Esmartdriver/esmart-hw-lib-pub/3dmodel/bga/BGA6N50P2X3_144X94X50.step

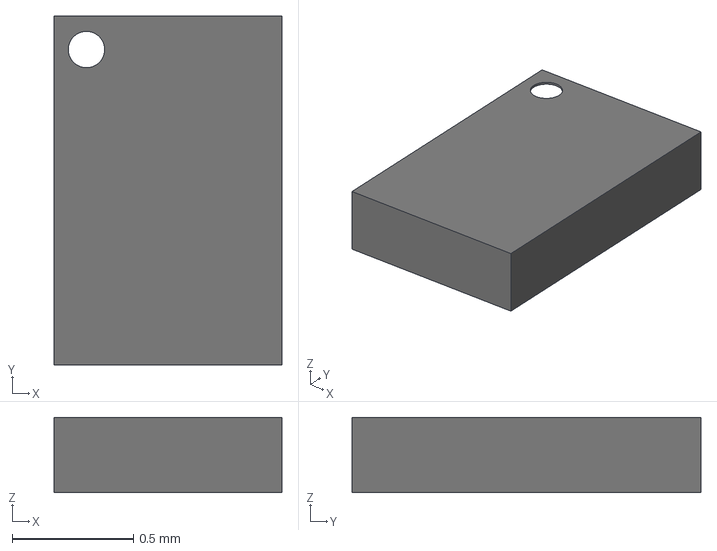
[picture p1: CAD file, 2025-03-11]
3dmodel/bga/BGA6N50P2X3_144X94X50.step
0.94 x 1.44 x 0.31 mm
