Esmartdriver/esmart-hw-lib-pub/3dmodel/clock/OSC3225-4.STEP

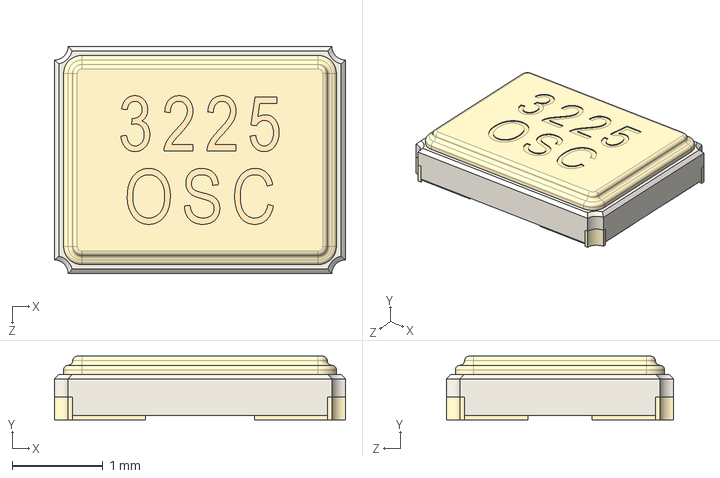
[picture p2: CAD file, 2025-03-11]
3dmodel/clock/OSC3225-4.STEP
3.20 x 0.7 x 2.50 mm
