Esmartdriver/esmart-hw-lib-pub/3dmodel/connector/PinHeader_2x07_P1.27mm_Vertical.step

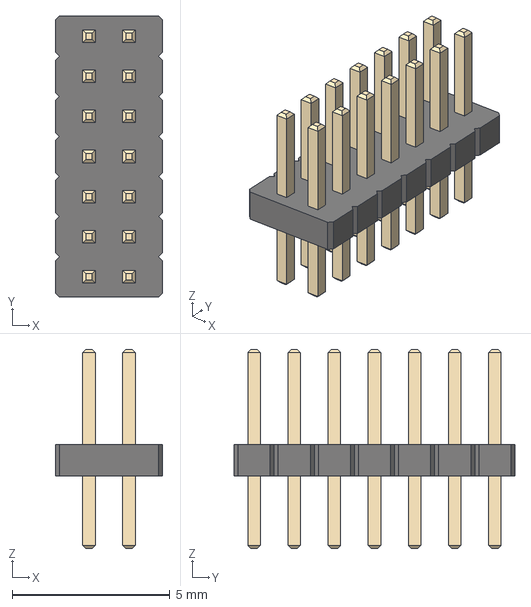
[picture p3: CAD file, 2025-03-11]
3dmodel/connector/PinHeader_2x07_P1.27mm_Vertical.step
3.40 x 8.89 x 6.30 mm
