Esmartdriver/esmart-hw-lib-pub/3dmodel/dfn/DFN100X100X55-5.step

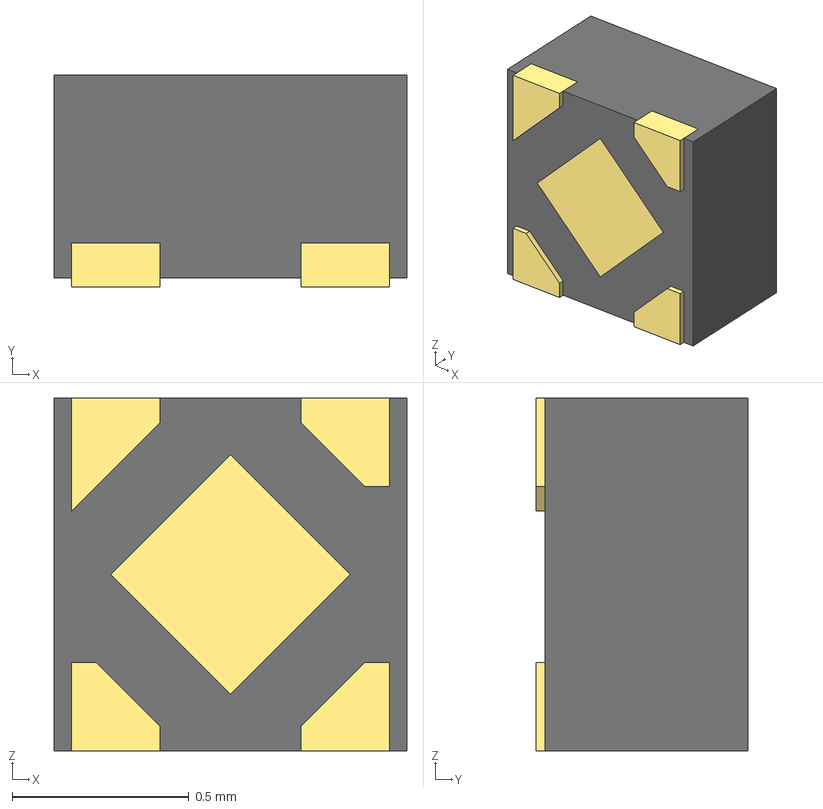
[picture p4: CAD file, 2025-03-11]
3dmodel/dfn/DFN100X100X55-5.step
1.00 x 0.6 x 1.00 mm
