Esmartdriver/esmart-hw-lib-pub/3dmodel/diode/Diode_SMC.step

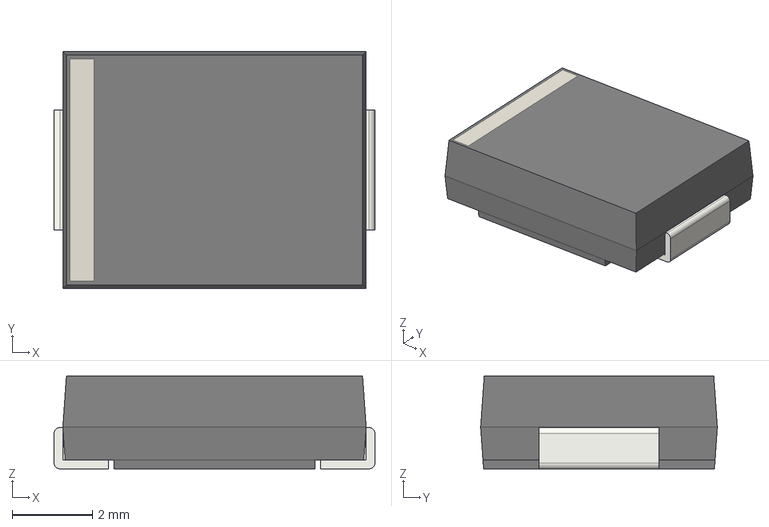
[picture p5: CAD file, 2025-03-11]
3dmodel/diode/Diode_SMC.step
8.00 x 5.90 x 2.31 mm
