Esmartdriver/esmart-hw-lib-pub/3dmodel/dip/DIP127P762X508-14.step

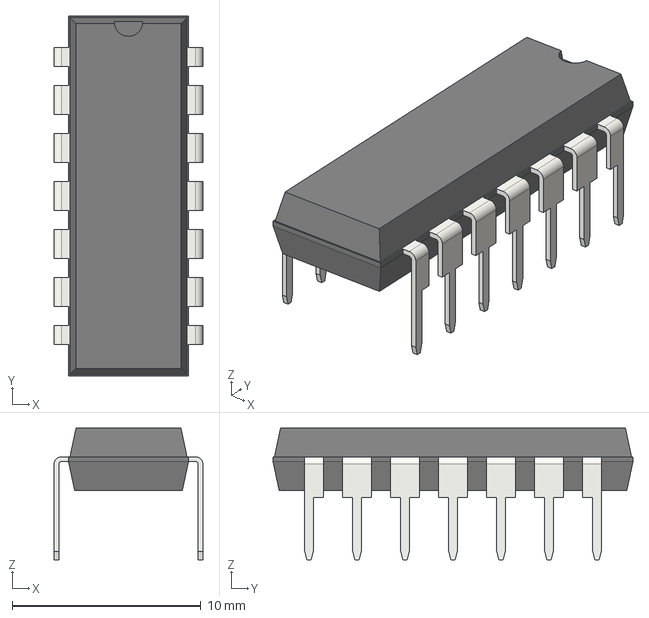
[picture p6: CAD file, 2025-03-11]
3dmodel/dip/DIP127P762X508-14.step
7.87 x 19.1 x 6.98 mm
