Esmartdriver/esmart-hw-lib-pub/3dmodel/led/LED_1608m_White.step

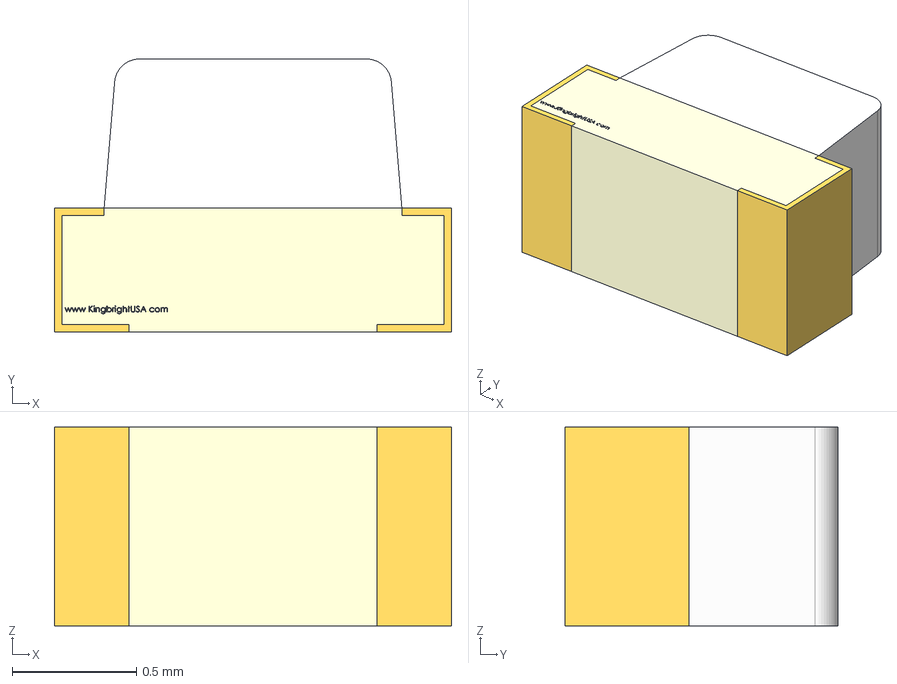
[picture p7: CAD file, 2025-03-11]
3dmodel/led/LED_1608m_White.step
1.60 x 1.10 x 0.8 mm
AP1608
AP1611
AP1610
AP1612
AP1609
