Esmartdriver/esmart-hw-lib-pub/3dmodel/lga/LGA50P300X250-14.step

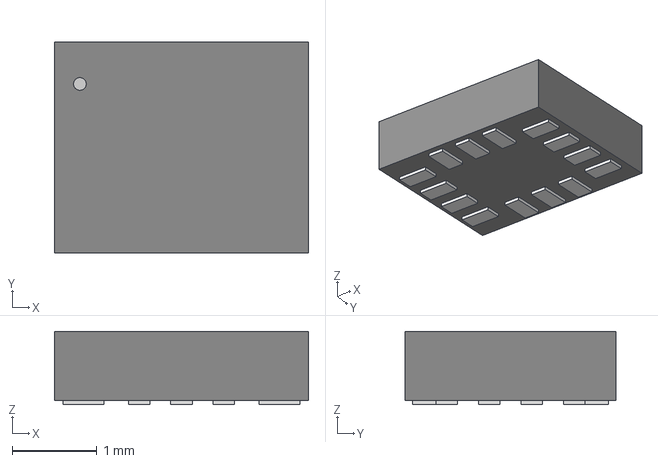
[picture p8: CAD file, 2025-03-11]
3dmodel/lga/LGA50P300X250-14.step
3.00 x 2.49 x 0.866 mm
