Esmartdriver/esmart-hw-lib-pub/3dmodel/mechanical/C&K_PN12SJNA03QE.stp

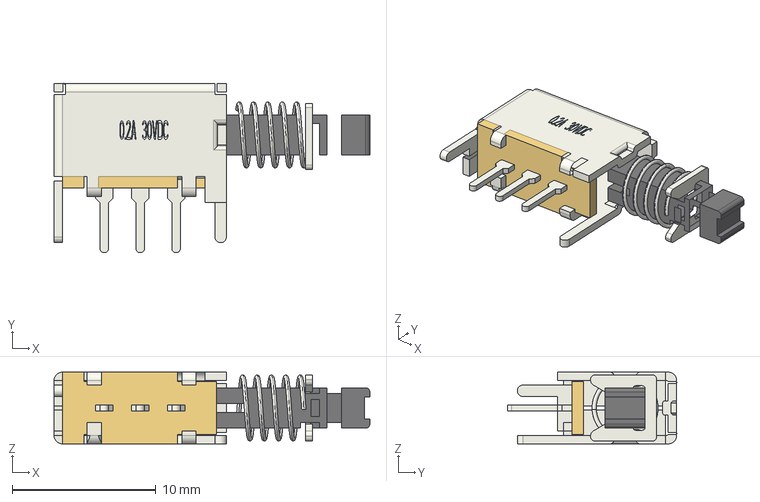
[picture p9: CAD file, 2025-03-11]
3dmodel/mechanical/C&K_PN12SJNA03QE.stp
22.0 x 11.8 x 5.00 mm
