Esmartdriver/esmart-hw-lib-pub/3dmodel/other/Knowles_SPU0410HR5H-PB.step

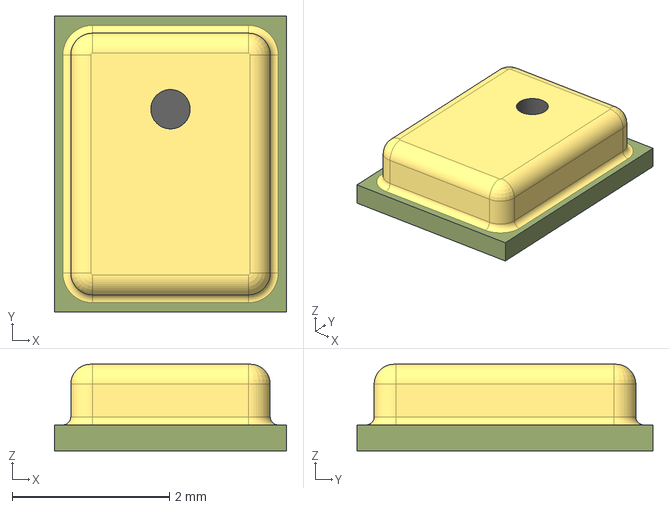
[picture p10: CAD file, 2025-03-11]
3dmodel/other/Knowles_SPU0410HR5H-PB.step
2.95 x 3.76 x 1.10 mm
