Esmartdriver/esmart-hw-lib-pub/3dmodel/passive/RESC1608.step

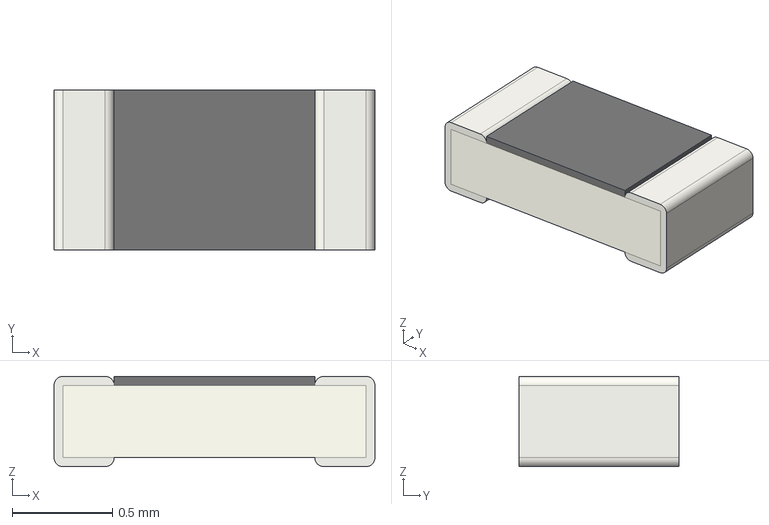
[picture p11: CAD file, 2025-03-11]
3dmodel/passive/RESC1608.step
1.60 x 0.8 x 0.45 mm
