Esmartdriver/esmart-hw-lib-pub/3dmodel/qfn/QFN50P160X160-8.step

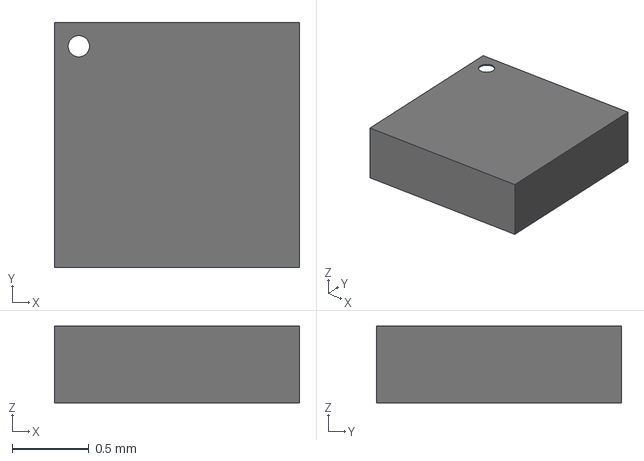
[picture p12: CAD file, 2025-03-11]
3dmodel/qfn/QFN50P160X160-8.step
1.60 x 1.60 x 0.5 mm
