Esmartdriver/esmart-hw-lib-pub/3dmodel/qfp/QFP50P700X700X120-48.step

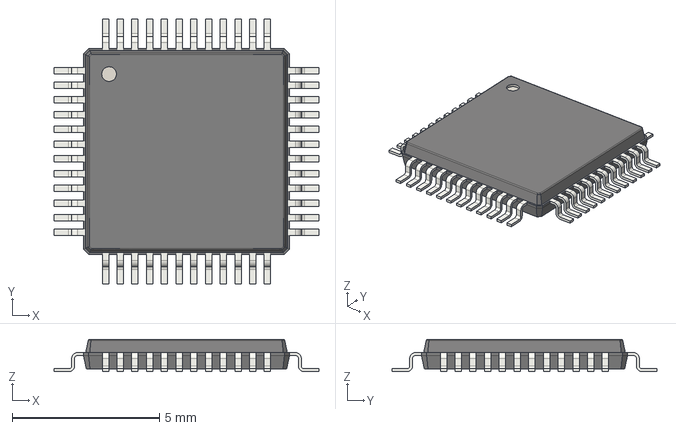
[picture p13: CAD file, 2025-03-11]
3dmodel/qfp/QFP50P700X700X120-48.step
9.00 x 9.00 x 1.10 mm
