Esmartdriver/esmart-hw-lib-pub/3dmodel/rf/johanson_0896BM15A0032.step

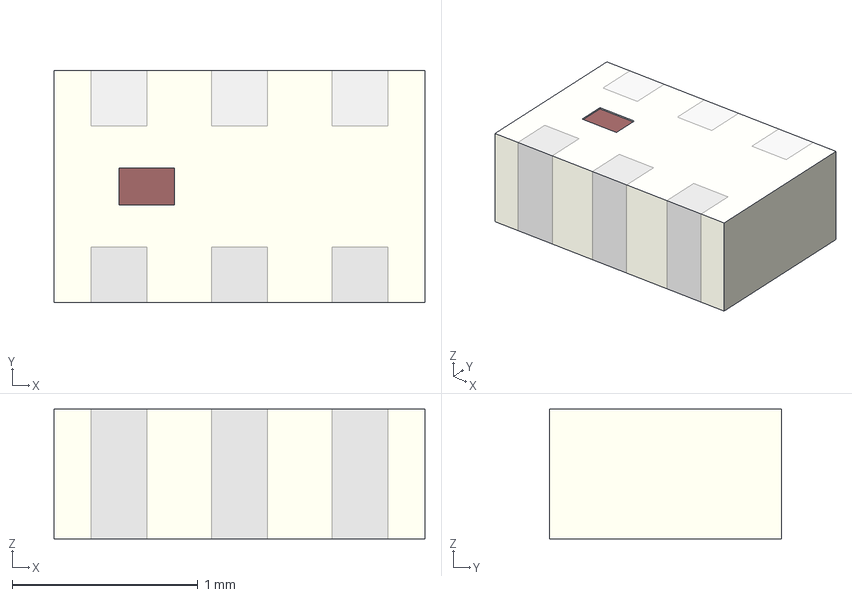
[picture p14: CAD file, 2025-03-11]
3dmodel/rf/johanson_0896BM15A0032.step
2.00 x 1.25 x 0.7 mm
