Esmartdriver/esmart-hw-lib-pub/3dmodel/so/PG-HSOF-8-1.step

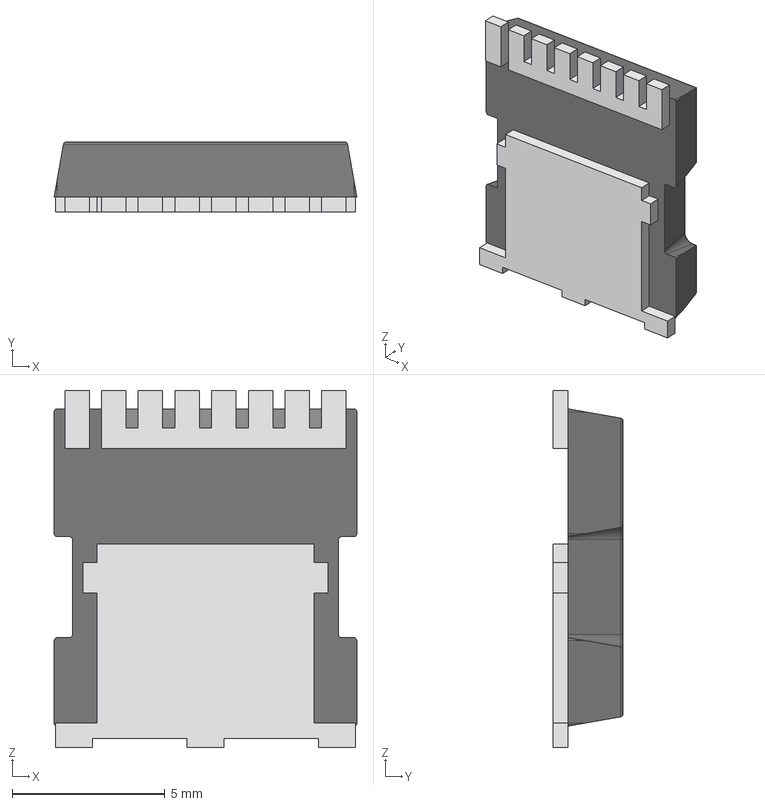
[picture p15: CAD file, 2025-03-11]
3dmodel/so/PG-HSOF-8-1.step
9.90 x 2.30 x 11.7 mm
