Esmartdriver/esmart-hw-lib-pub/3dmodel/sod/SOD-123F.step

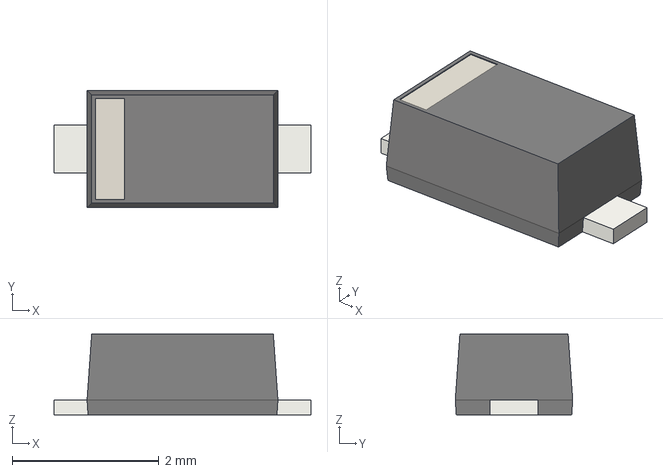
[picture p16: CAD file, 2025-03-11]
3dmodel/sod/SOD-123F.step
3.50 x 1.60 x 1.10 mm
