Esmartdriver/esmart-hw-lib-pub/3dmodel/soic/SOIC127P1790X750-28.step

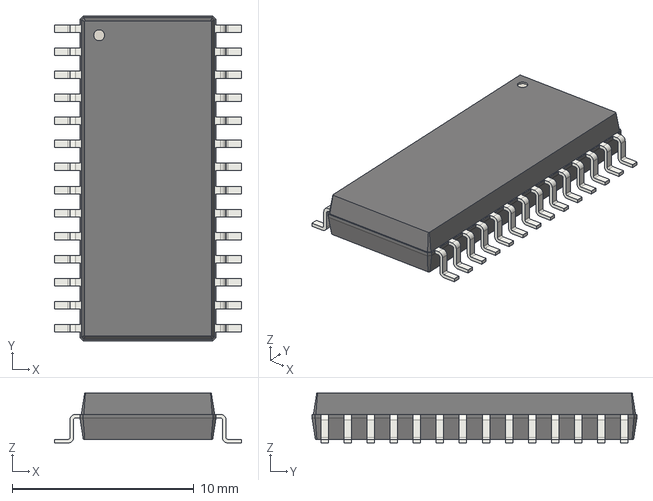
[picture p17: CAD file, 2025-03-11]
3dmodel/soic/SOIC127P1790X750-28.step
10.3 x 17.9 x 2.75 mm
