Esmartdriver/esmart-hw-lib-pub/3dmodel/som/silabs_MGM111.step

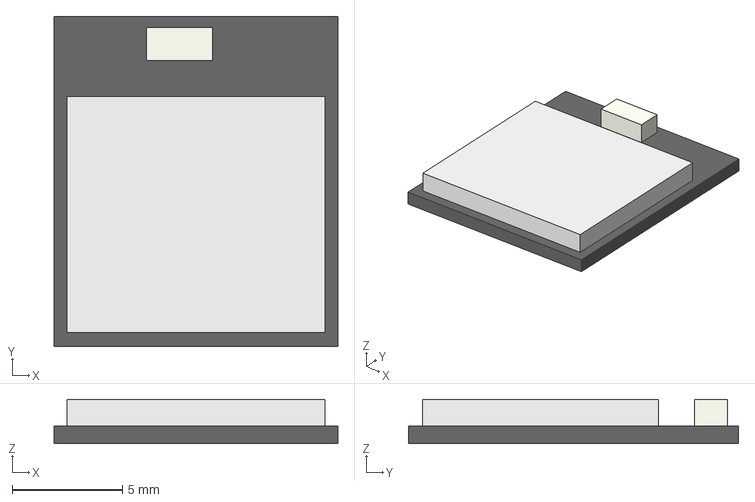
[picture p18: CAD file, 2025-03-11]
3dmodel/som/silabs_MGM111.step
12.9 x 15.0 x 2.00 mm
