Esmartdriver/esmart-hw-lib-pub/3dmodel/son/SON50P200X200X60-7.step

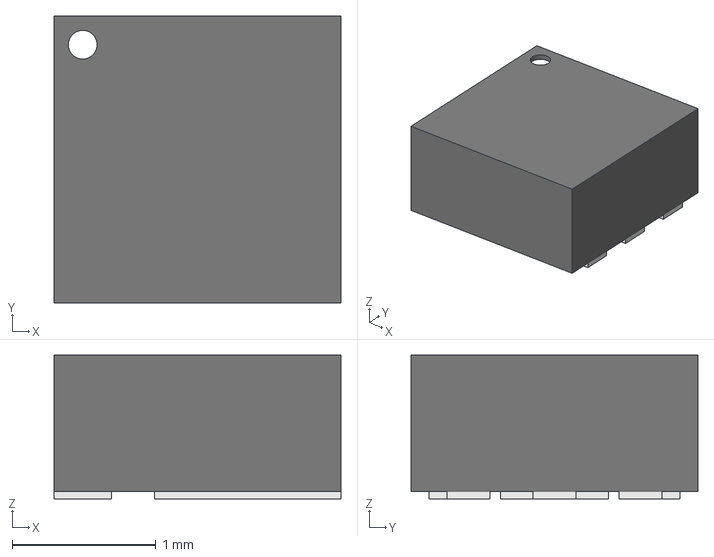
[picture p19: CAD file, 2025-03-11]
3dmodel/son/SON50P200X200X60-7.step
2.00 x 2.00 x 1.00 mm
