Esmartdriver/esmart-hw-lib-pub/3dmodel/sop/MSOP50P400X300-16.step

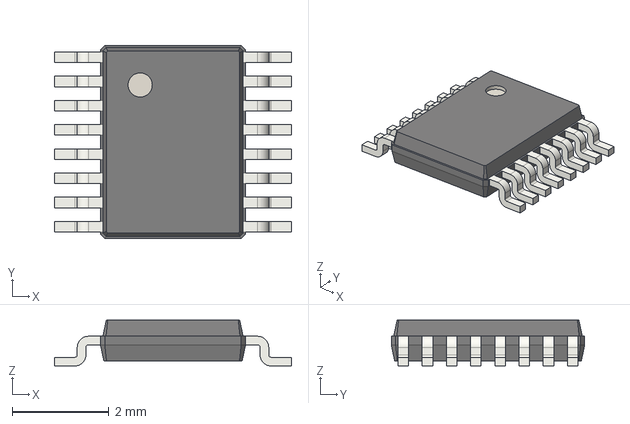
[picture p20: CAD file, 2025-03-11]
3dmodel/sop/MSOP50P400X300-16.step
4.90 x 4.00 x 0.95 mm
