Esmartdriver/esmart-hw-lib-pub/3dmodel/sot/SOT-665.step

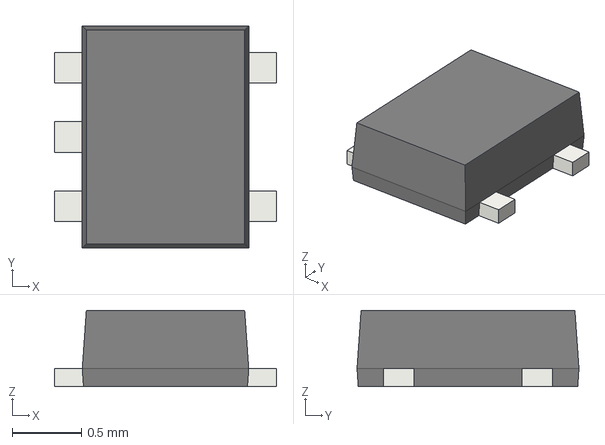
[picture p21: CAD file, 2025-03-11]
3dmodel/sot/SOT-665.step
1.60 x 1.60 x 0.55 mm
