Esmartdriver/esmart-hw-lib-pub/3dmodel/to/TO-220-3.step

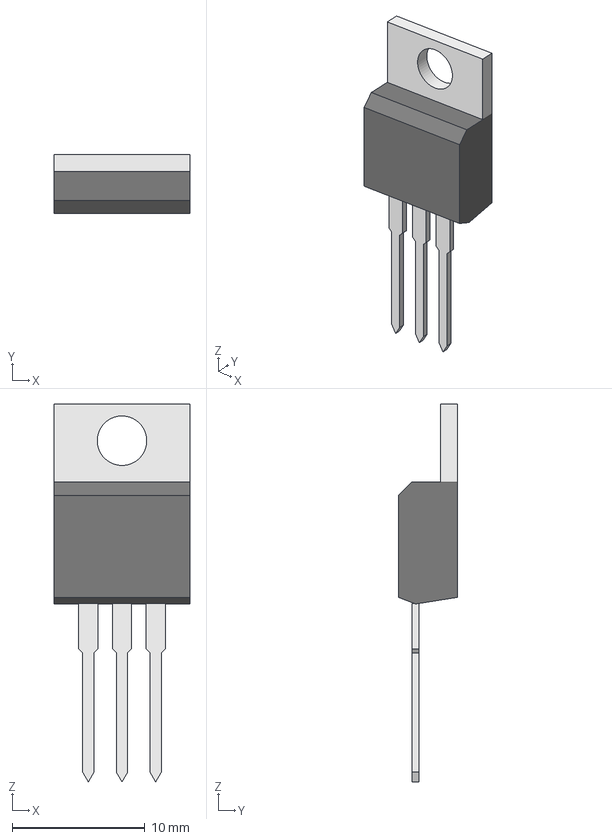
[picture p22: CAD file, 2025-03-11]
3dmodel/to/TO-220-3.step
10.2 x 4.46 x 28.5 mm
