Esmartdriver/esmart-hw-lib-pub/3dmodel/bga/BGA159N80P14X14_1200X1200X135.step

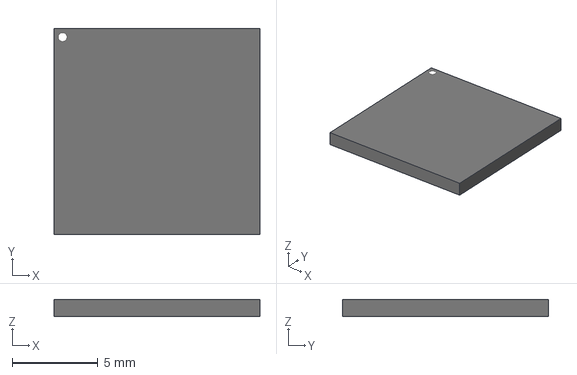
[picture p23: CAD file, 2025-03-11]
3dmodel/bga/BGA159N80P14X14_1200X1200X135.step
12.0 x 12.0 x 1.00 mm
