Esmartdriver/esmart-hw-lib-pub/3dmodel/clock/OSC2520-4.STEP

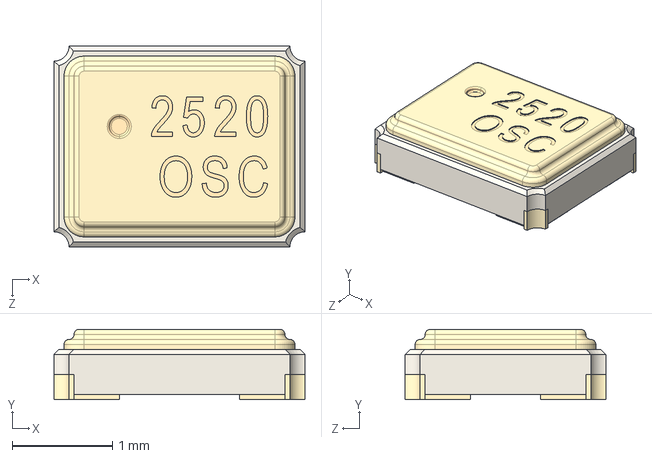
[picture p24: CAD file, 2025-03-11]
3dmodel/clock/OSC2520-4.STEP
2.50 x 0.7 x 2.00 mm
