Esmartdriver/esmart-hw-lib-pub/3dmodel/connector/pxc_1808832.stp

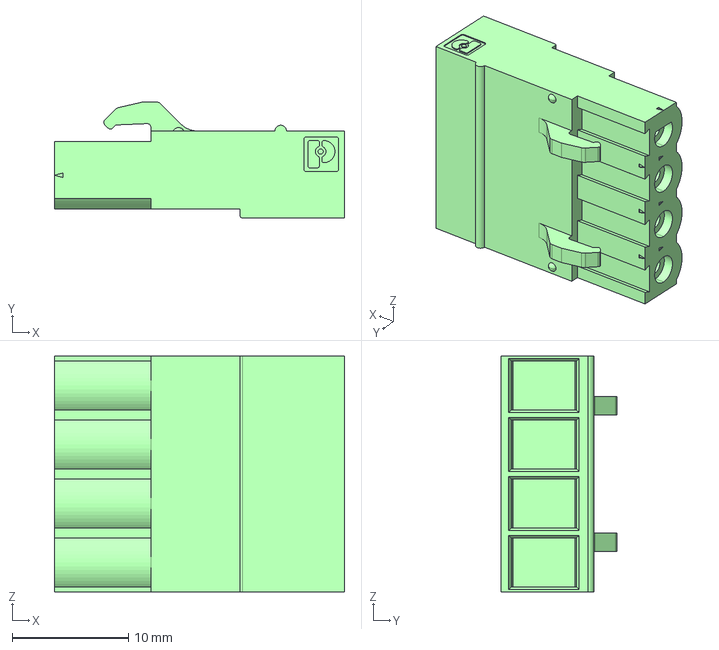
[picture p25: CAD file, 2025-03-11]
3dmodel/connector/pxc_1808832.stp
25.0 x 10.0 x 20.3 mm
