Esmartdriver/esmart-hw-lib-pub/3dmodel/dfn/DFN300X300X75-10.step

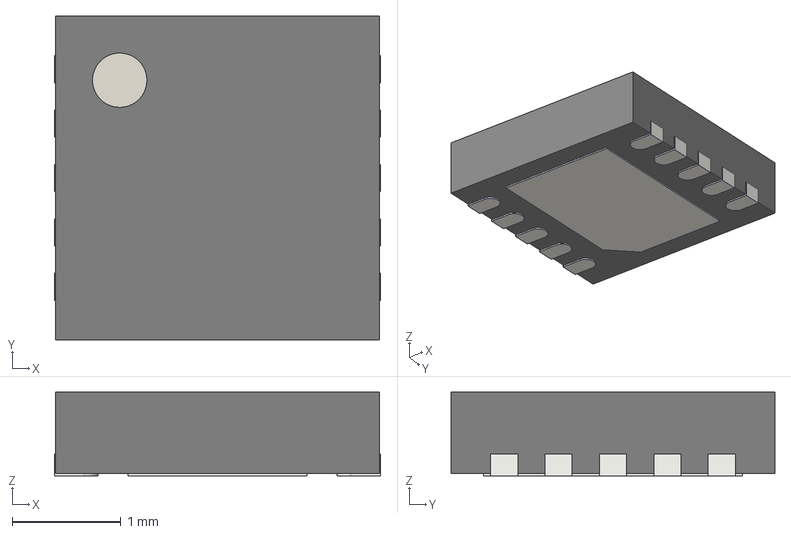
[picture p26: CAD file, 2025-03-11]
3dmodel/dfn/DFN300X300X75-10.step
3.00 x 2.98 x 0.77 mm
