Esmartdriver/esmart-hw-lib-pub/3dmodel/diode/TO-277A.step

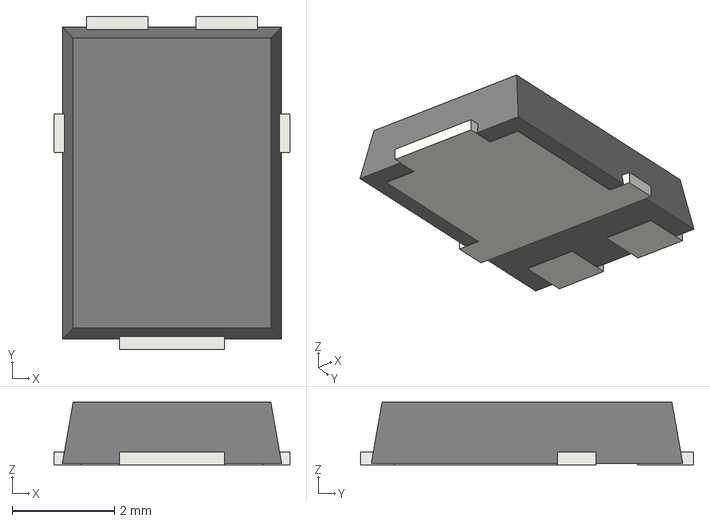
[picture p27: CAD file, 2025-03-11]
3dmodel/diode/TO-277A.step
4.60 x 6.50 x 1.22 mm
