Esmartdriver/esmart-hw-lib-pub/3dmodel/dip/DIP127P762X508-8.step

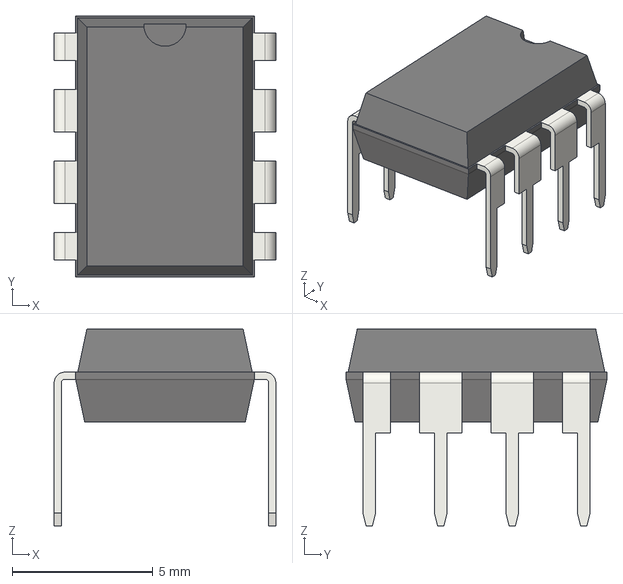
[picture p28: CAD file, 2025-03-11]
3dmodel/dip/DIP127P762X508-8.step
7.87 x 9.27 x 6.98 mm
