Esmartdriver/esmart-hw-lib-pub/3dmodel/lga/LGA50P300X300-16.step

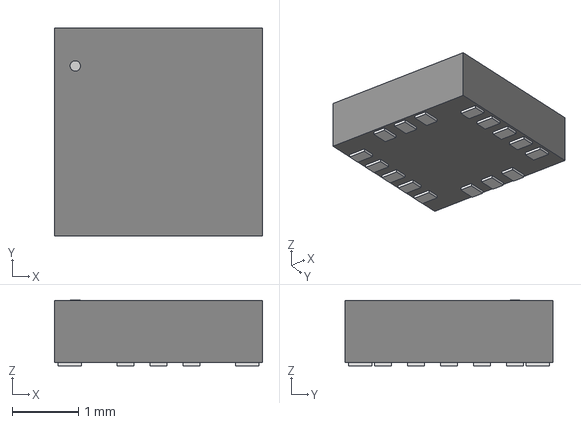
[picture p29: CAD file, 2025-03-11]
3dmodel/lga/LGA50P300X300-16.step
3.15 x 3.15 x 0.993 mm
