Esmartdriver/esmart-hw-lib-pub/3dmodel/mechanical/Wurth_9774015151.stp

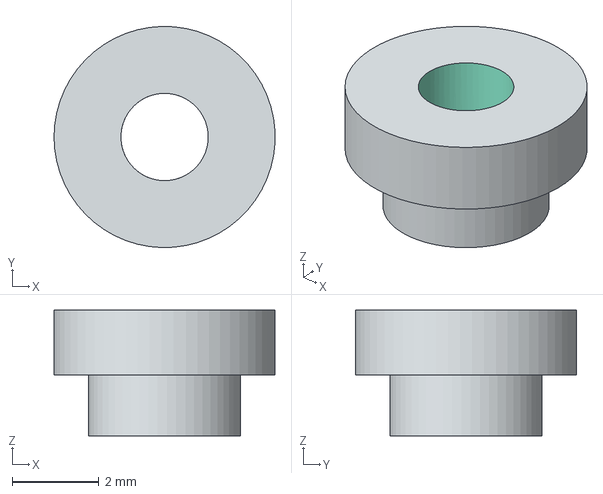
[picture p30: CAD file, 2025-03-11]
3dmodel/mechanical/Wurth_9774015151.stp
5.10 x 5.10 x 2.90 mm
