Esmartdriver/esmart-hw-lib-pub/3dmodel/other/Keystone_3557-2.STEP

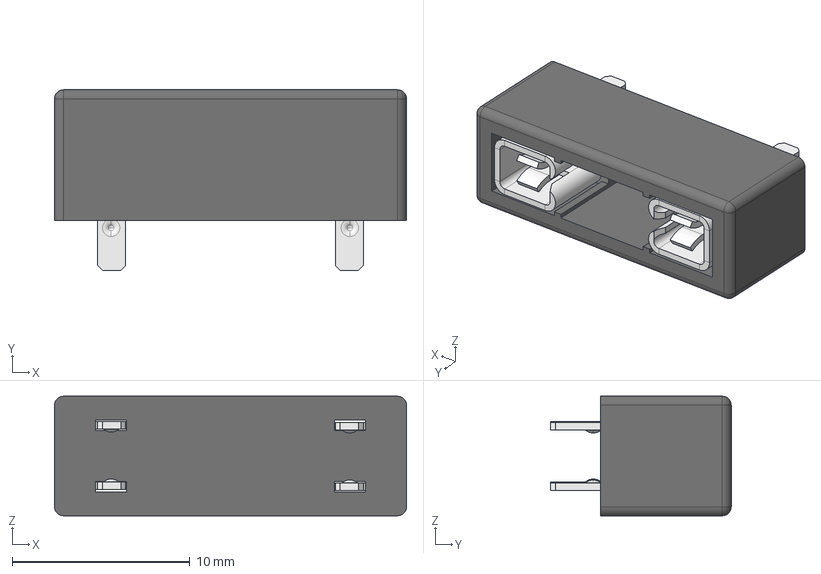
[picture p31: CAD file, 2025-03-11]
3dmodel/other/Keystone_3557-2.STEP
19.8 x 10.2 x 6.73 mm
