Esmartdriver/esmart-hw-lib-pub/3dmodel/passive/CAPAE630X990.step

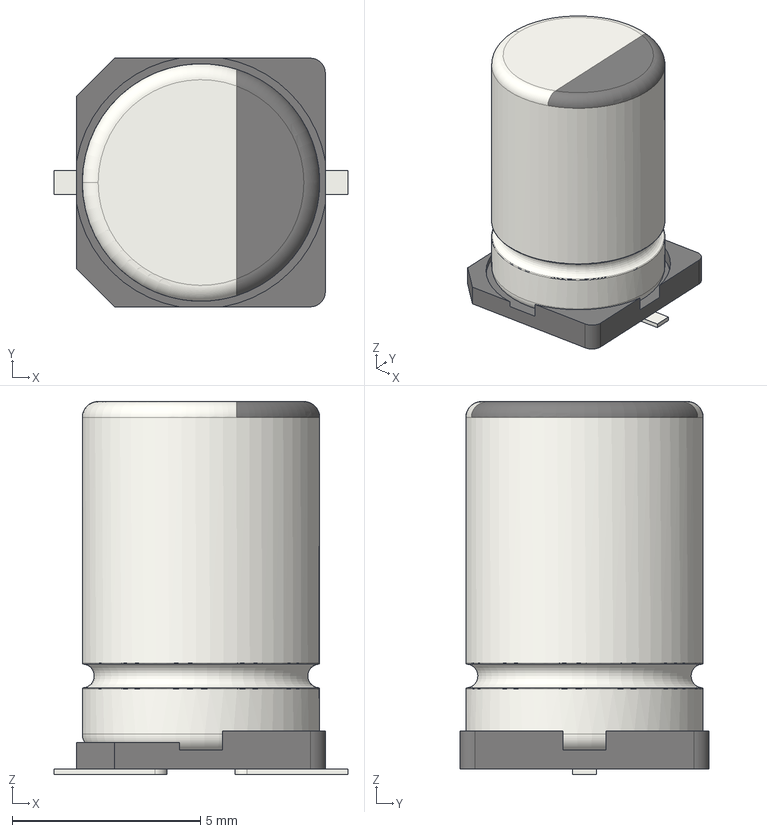
[picture p32: CAD file, 2025-03-11]
3dmodel/passive/CAPAE630X990.step
7.80 x 6.60 x 9.90 mm
