Esmartdriver/esmart-hw-lib-pub/3dmodel/qfn/QFN50P400X350-17.step

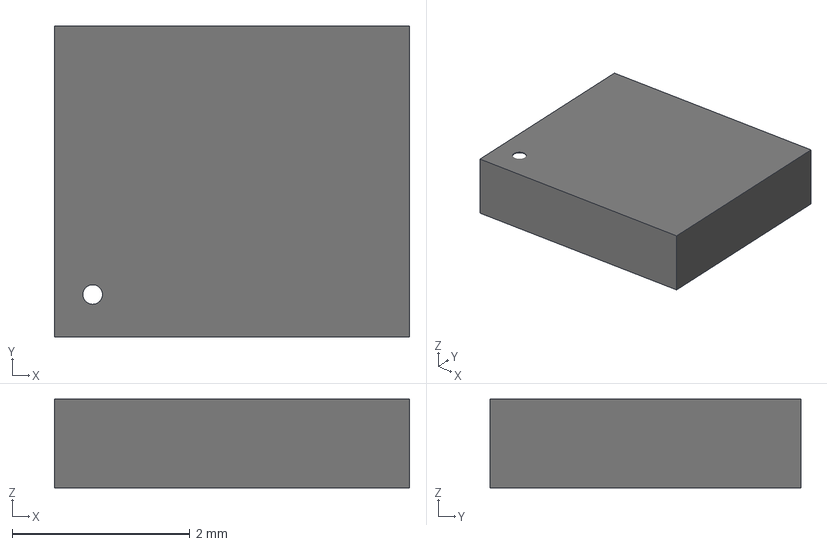
[picture p33: CAD file, 2025-03-11]
3dmodel/qfn/QFN50P400X350-17.step
4.00 x 3.50 x 1.00 mm
