Esmartdriver/esmart-hw-lib-pub/3dmodel/qfp/QFP40P1600X1600X120-128.step

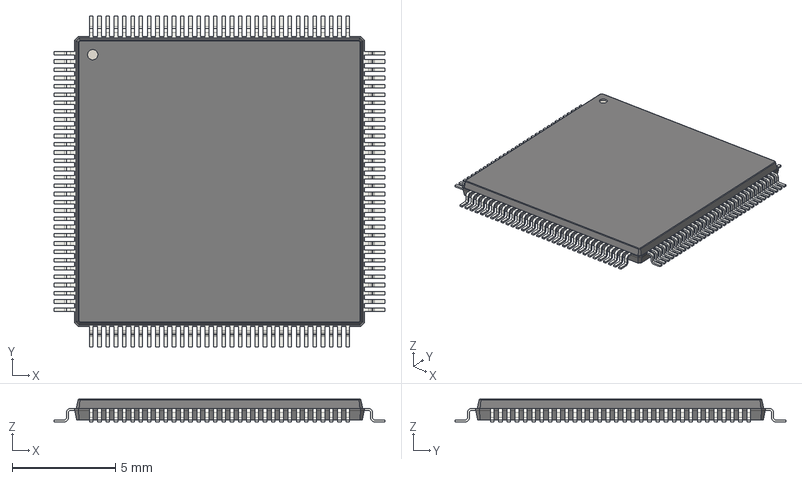
[picture p34: CAD file, 2025-03-11]
3dmodel/qfp/QFP40P1600X1600X120-128.step
16.0 x 16.0 x 1.10 mm
