Esmartdriver/esmart-hw-lib-pub/3dmodel/rf/qualcomm_saw_140X110-5.step

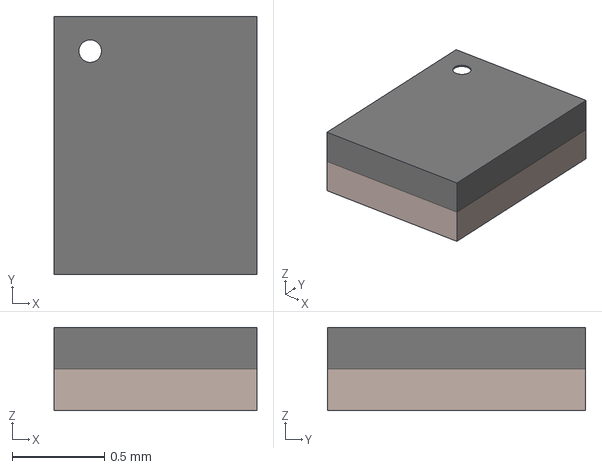
[picture p35: CAD file, 2025-03-11]
3dmodel/rf/qualcomm_saw_140X110-5.step
1.10 x 1.40 x 0.45 mm
