Esmartdriver/esmart-hw-lib-pub/3dmodel/so/PowerSSO-16.step

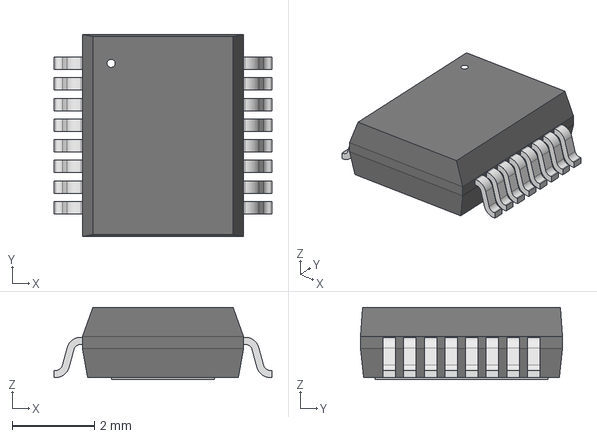
[picture p36: CAD file, 2025-03-11]
3dmodel/so/PowerSSO-16.step
5.29 x 4.90 x 1.75 mm
