Esmartdriver/esmart-hw-lib-pub/3dmodel/sod/SOD-110.step

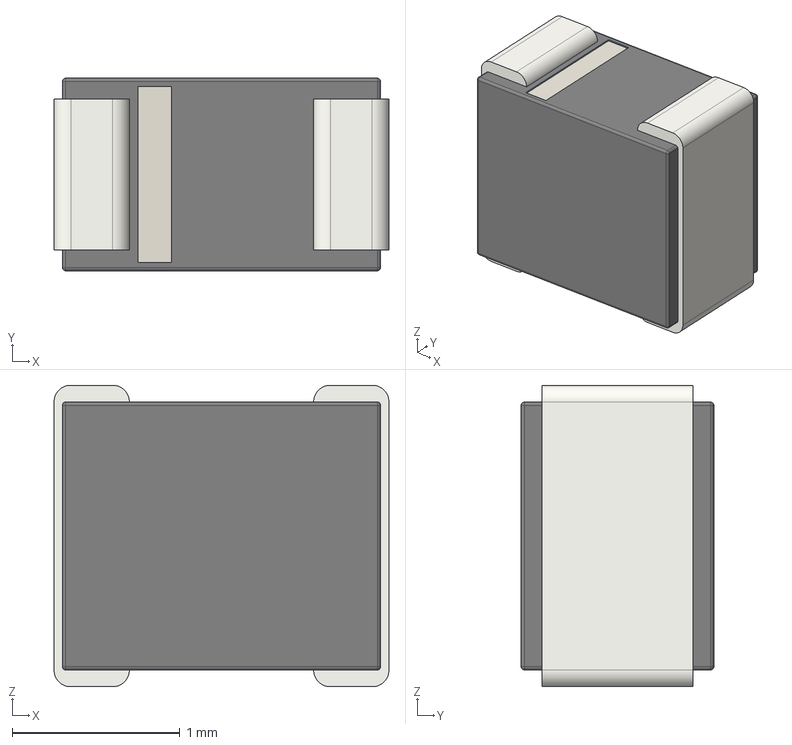
[picture p37: CAD file, 2025-03-11]
3dmodel/sod/SOD-110.step
2.00 x 1.15 x 1.80 mm
