Esmartdriver/esmart-hw-lib-pub/3dmodel/soic/SOIC127P788X200-8.step

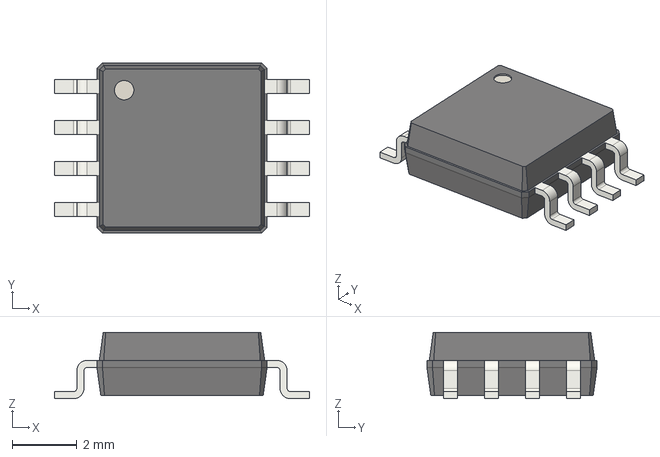
[picture p38: CAD file, 2025-03-11]
3dmodel/soic/SOIC127P788X200-8.step
7.90 x 5.28 x 2.06 mm
