Esmartdriver/esmart-hw-lib-pub/3dmodel/som/telit_SE868.step

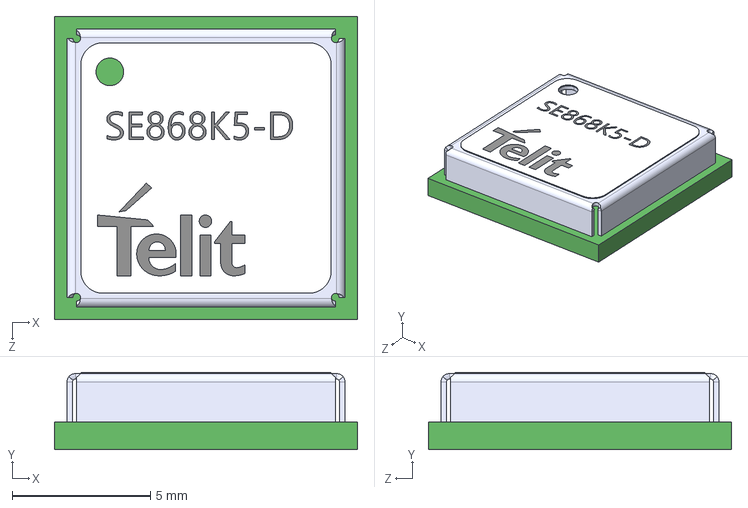
[picture p39: CAD file, 2025-03-11]
3dmodel/som/telit_SE868.step
10.9 x 2.80 x 10.9 mm
