Esmartdriver/esmart-hw-lib-pub/3dmodel/son/SON80P400X400X60-9.step

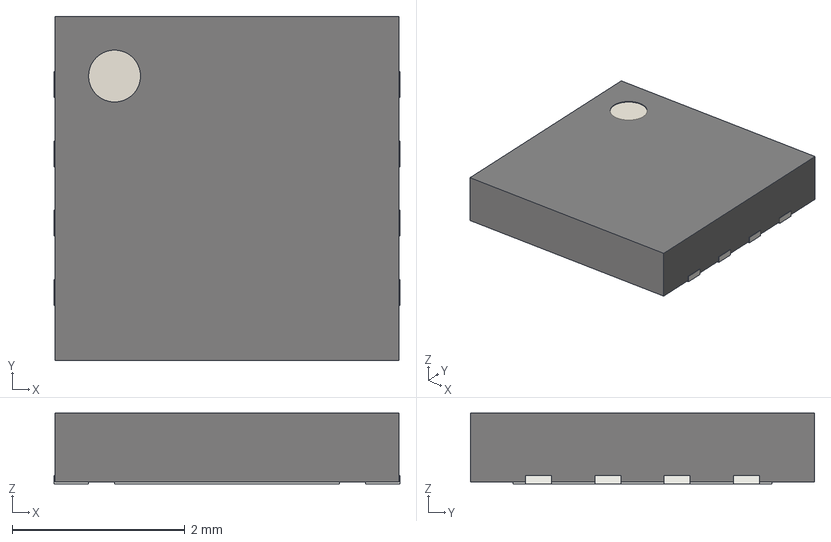
[picture p40: CAD file, 2025-03-11]
3dmodel/son/SON80P400X400X60-9.step
4.00 x 3.98 x 0.82 mm
