Esmartdriver/esmart-hw-lib-pub/3dmodel/sop/SOP254P410X380-4.step

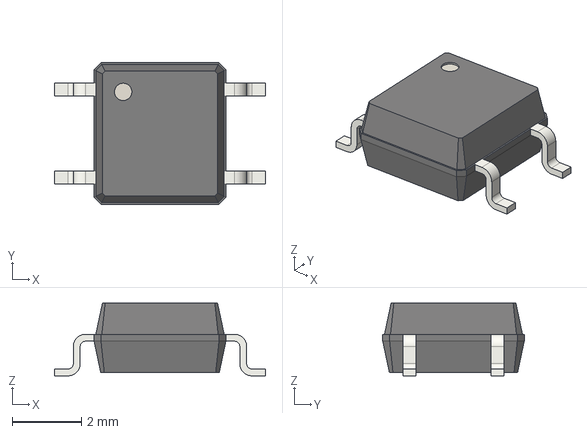
[picture p41: CAD file, 2025-03-11]
3dmodel/sop/SOP254P410X380-4.step
6.10 x 4.09 x 2.10 mm
