Esmartdriver/esmart-hw-lib-pub/3dmodel/sot/SOT100P180X80-3.step

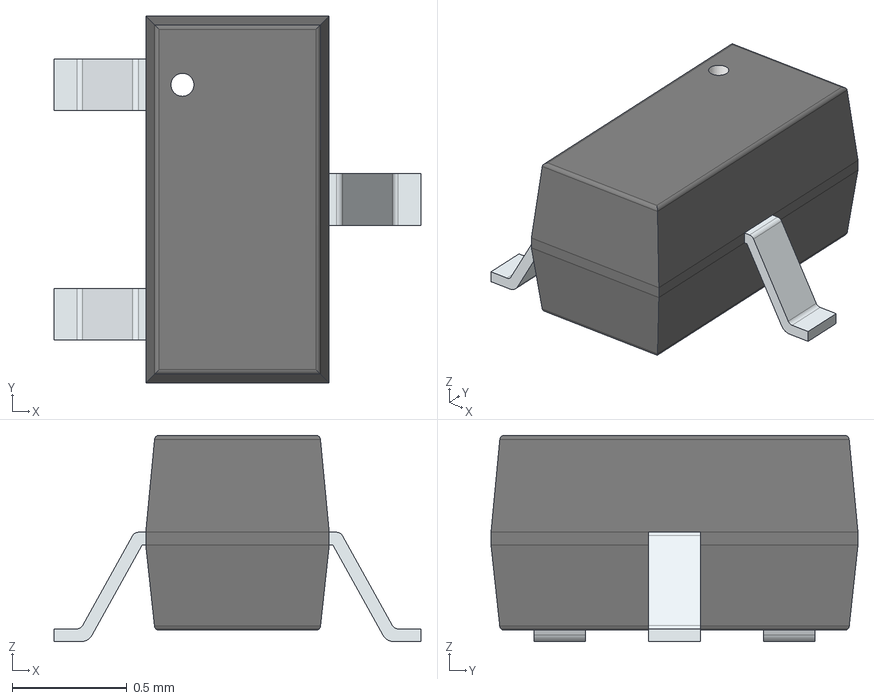
[picture p42: CAD file, 2025-03-11]
3dmodel/sot/SOT100P180X80-3.step
1.60 x 1.60 x 0.9 mm
PinsArrayL
PinsArrayL001
FilletPinR
