Esmartdriver/esmart-hw-lib-pub/3dmodel/to/TO-126-3.step

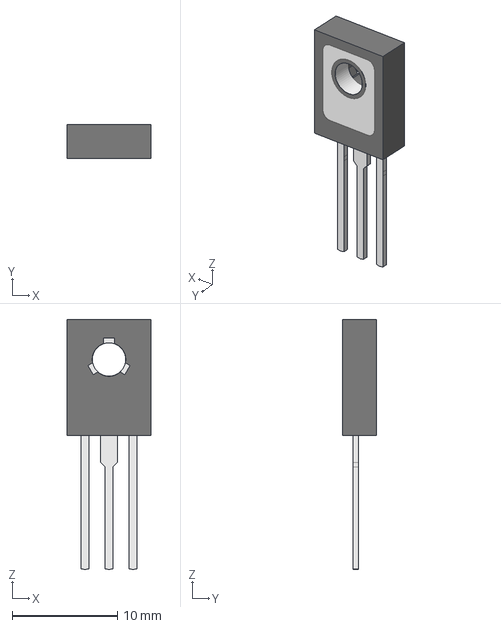
[picture p43: CAD file, 2025-03-11]
3dmodel/to/TO-126-3.step
8.00 x 3.25 x 23.8 mm
