Esmartdriver/esmart-hw-lib-pub/3dmodel/bga/BGA381N80P20X20_1700X1700X176.step

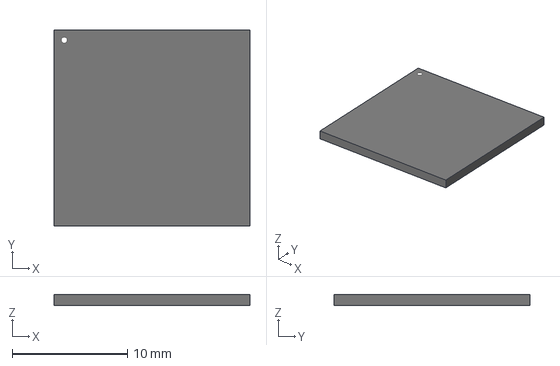
[picture p44: CAD file, 2025-03-11]
3dmodel/bga/BGA381N80P20X20_1700X1700X176.step
17.0 x 17.0 x 0.96 mm
