Esmartdriver/esmart-hw-lib-pub/3dmodel/clock/Abracon_ASE.STEP

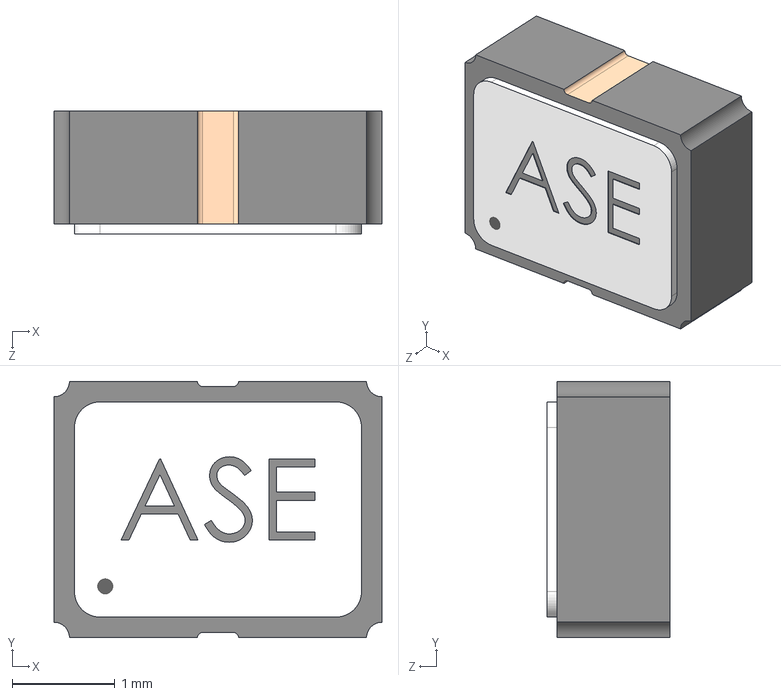
[picture p45: CAD file, 2025-03-11]
3dmodel/clock/Abracon_ASE.STEP
3.20 x 2.50 x 1.20 mm
