Esmartdriver/esmart-hw-lib-pub/3dmodel/connector/TE_5-103960-4.stp

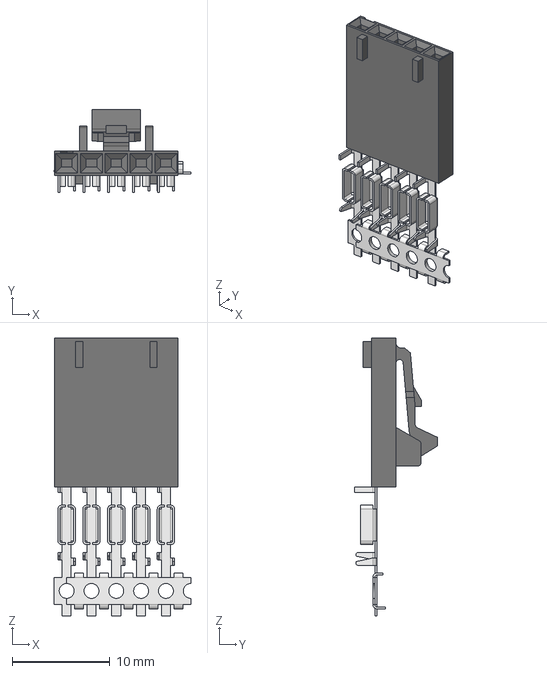
[picture p46: CAD file, 2025-03-11]
3dmodel/connector/TE_5-103960-4.stp
14.0 x 8.48 x 28.4 mm
