Esmartdriver/esmart-hw-lib-pub/3dmodel/dfn/DFN50P200X100-8.step

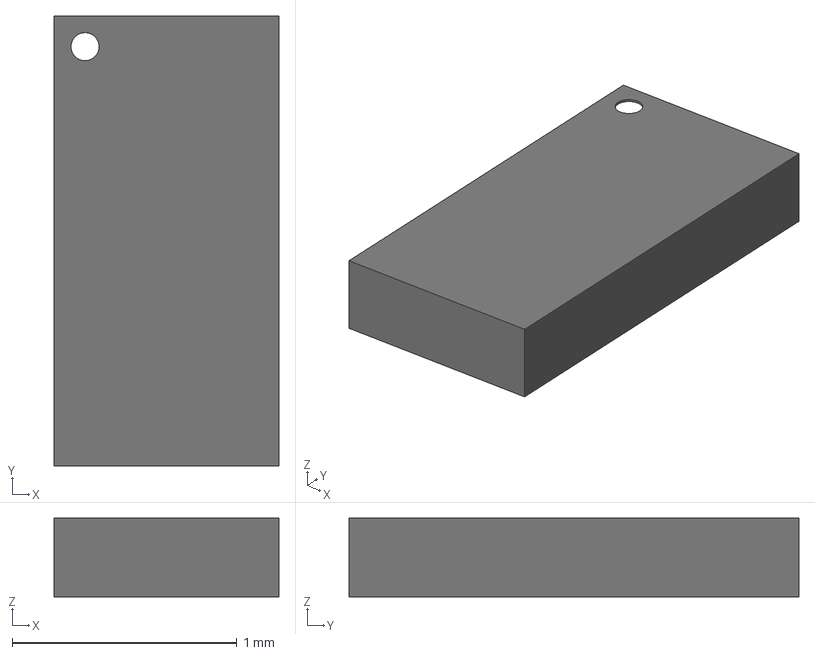
[picture p47: CAD file, 2025-03-11]
3dmodel/dfn/DFN50P200X100-8.step
1.00 x 2.00 x 0.35 mm
