Esmartdriver/esmart-hw-lib-pub/3dmodel/diode/Diode_SMA.step

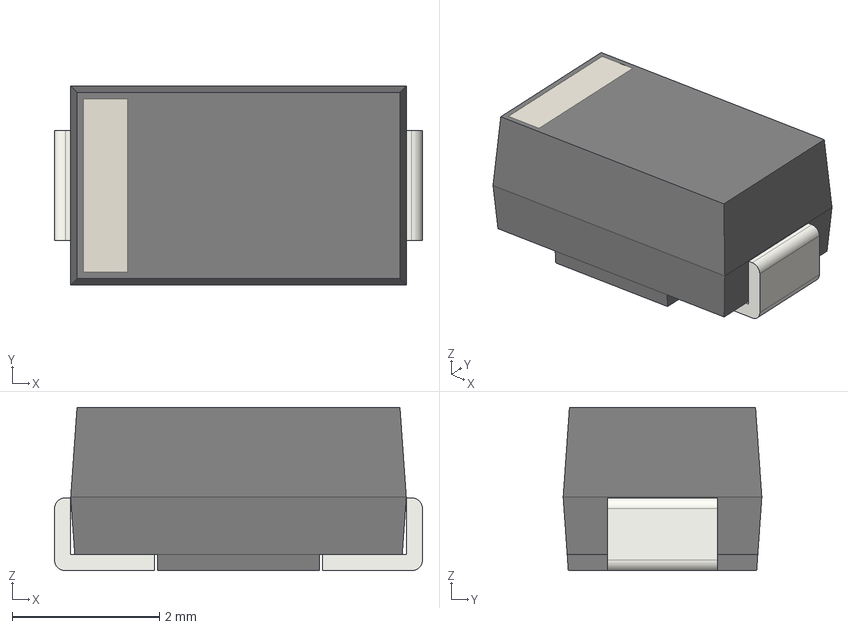
[picture p48: CAD file, 2025-03-11]
3dmodel/diode/Diode_SMA.step
5.00 x 2.70 x 2.22 mm
