Esmartdriver/esmart-hw-lib-pub/3dmodel/led/LED_REEred_1005.step

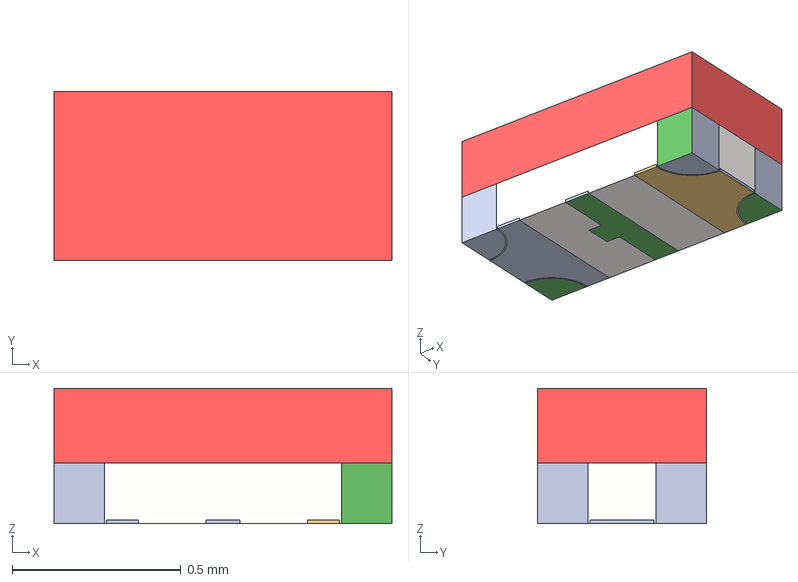
[picture p49: CAD file, 2025-03-11]
3dmodel/led/LED_REEred_1005.step
1.00 x 0.5 x 0.4 mm
Contact
Contact001
Contact002
Contact003
Contact004
Contact005
Contact006
Contact007
Linse
Linse001
Linse002
Linse003
Linse004
Linse005
Linse006
Linse007
Linse008
