Esmartdriver/esmart-hw-lib-pub/3dmodel/mechanical/TE_RZ_5mm_relay.step

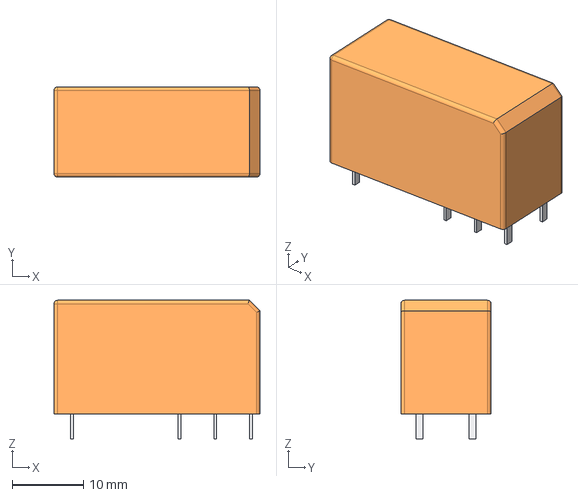
[picture p50: CAD file, 2025-03-11]
3dmodel/mechanical/TE_RZ_5mm_relay.step
29.0 x 12.7 x 19.5 mm
