Esmartdriver/esmart-hw-lib-pub/3dmodel/other/Osram_SFH7072.step

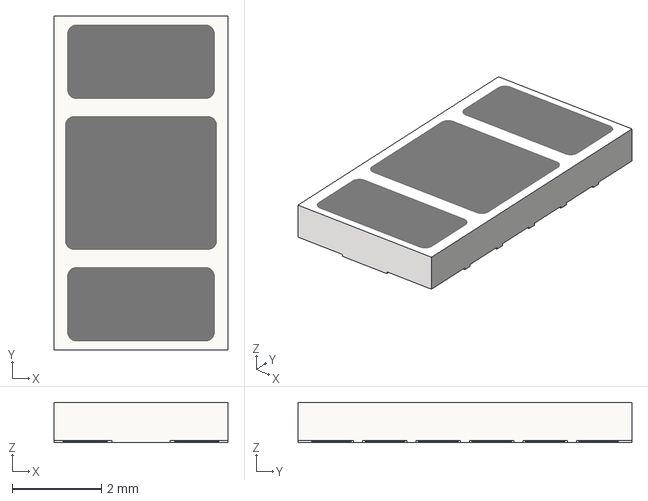
[picture p51: CAD file, 2025-03-11]
3dmodel/other/Osram_SFH7072.step
3.90 x 7.50 x 0.9 mm
