Esmartdriver/esmart-hw-lib-pub/3dmodel/passive/RESMELF0207.stp

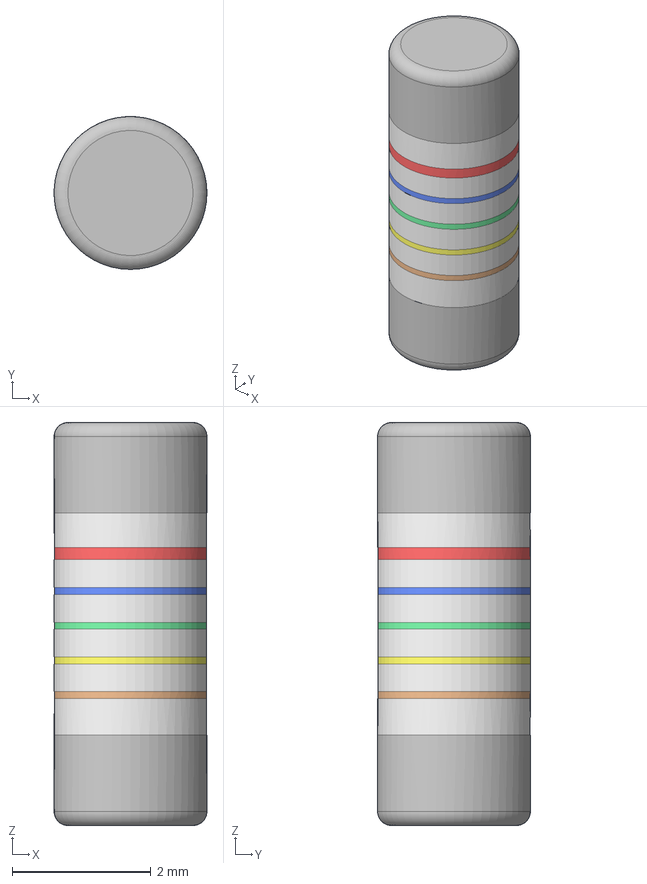
[picture p52: CAD file, 2025-03-11]
3dmodel/passive/RESMELF0207.stp
2.20 x 2.20 x 5.80 mm
