Esmartdriver/esmart-hw-lib-pub/3dmodel/qfn/QFN50P350X250-17.step

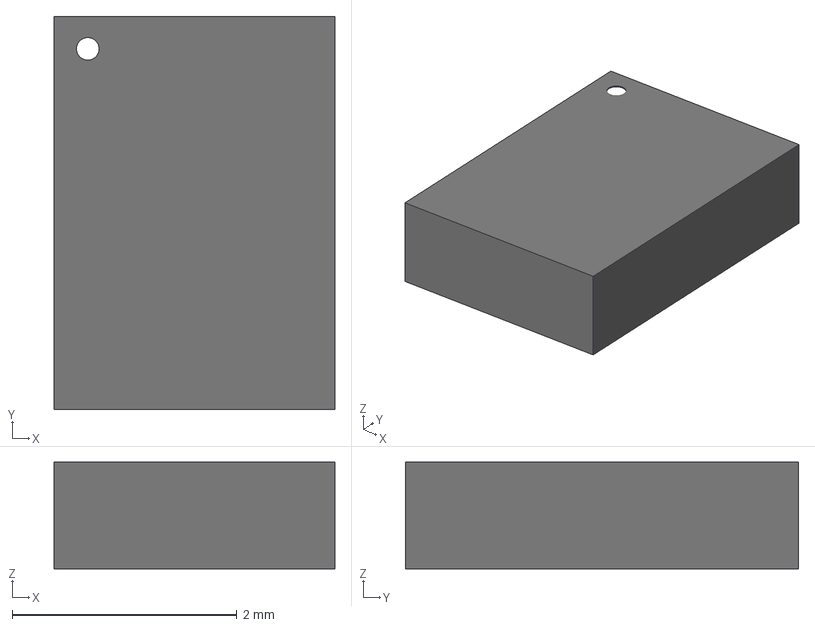
[picture p53: CAD file, 2025-03-11]
3dmodel/qfn/QFN50P350X250-17.step
2.50 x 3.50 x 0.95 mm
