Esmartdriver/esmart-hw-lib-pub/3dmodel/so/PowerPAK-8x8L-dual.stp

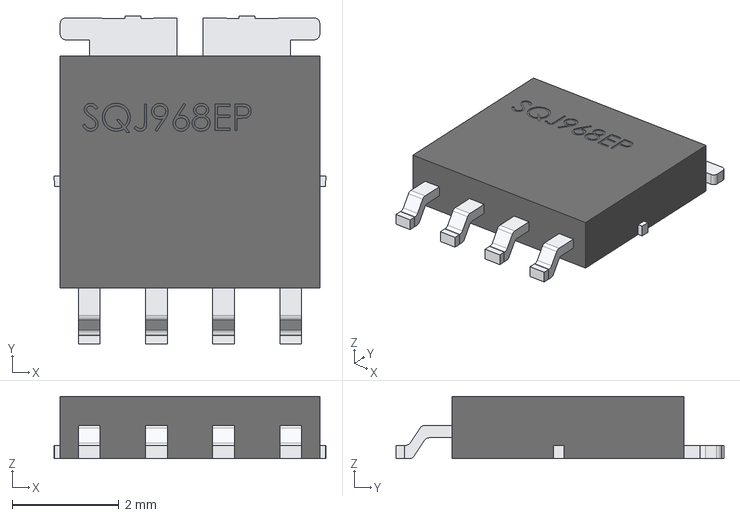
[picture p54: CAD file, 2025-03-11]
3dmodel/so/PowerPAK-8x8L-dual.stp
5.10 x 6.16 x 1.17 mm
