Esmartdriver/esmart-hw-lib-pub/3dmodel/sod/SOD-323F.step

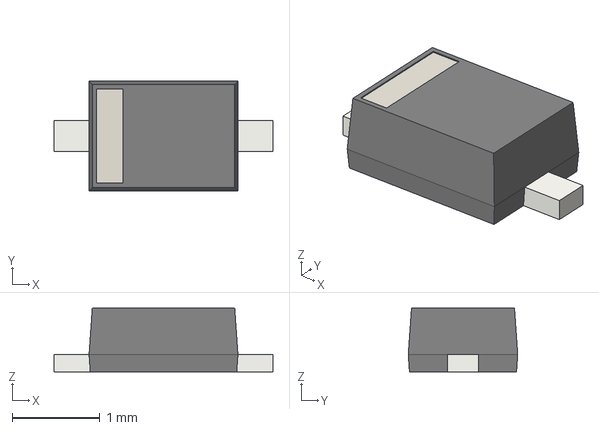
[picture p55: CAD file, 2025-03-11]
3dmodel/sod/SOD-323F.step
2.50 x 1.25 x 0.73 mm
