Esmartdriver/esmart-hw-lib-pub/3dmodel/soic/SOIC127P600X150-8.step

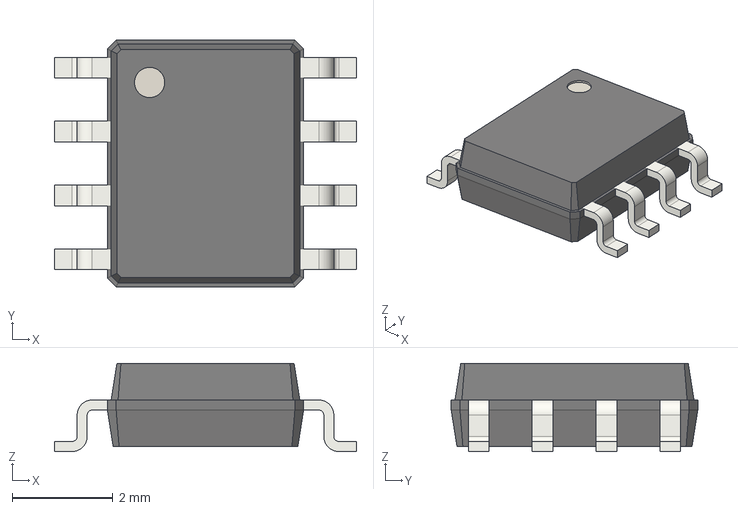
[picture p56: CAD file, 2025-03-11]
3dmodel/soic/SOIC127P600X150-8.step
6.00 x 4.90 x 1.75 mm
