Esmartdriver/esmart-hw-lib-pub/3dmodel/som/RO-2412S.step

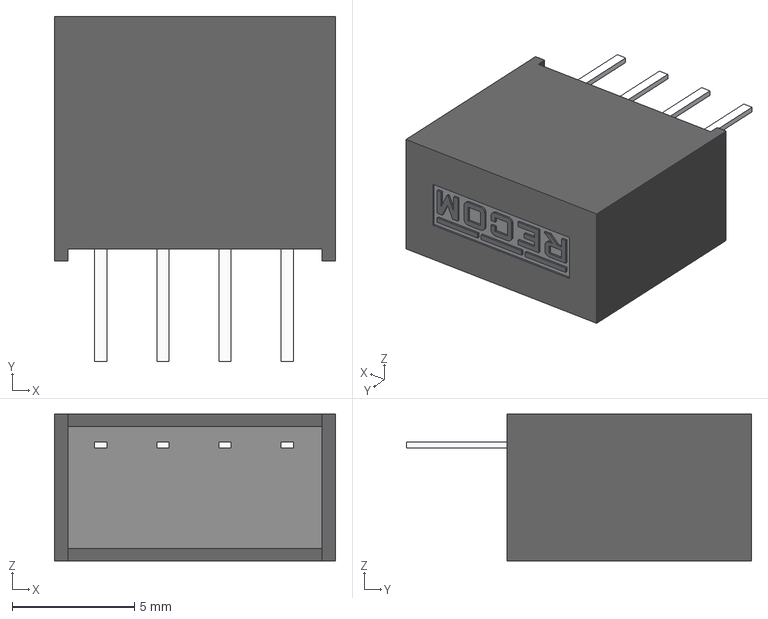
[picture p57: CAD file, 2025-03-11]
3dmodel/som/RO-2412S.step
11.5 x 14.1 x 6.00 mm
