Esmartdriver/esmart-hw-lib-pub/3dmodel/son/SON127P800X600X60-9.step

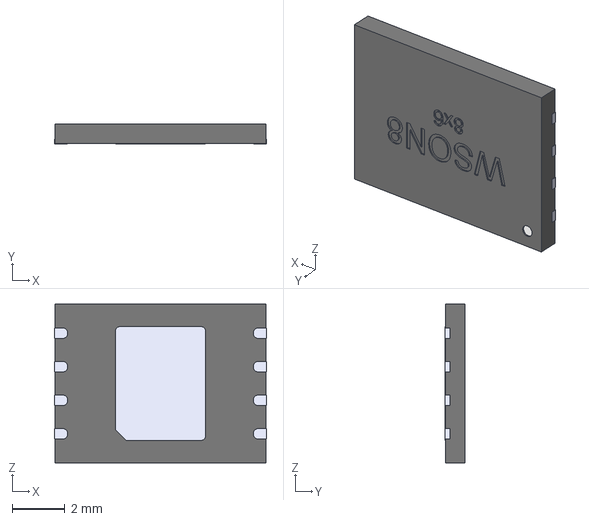
[picture p58: CAD file, 2025-03-11]
3dmodel/son/SON127P800X600X60-9.step
8.02 x 0.77 x 6.00 mm
