Esmartdriver/esmart-hw-lib-pub/3dmodel/sop/MSOP50P300X300-11.step

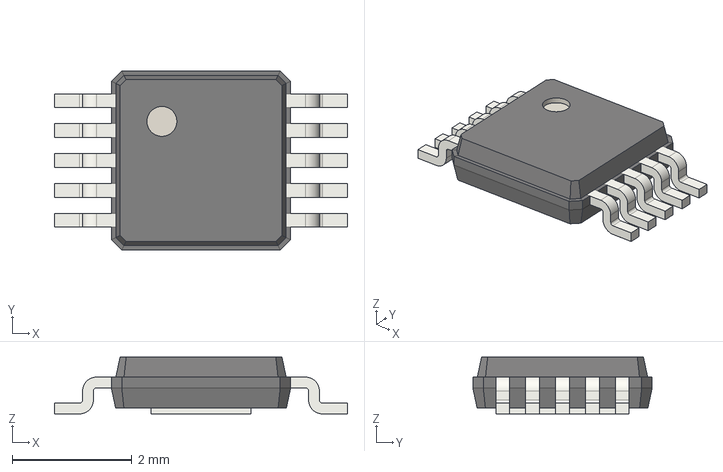
[picture p59: CAD file, 2025-03-11]
3dmodel/sop/MSOP50P300X300-11.step
4.90 x 3.00 x 0.95 mm
