Esmartdriver/esmart-hw-lib-pub/3dmodel/sot/SOTFL50P160X80-3.step

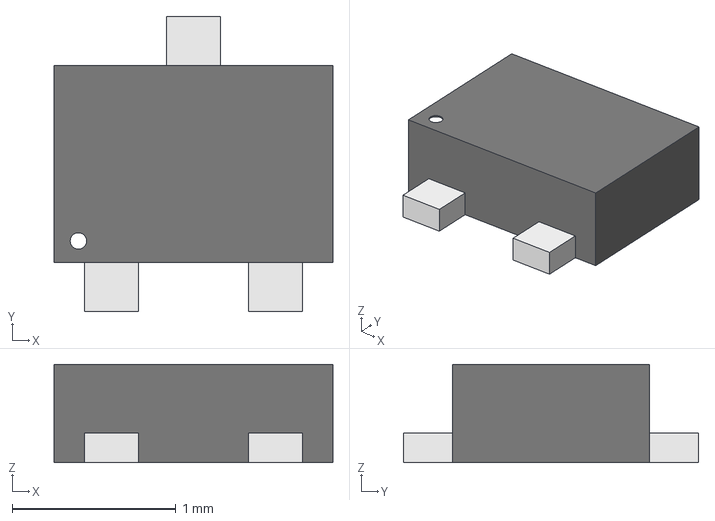
[picture p60: CAD file, 2025-03-11]
3dmodel/sot/SOTFL50P160X80-3.step
1.70 x 1.80 x 0.6 mm
