Esmartdriver/esmart-hw-lib-pub/3dmodel/to/TO-252-3.step

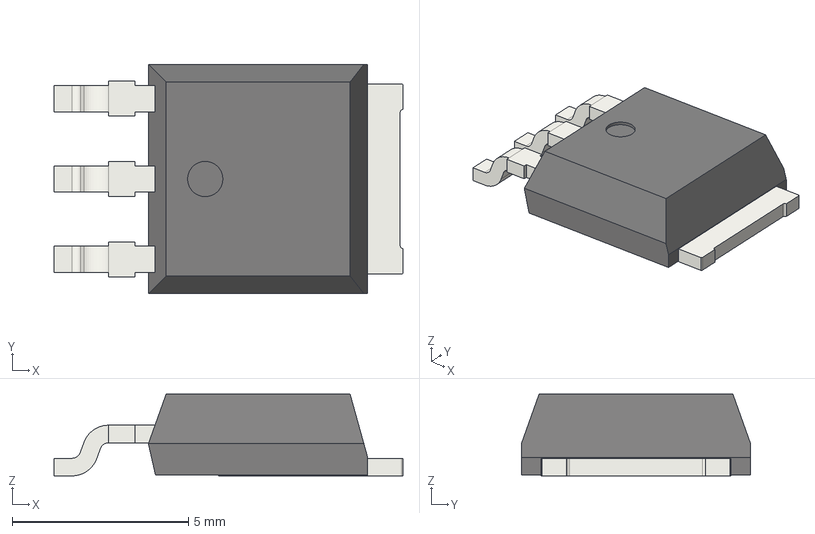
[picture p61: CAD file, 2025-03-11]
3dmodel/to/TO-252-3.step
9.90 x 6.50 x 2.32 mm
98f8d7e1-9c39-11ed-93f0-dde97e994e83_part
98f8d7e2-9c39-11ed-93f0-dde97e994e83_part
98f8d7e3-9c39-11ed-93f0-dde97e994e83_part
