Esmartdriver/esmart-hw-lib-pub/3dmodel/bga/BGA24N100P5X5_800X600X110.step

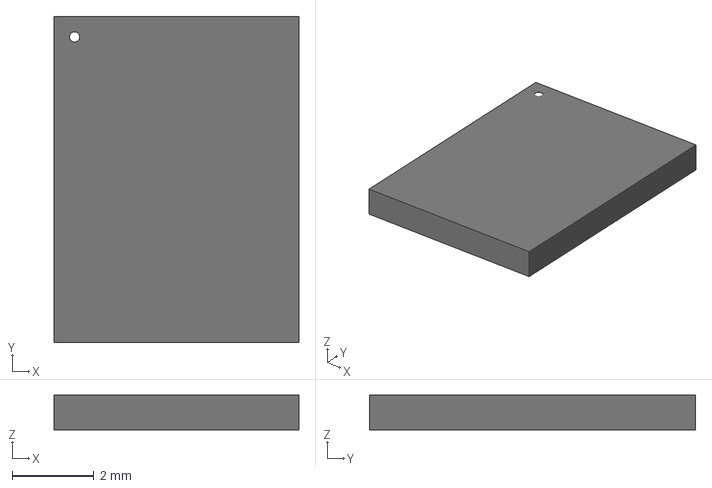
[picture p62: CAD file, 2025-03-11]
3dmodel/bga/BGA24N100P5X5_800X600X110.step
6.00 x 8.00 x 0.85 mm
