Esmartdriver/esmart-hw-lib-pub/3dmodel/clock/Crystal2016-4.step

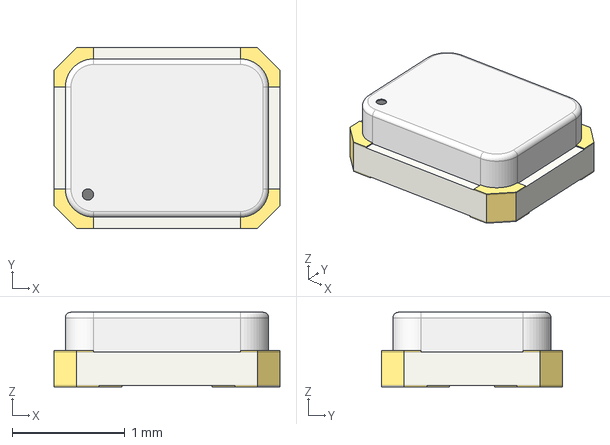
[picture p63: CAD file, 2025-03-11]
3dmodel/clock/Crystal2016-4.step
2.00 x 1.60 x 0.66 mm
