Esmartdriver/esmart-hw-lib-pub/3dmodel/connector/CalTest_CT3149-8.STEP

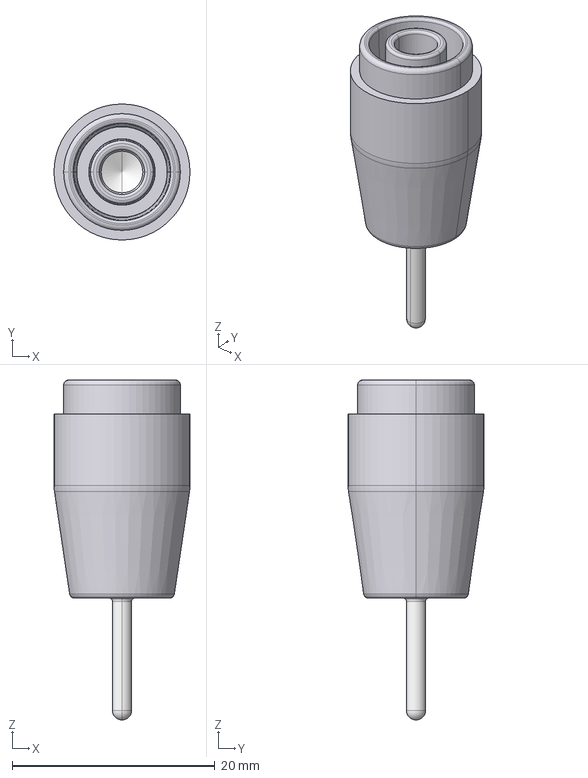
[picture p64: CAD file, 2025-03-11]
3dmodel/connector/CalTest_CT3149-8.STEP
13.4 x 13.4 x 33.5 mm
