Esmartdriver/esmart-hw-lib-pub/3dmodel/diode/Diode_SMB.step

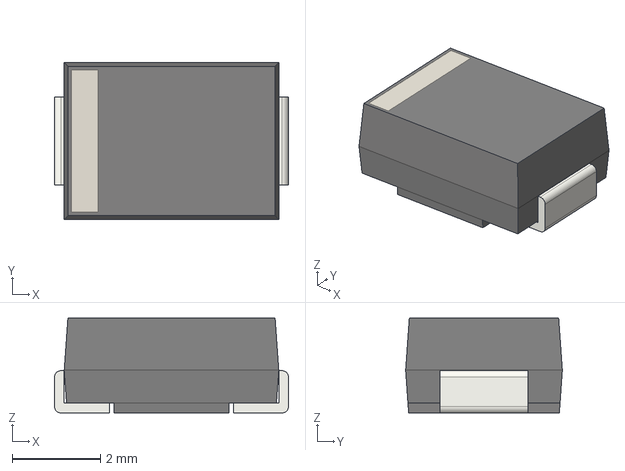
[picture p65: CAD file, 2025-03-11]
3dmodel/diode/Diode_SMB.step
5.30 x 3.55 x 2.15 mm
