Esmartdriver/esmart-hw-lib-pub/3dmodel/mechanical/BUMPER_RUB_M3_6mm_93115K871.stp

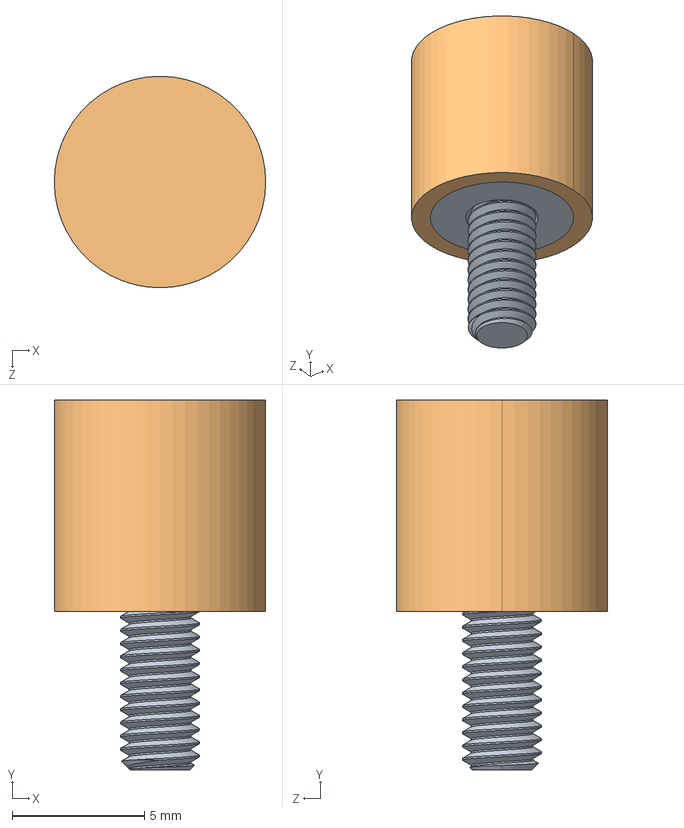
[picture p66: CAD file, 2025-03-11]
3dmodel/mechanical/BUMPER_RUB_M3_6mm_93115K871.stp
8.00 x 14.0 x 8.00 mm
