Esmartdriver/esmart-hw-lib-pub/3dmodel/other/VCC_SMB-200-XXX.STEP

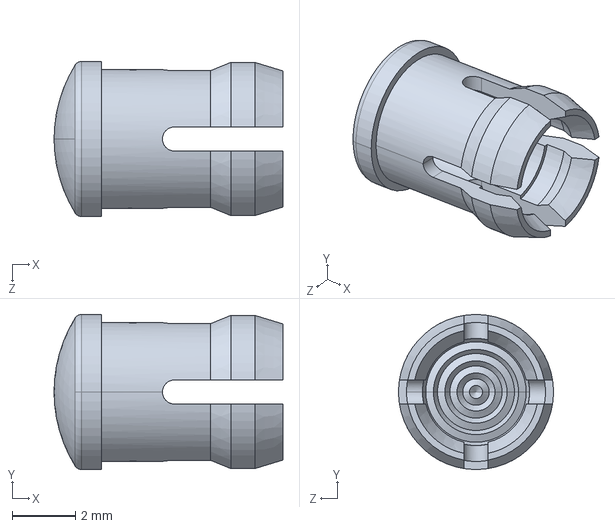
[picture p67: CAD file, 2025-03-11]
3dmodel/other/VCC_SMB-200-XXX.STEP
7.24 x 4.90 x 4.90 mm
