Esmartdriver/esmart-hw-lib-pub/3dmodel/passive/Bourns_PVG5A.stp

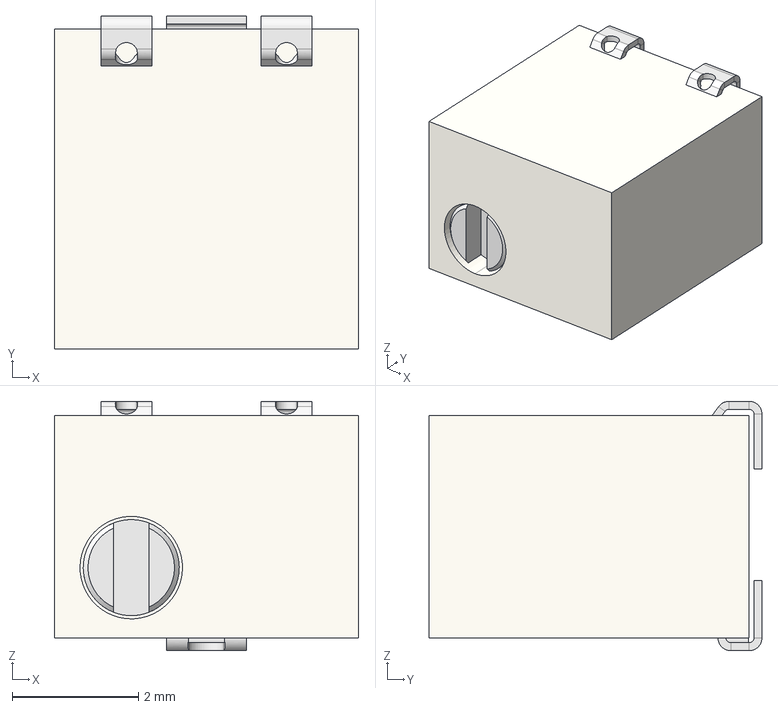
[picture p68: CAD file, 2025-03-11]
3dmodel/passive/Bourns_PVG5A.stp
4.83 x 5.28 x 3.96 mm
