Esmartdriver/esmart-hw-lib-pub/3dmodel/qfn/QFN40P300X300-25.step

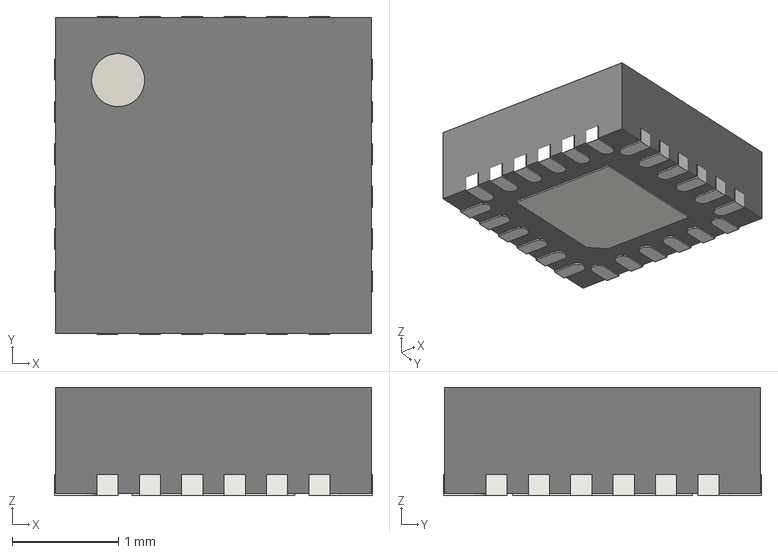
[picture p69: CAD file, 2025-03-11]
3dmodel/qfn/QFN40P300X300-25.step
3.00 x 3.00 x 1.02 mm
