Esmartdriver/esmart-hw-lib-pub/3dmodel/qfp/QFP50P1600X1600X120-101.step

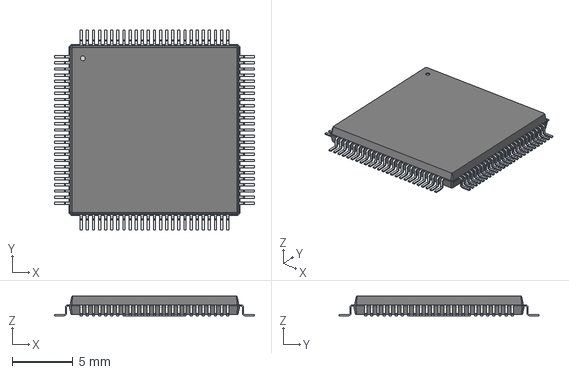
[picture p70: CAD file, 2025-03-11]
3dmodel/qfp/QFP50P1600X1600X120-101.step
16.4 x 16.4 x 1.60 mm
