Esmartdriver/esmart-hw-lib-pub/3dmodel/rf/antenova_SR4L002.step

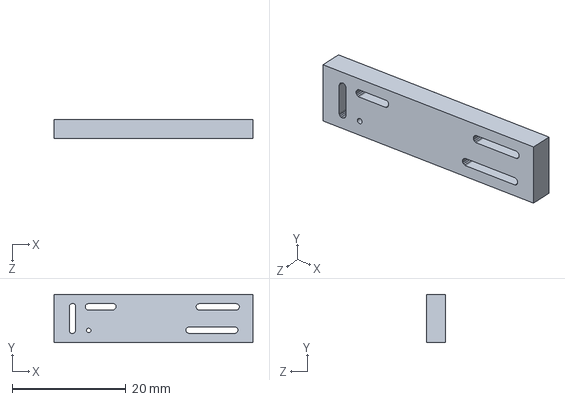
[picture p71: CAD file, 2025-03-11]
3dmodel/rf/antenova_SR4L002.step
35.0 x 8.50 x 3.29 mm
