Esmartdriver/esmart-hw-lib-pub/3dmodel/so/PowerPAK_SO-8.step

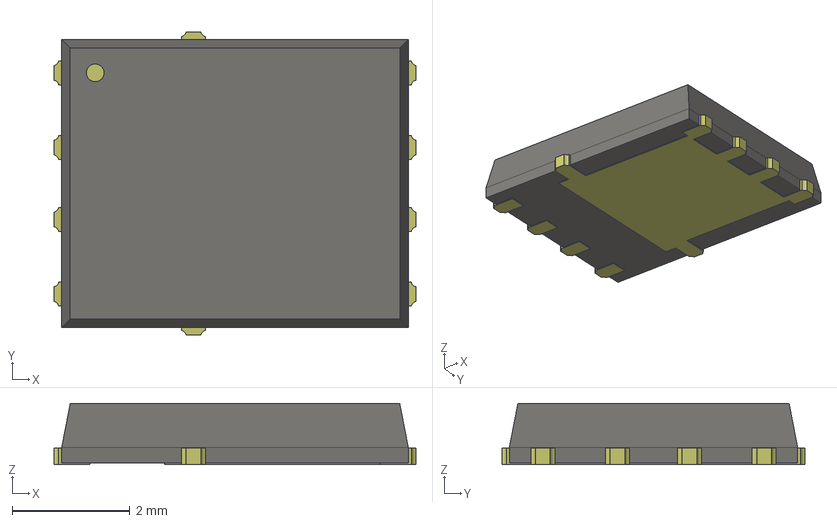
[picture p72: CAD file, 2025-03-11]
3dmodel/so/PowerPAK_SO-8.step
6.15 x 5.15 x 1.04 mm
