Esmartdriver/esmart-hw-lib-pub/3dmodel/sod/SOD-323.step

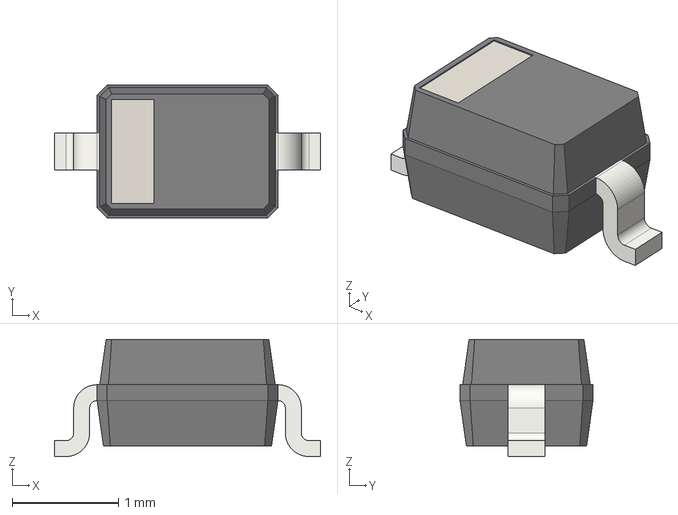
[picture p73: CAD file, 2025-03-11]
3dmodel/sod/SOD-323.step
2.50 x 1.25 x 1.10 mm
