Esmartdriver/esmart-hw-lib-pub/3dmodel/soic/SOIC127P865X390-14.step

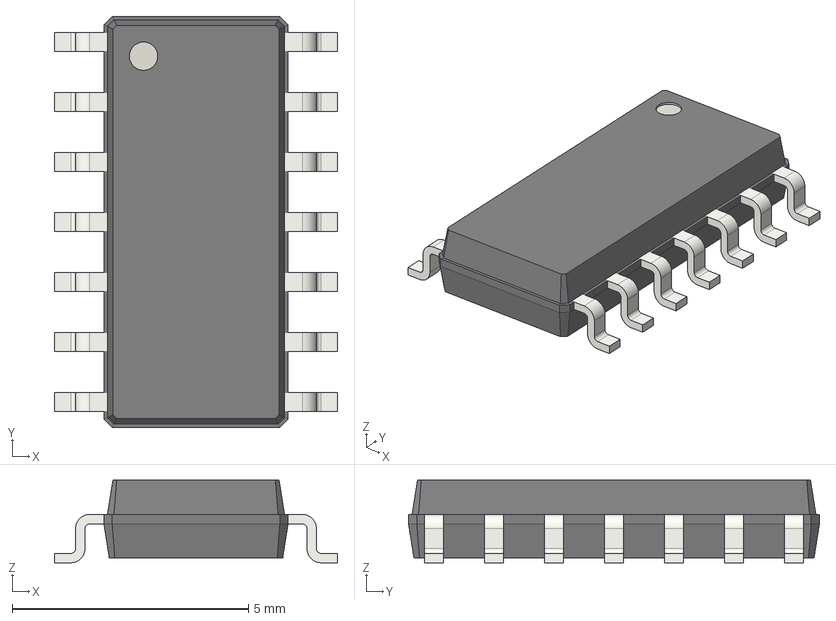
[picture p74: CAD file, 2025-03-11]
3dmodel/soic/SOIC127P865X390-14.step
6.00 x 8.70 x 1.75 mm
