Esmartdriver/esmart-hw-lib-pub/3dmodel/som/ublox_LILY-W132.step

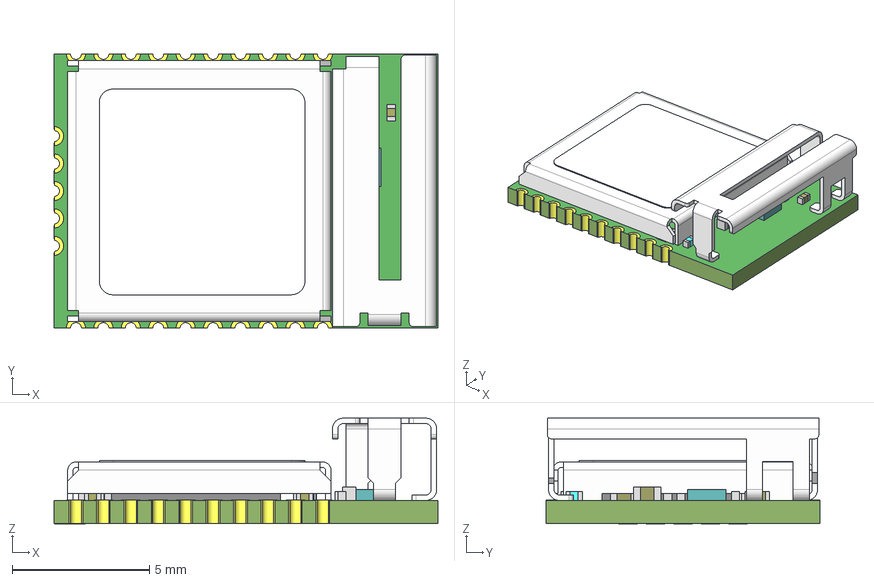
[picture p75: CAD file, 2025-03-11]
3dmodel/som/ublox_LILY-W132.step
14.0 x 10.0 x 3.85 mm
PCB
Castilation x 25
LILY Antenna Rev D
X2
pins
Z
LILY-Wxxx Label
