Esmartdriver/esmart-hw-lib-pub/3dmodel/son/SON35P100X60X50-3.step

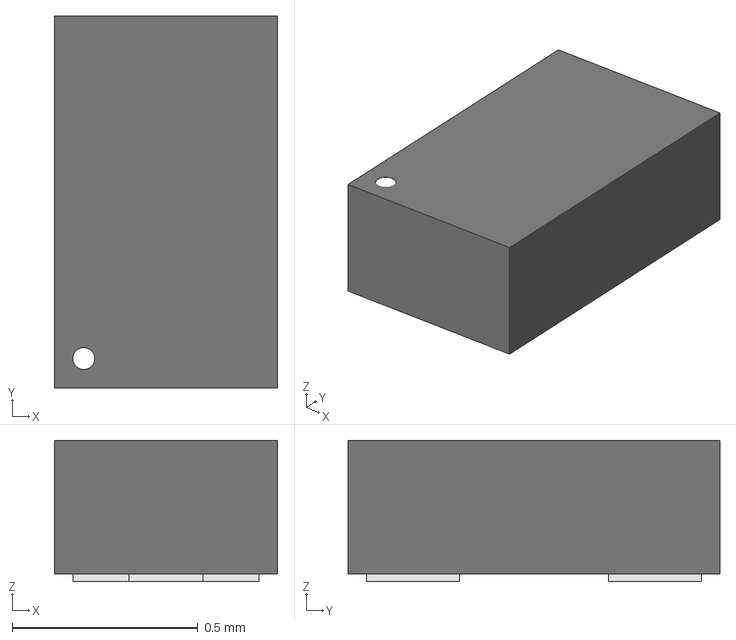
[picture p76: CAD file, 2025-03-11]
3dmodel/son/SON35P100X60X50-3.step
0.6 x 1.00 x 0.38 mm
