Esmartdriver/esmart-hw-lib-pub/3dmodel/sop/SOP65P640X780-24.step

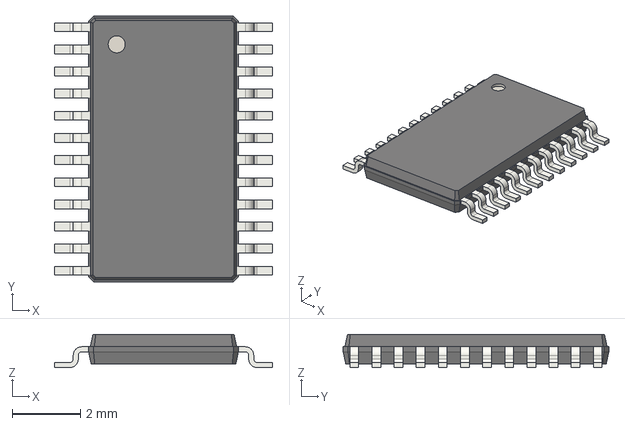
[picture p77: CAD file, 2025-03-11]
3dmodel/sop/SOP65P640X780-24.step
6.40 x 7.80 x 0.97 mm
