Esmartdriver/esmart-hw-lib-pub/3dmodel/sot/SOT127P700X180-6.stp

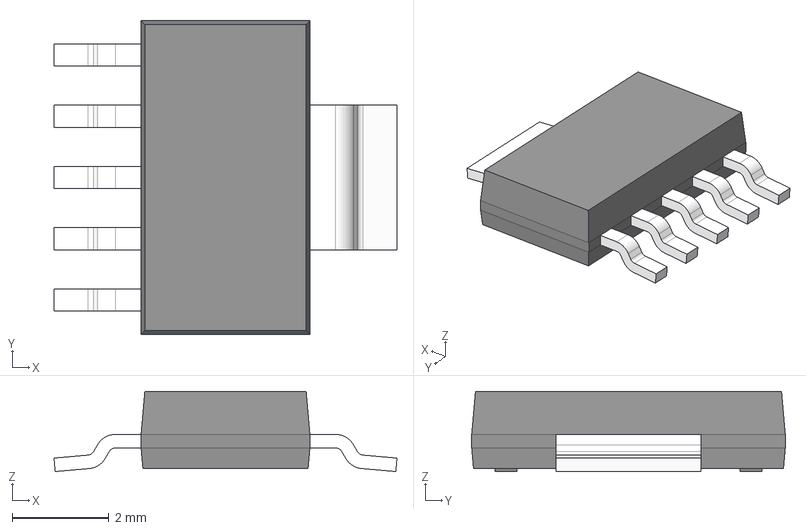
[picture p78: CAD file, 2025-03-11]
3dmodel/sot/SOT127P700X180-6.stp
7.11 x 6.50 x 1.66 mm
LEAD x 5
LEAD_WIDE
