Esmartdriver/esmart-hw-lib-pub/3dmodel/to/TO-92_wide.step

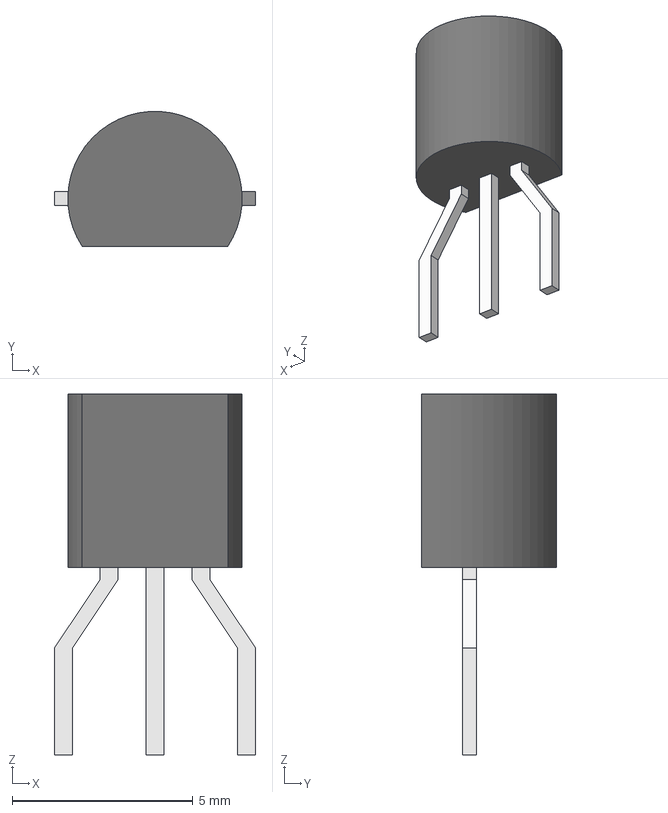
[picture p79: CAD file, 2025-03-11]
3dmodel/to/TO-92_wide.step
5.58 x 3.74 x 10.0 mm
