Esmartdriver/esmart-hw-lib-pub/3dmodel/bga/BGA12N28P3X3_168X168X60.step

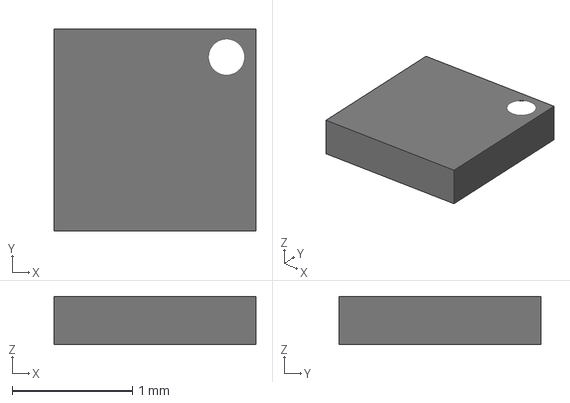
[picture p80: CAD file, 2025-03-11]
3dmodel/bga/BGA12N28P3X3_168X168X60.step
1.68 x 1.68 x 0.4 mm
