Esmartdriver/esmart-hw-lib-pub/3dmodel/clock/OM-7604-C7.STEP

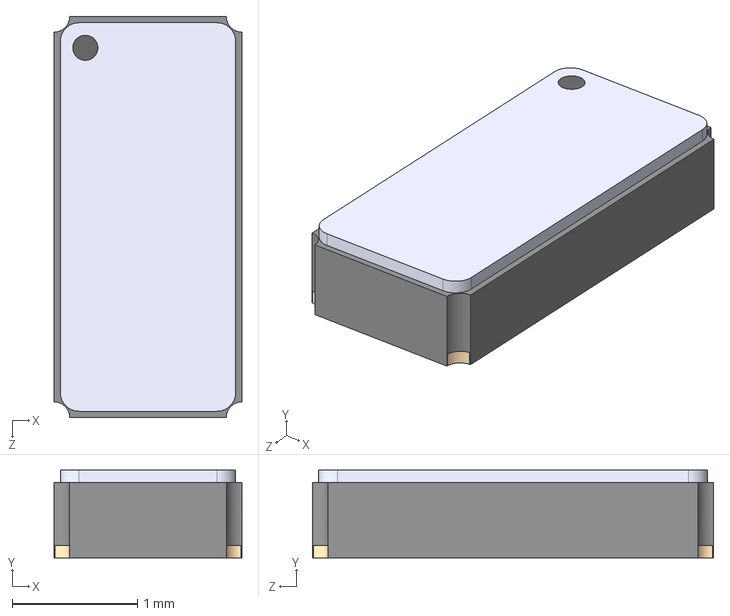
[picture p81: CAD file, 2025-03-11]
3dmodel/clock/OM-7604-C7.STEP
1.50 x 0.7 x 3.20 mm
