Esmartdriver/esmart-hw-lib-pub/3dmodel/connector/PinHeader_1x09_P2.54mm_Vertical.step

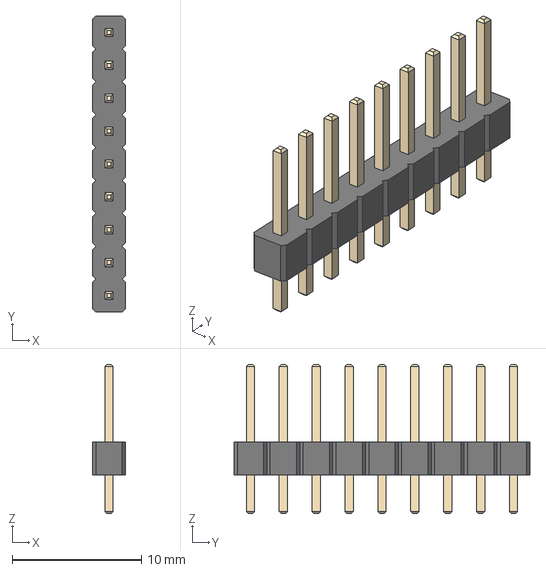
[picture p82: CAD file, 2025-03-11]
3dmodel/connector/PinHeader_1x09_P2.54mm_Vertical.step
2.54 x 22.9 x 11.5 mm
