Esmartdriver/esmart-hw-lib-pub/3dmodel/dfn/DFN127P600X500-9.step

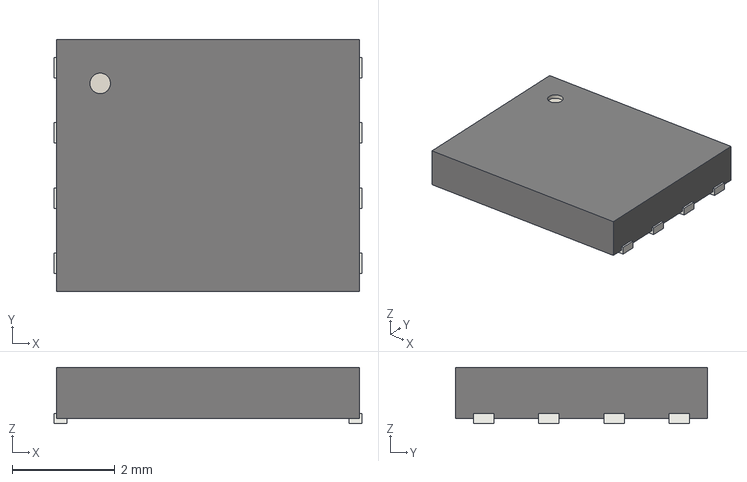
[picture p83: CAD file, 2025-03-11]
3dmodel/dfn/DFN127P600X500-9.step
6.00 x 4.90 x 1.10 mm
