Esmartdriver/esmart-hw-lib-pub/3dmodel/diode/TO-277B.step

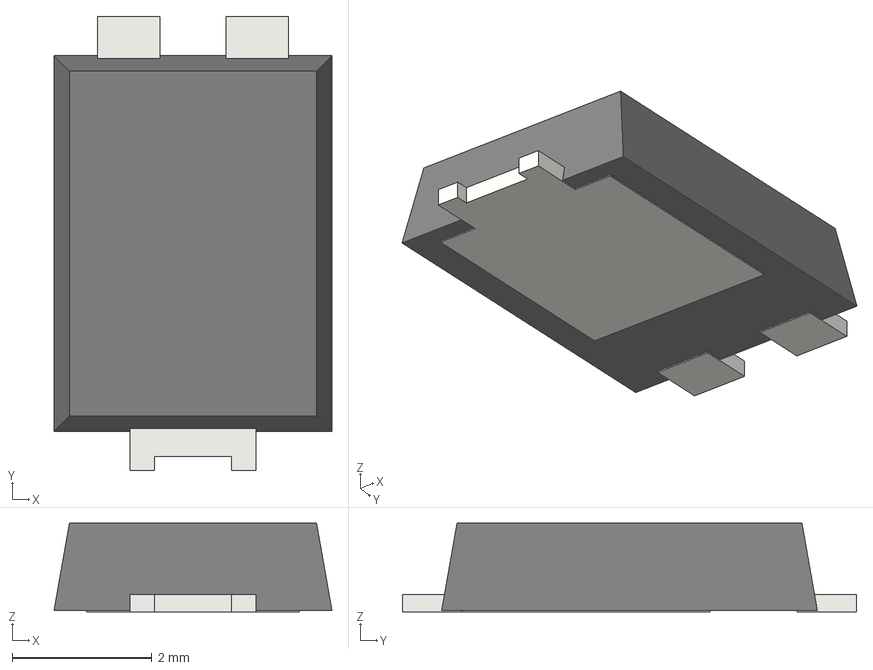
[picture p84: CAD file, 2025-03-11]
3dmodel/diode/TO-277B.step
3.98 x 6.50 x 1.27 mm
