Esmartdriver/esmart-hw-lib-pub/3dmodel/other/Fuse_CarBlade.STEP

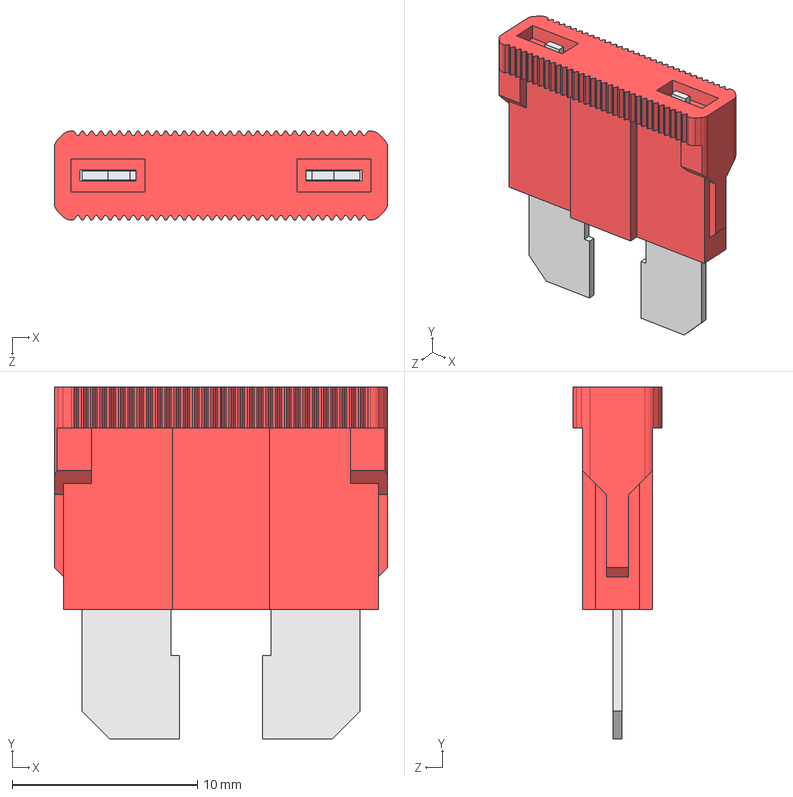
[picture p85: CAD file, 2025-03-11]
3dmodel/other/Fuse_CarBlade.STEP
18.0 x 19.0 x 4.80 mm
