Esmartdriver/esmart-hw-lib-pub/3dmodel/passive/CAPPR750-1600X2500.step

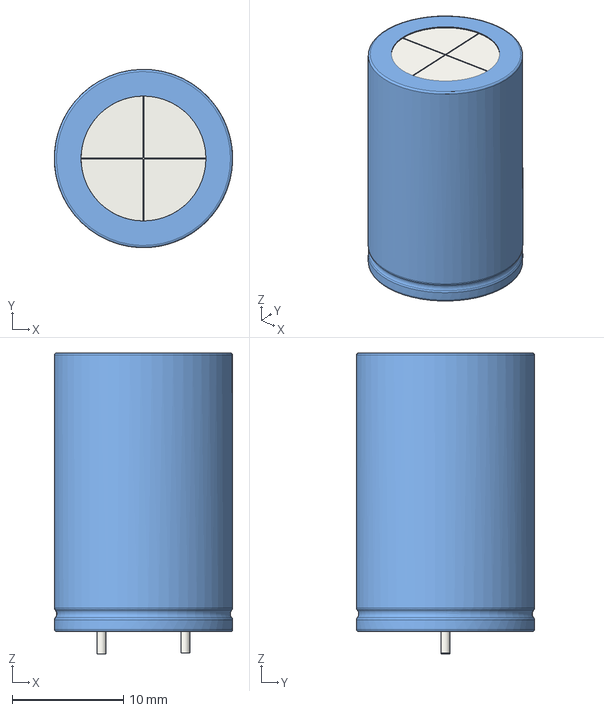
[picture p86: CAD file, 2025-03-11]
3dmodel/passive/CAPPR750-1600X2500.step
16.0 x 16.0 x 27.0 mm
