Esmartdriver/esmart-hw-lib-pub/3dmodel/qfn/QFN50P200X150-10.step

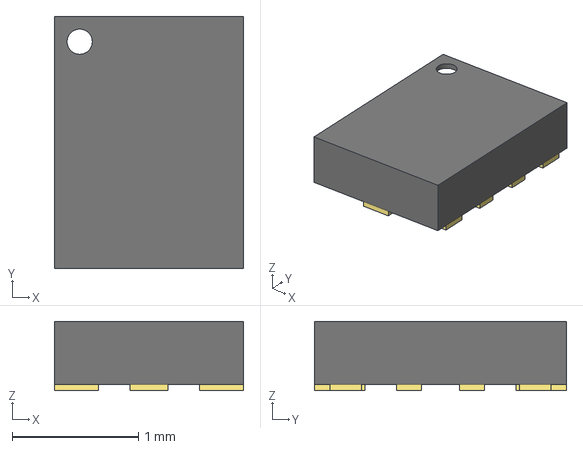
[picture p87: CAD file, 2025-03-11]
3dmodel/qfn/QFN50P200X150-10.step
1.50 x 2.00 x 0.55 mm
