Esmartdriver/esmart-hw-lib-pub/3dmodel/qfp/QFP50P1200X1200X120-65.step

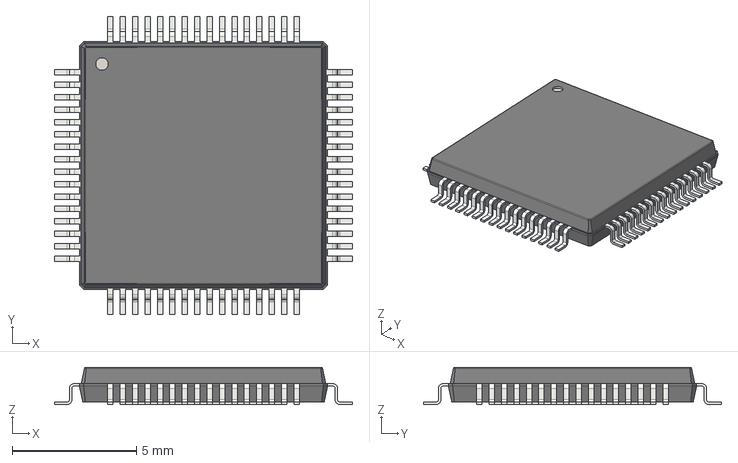
[picture p88: CAD file, 2025-03-11]
3dmodel/qfp/QFP50P1200X1200X120-65.step
12.0 x 12.0 x 1.50 mm
