Esmartdriver/esmart-hw-lib-pub/3dmodel/rf/antenova_A10340.step

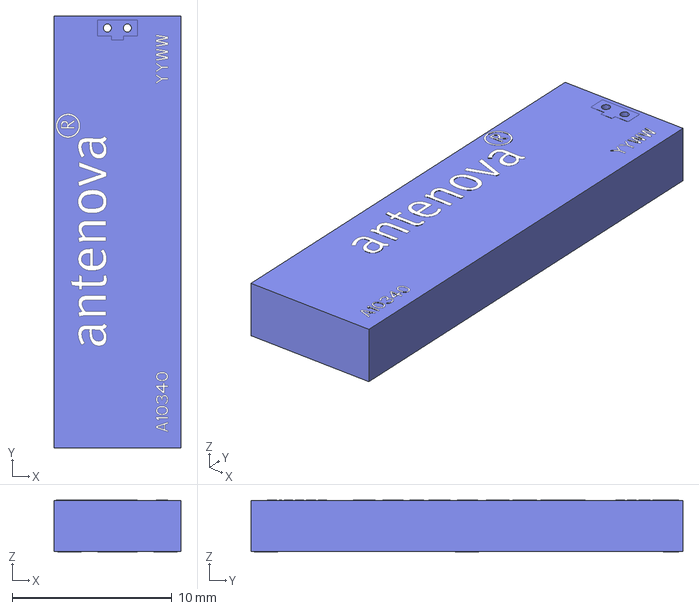
[picture p89: CAD file, 2025-03-11]
3dmodel/rf/antenova_A10340.step
7.92 x 27.0 x 3.22 mm
