Esmartdriver/esmart-hw-lib-pub/3dmodel/sod/SOD-923.step

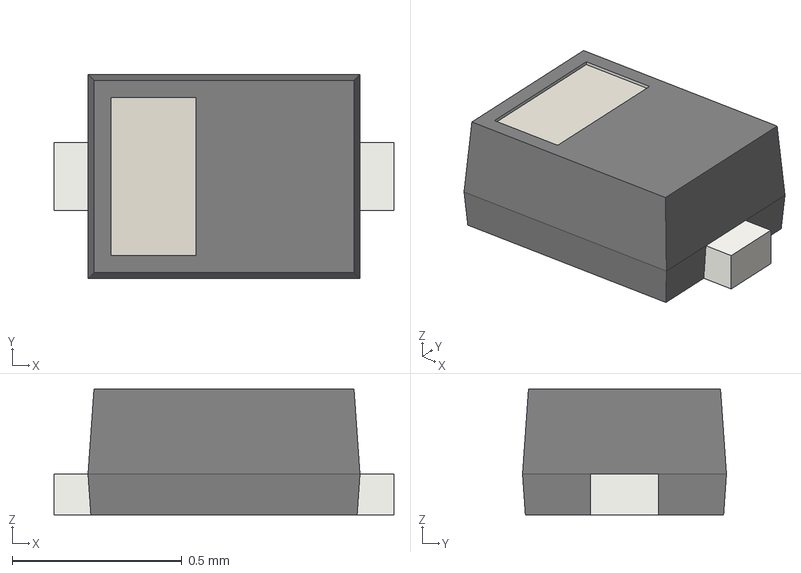
[picture p90: CAD file, 2025-03-11]
3dmodel/sod/SOD-923.step
1.00 x 0.6 x 0.37 mm
