Esmartdriver/esmart-hw-lib-pub/3dmodel/soic/SOIC127P1030X265-16.step

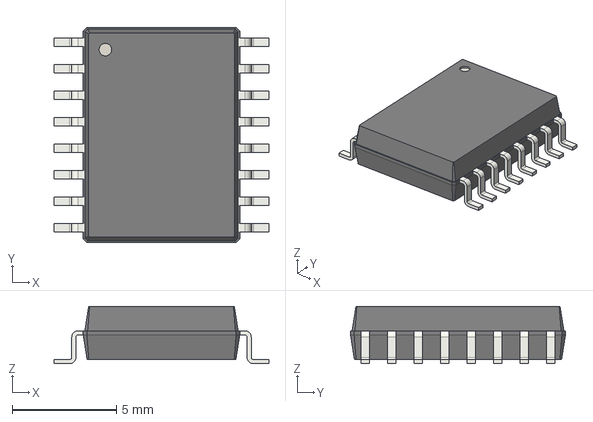
[picture p91: CAD file, 2025-03-11]
3dmodel/soic/SOIC127P1030X265-16.step
10.3 x 10.3 x 2.75 mm
