Esmartdriver/esmart-hw-lib-pub/3dmodel/som/ublox_MAX.step

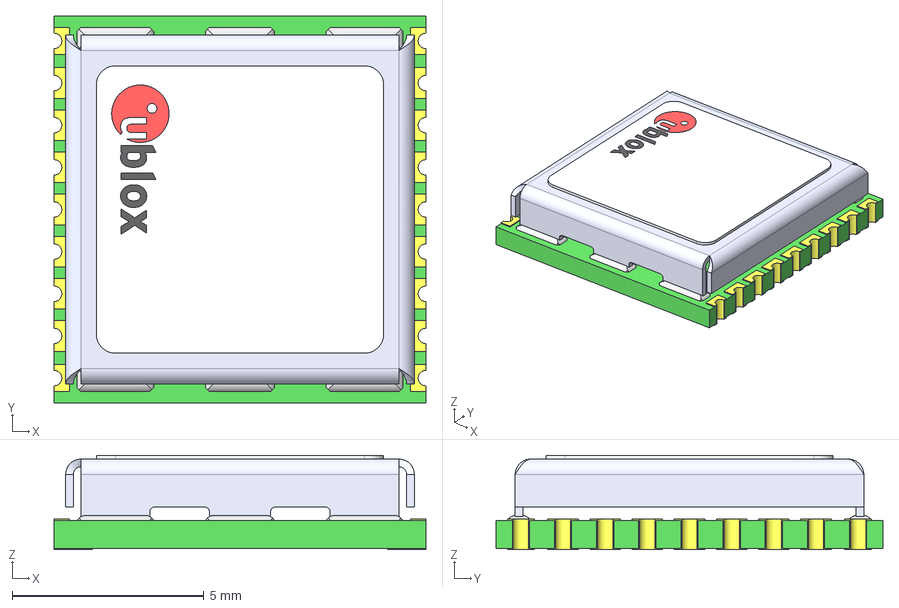
[picture p92: CAD file, 2025-03-11]
3dmodel/som/ublox_MAX.step
9.70 x 10.1 x 2.47 mm
