Esmartdriver/esmart-hw-lib-pub/3dmodel/son/SON35P60X60X40-3.step

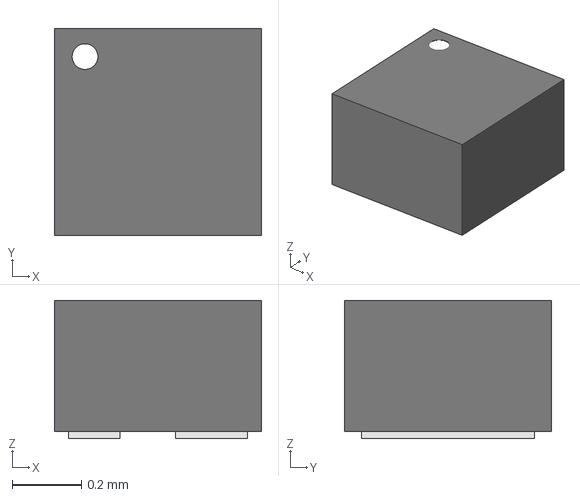
[picture p93: CAD file, 2025-03-11]
3dmodel/son/SON35P60X60X40-3.step
0.6 x 0.6 x 0.4 mm
