Esmartdriver/esmart-hw-lib-pub/3dmodel/sop/SOP65P640X970-29.step

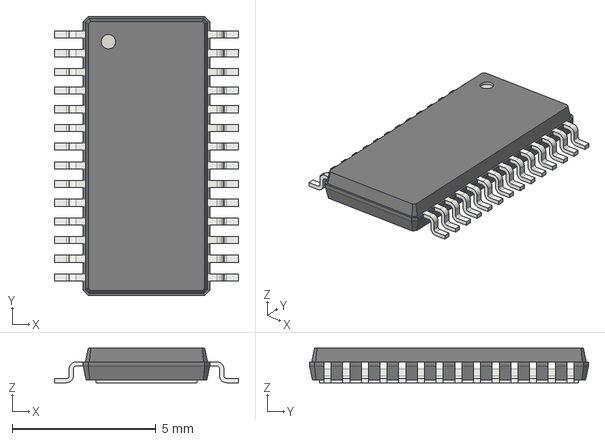
[picture p94: CAD file, 2025-03-11]
3dmodel/sop/SOP65P640X970-29.step
6.40 x 9.70 x 1.20 mm
