Esmartdriver/esmart-hw-lib-pub/3dmodel/sot/SOT50P160X80-4.step

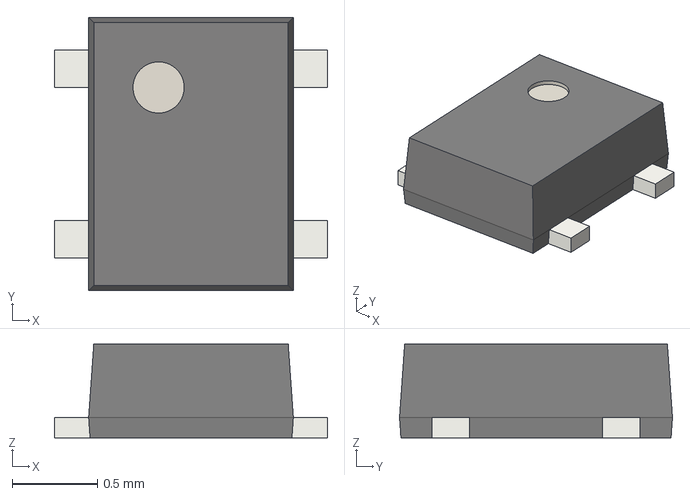
[picture p95: CAD file, 2025-03-11]
3dmodel/sot/SOT50P160X80-4.step
1.60 x 1.60 x 0.55 mm
