Esmartdriver/esmart-hw-lib-pub/3dmodel/to/TO-251-3.step

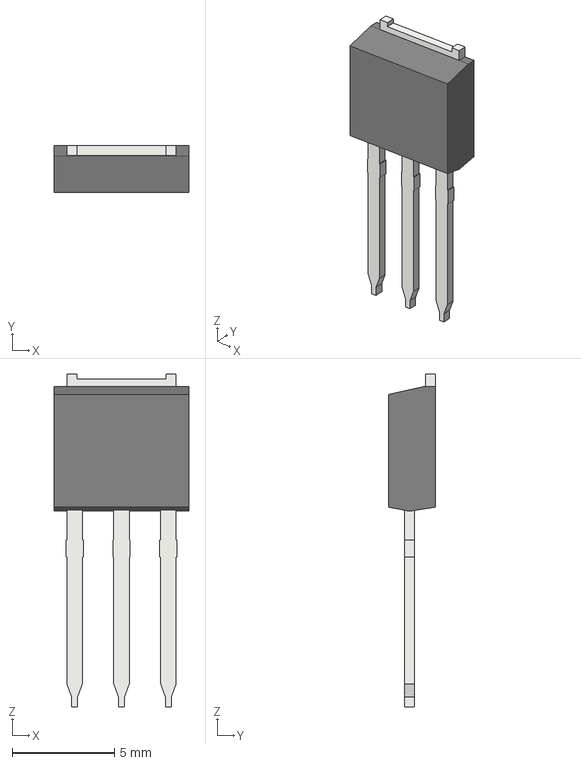
[picture p96: CAD file, 2025-03-11]
3dmodel/to/TO-251-3.step
6.57 x 2.31 x 16.3 mm
