Esmartdriver/esmart-hw-lib-pub/3dmodel/bga/BGA4N40P2X2_78X78X50.step

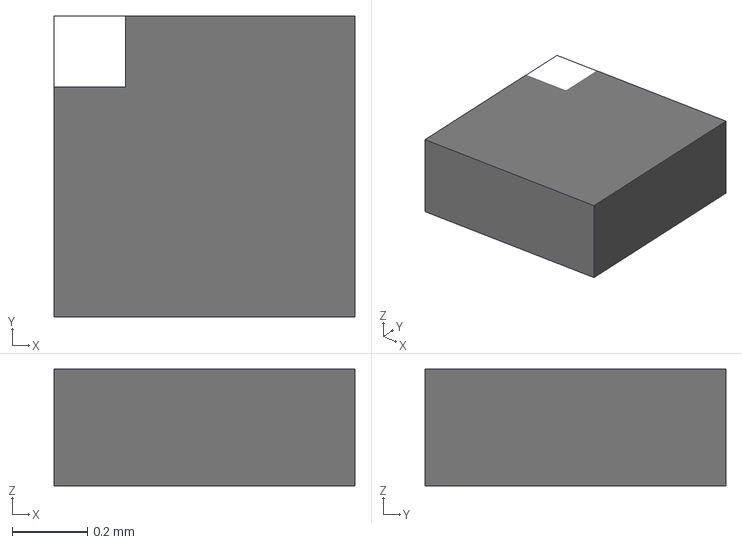
[picture p97: CAD file, 2025-03-11]
3dmodel/bga/BGA4N40P2X2_78X78X50.step
0.8 x 0.8 x 0.31 mm
