Esmartdriver/esmart-hw-lib-pub/3dmodel/clock/Crystal2012-2.step

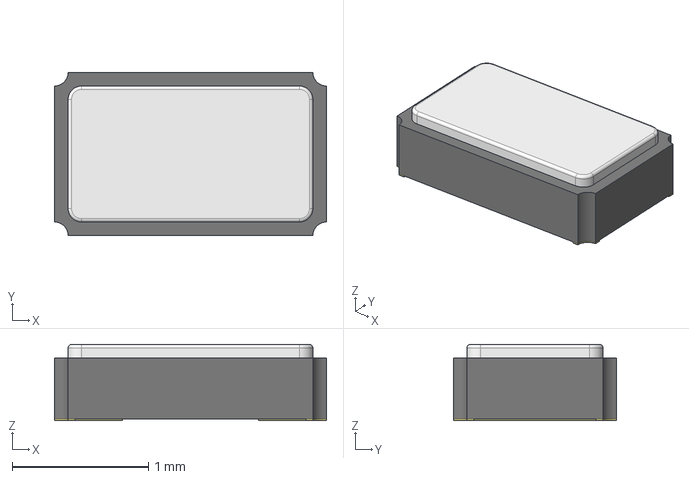
[picture p98: CAD file, 2025-03-11]
3dmodel/clock/Crystal2012-2.step
2.00 x 1.20 x 0.56 mm
