Esmartdriver/esmart-hw-lib-pub/3dmodel/dfn/DFN50P300X200X75-9.step

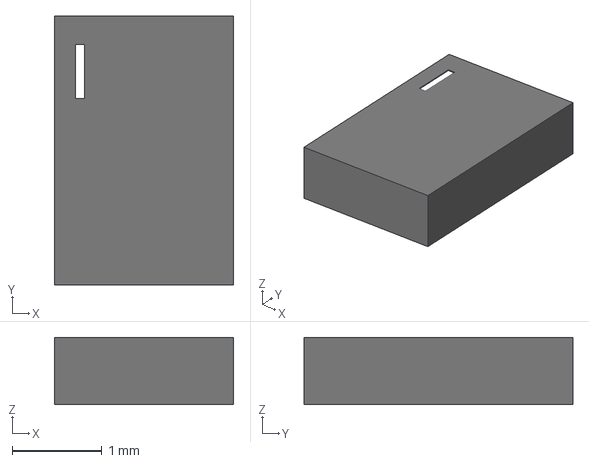
[picture p99: CAD file, 2025-03-11]
3dmodel/dfn/DFN50P300X200X75-9.step
2.00 x 3.00 x 0.75 mm
