Esmartdriver/esmart-hw-lib-pub/3dmodel/other/Broadcom_APDS-9960.step

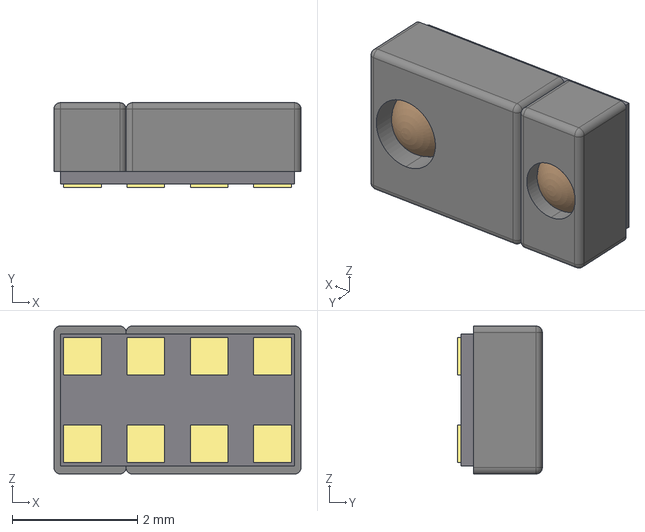
[picture p100: CAD file, 2025-03-11]
3dmodel/other/Broadcom_APDS-9960.step
3.94 x 1.35 x 2.36 mm
