Esmartdriver/esmart-hw-lib-pub/3dmodel/passive/INDC1005.step

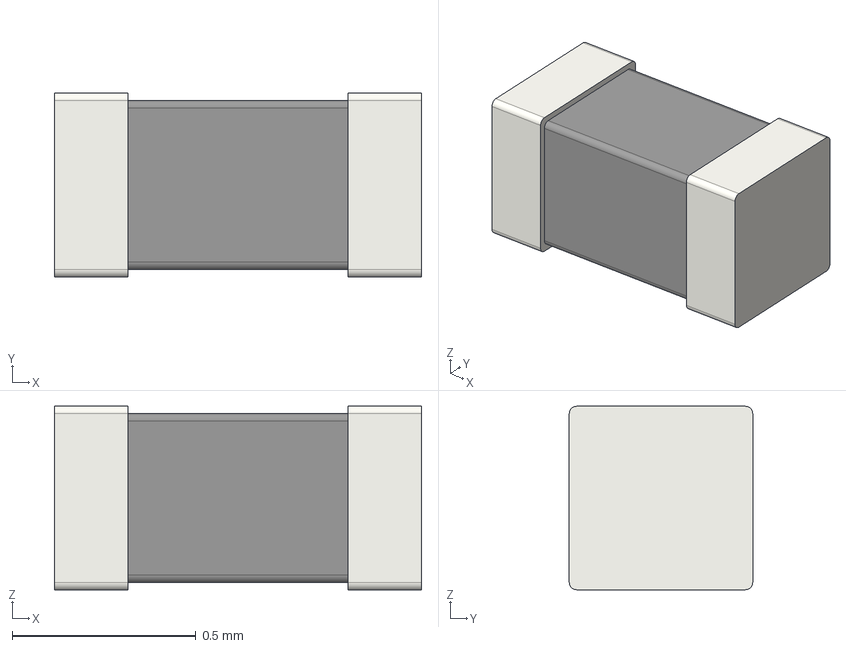
[picture p101: CAD file, 2025-03-11]
3dmodel/passive/INDC1005.step
1.00 x 0.5 x 0.5 mm
