Esmartdriver/esmart-hw-lib-pub/3dmodel/qfn/QFN50P200X150-9.step

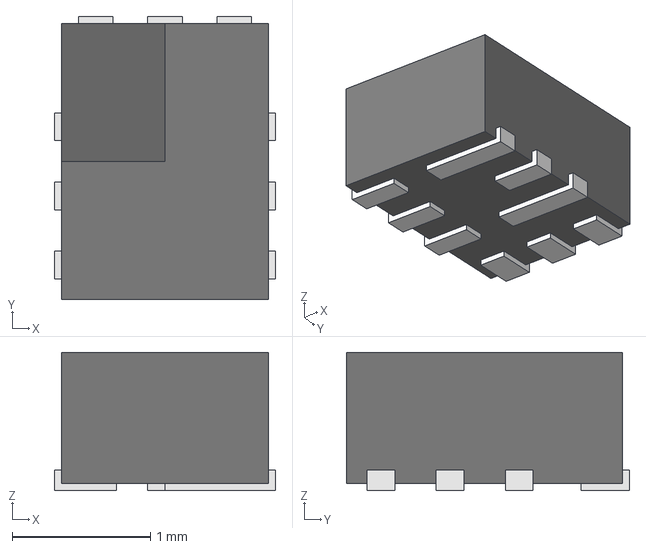
[picture p102: CAD file, 2025-03-11]
3dmodel/qfn/QFN50P200X150-9.step
1.60 x 2.05 x 1.00 mm
