Esmartdriver/esmart-hw-lib-pub/3dmodel/rf/antenova_SR42W001.step

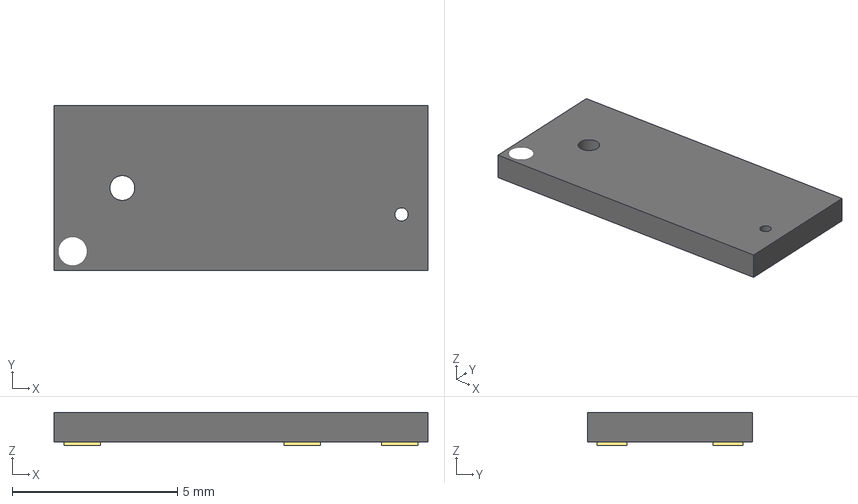
[picture p103: CAD file, 2025-03-11]
3dmodel/rf/antenova_SR42W001.step
11.3 x 5.00 x 1.00 mm
