Esmartdriver/esmart-hw-lib-pub/3dmodel/so/PowerPAK-1212-8-Single.step

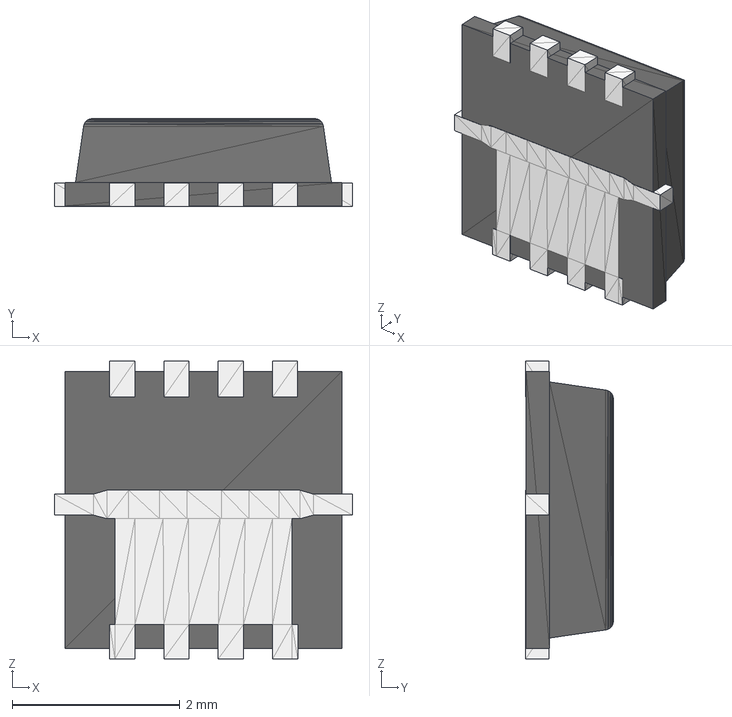
[picture p104: CAD file, 2025-03-11]
3dmodel/so/PowerPAK-1212-8-Single.step
3.55 x 1.05 x 3.55 mm
