Esmartdriver/esmart-hw-lib-pub/3dmodel/sod/SOD-523.step

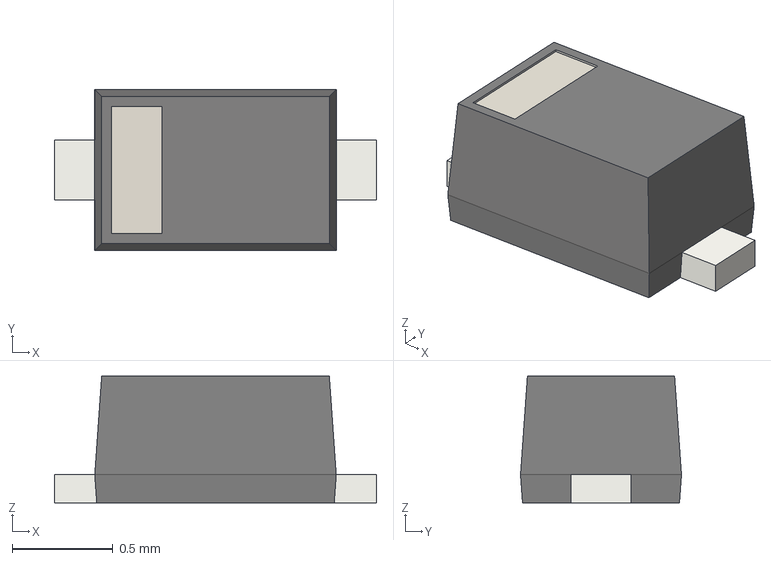
[picture p105: CAD file, 2025-03-11]
3dmodel/sod/SOD-523.step
1.60 x 0.8 x 0.63 mm
