Esmartdriver/esmart-hw-lib-pub/3dmodel/soic/SOIC127P600X175-16.step

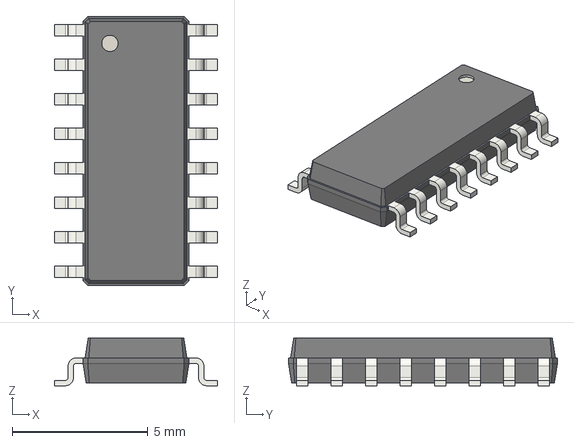
[picture p106: CAD file, 2025-03-11]
3dmodel/soic/SOIC127P600X175-16.step
6.00 x 9.90 x 1.75 mm
