Esmartdriver/esmart-hw-lib-pub/3dmodel/som/ublox_SAM.step

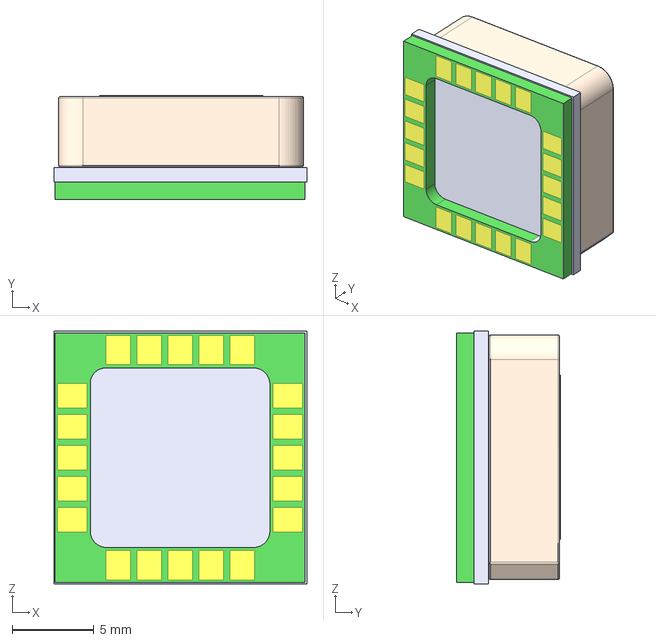
[picture p107: CAD file, 2025-03-11]
3dmodel/som/ublox_SAM.step
15.5 x 6.38 x 15.5 mm
