Esmartdriver/esmart-hw-lib-pub/3dmodel/sop/SOP50P310X200-8.step

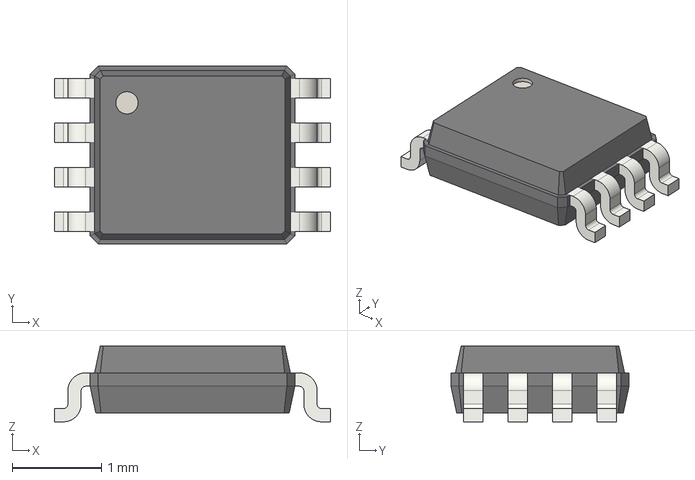
[picture p108: CAD file, 2025-03-11]
3dmodel/sop/SOP50P310X200-8.step
3.10 x 2.00 x 0.85 mm
