Esmartdriver/esmart-hw-lib-pub/3dmodel/sot/SOT50P160X80-3.step

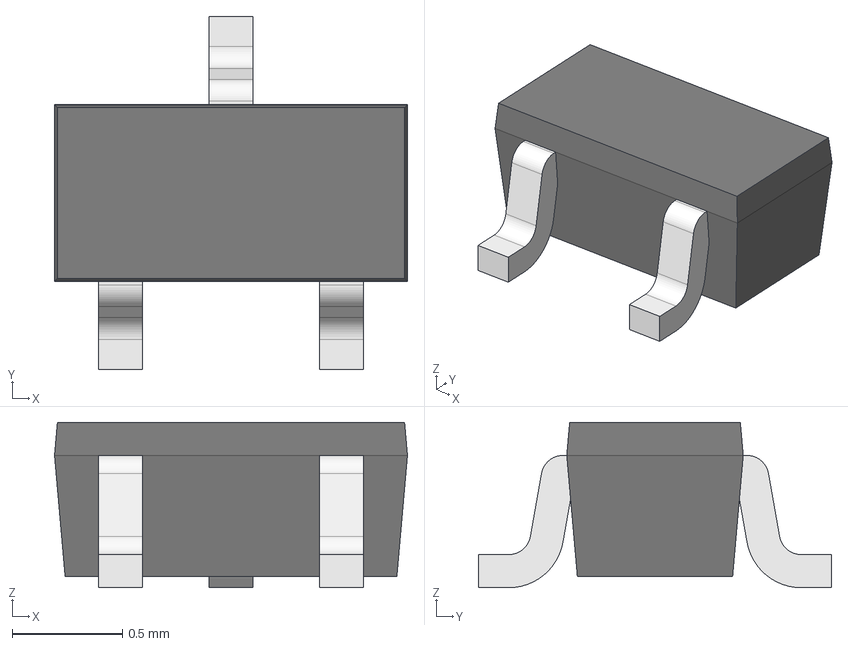
[picture p109: CAD file, 2025-03-11]
3dmodel/sot/SOT50P160X80-3.step
1.60 x 1.60 x 0.75 mm
SSM v2
SSM v003
SSM v004
SSM v005
