Esmartdriver/esmart-hw-lib-pub/3dmodel/to/TO-92.step

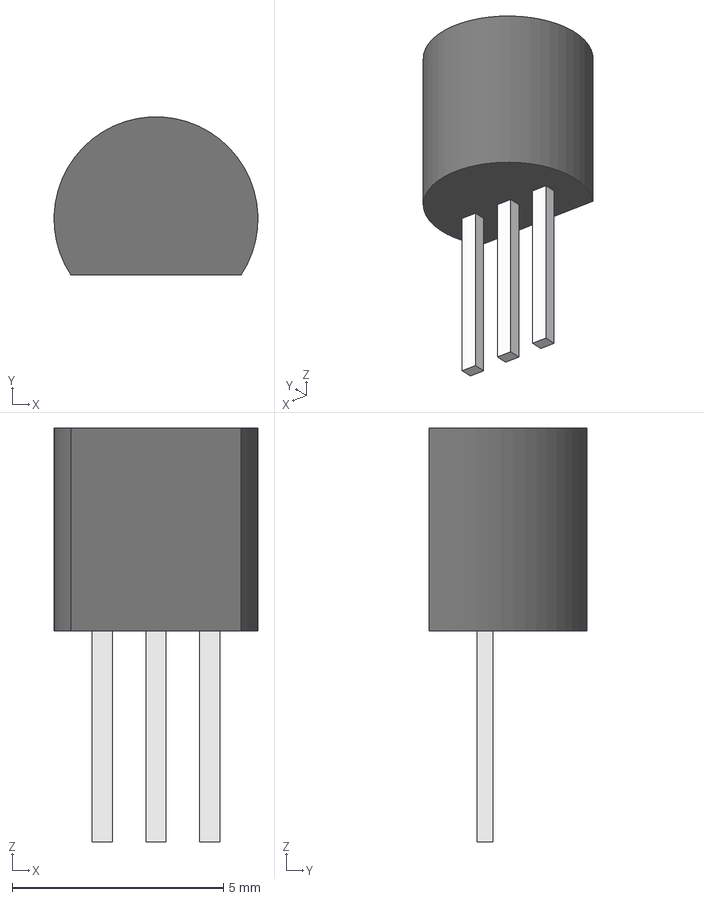
[picture p110: CAD file, 2025-03-11]
3dmodel/to/TO-92.step
4.83 x 3.74 x 9.80 mm
