Esmartdriver/esmart-hw-lib-pub/3dmodel/bga/BGA153N50P15X15_800X800.step

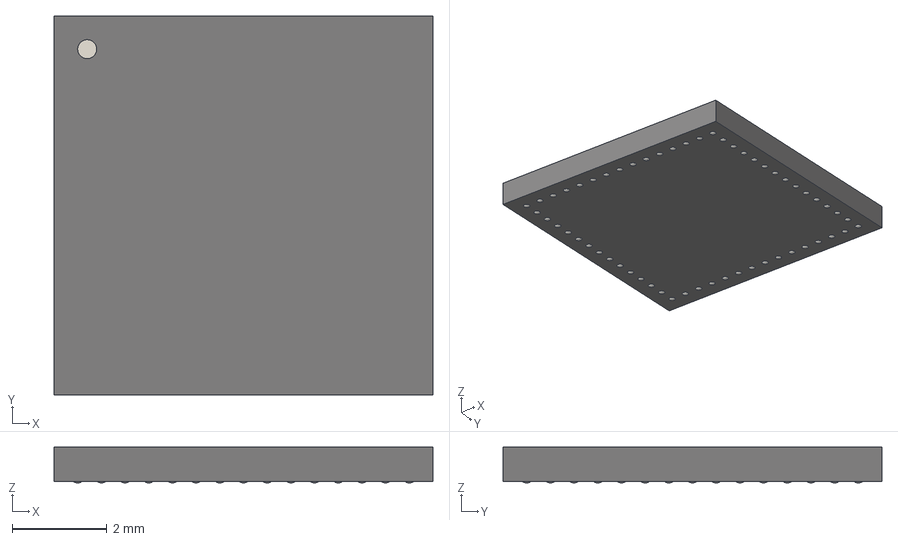
[picture p111: CAD file, 2025-03-11]
3dmodel/bga/BGA153N50P15X15_800X800.step
8.00 x 8.00 x 0.757 mm
