Esmartdriver/esmart-hw-lib-pub/3dmodel/connector/PinHeader_1x10_P1.27mm_Vertical.step

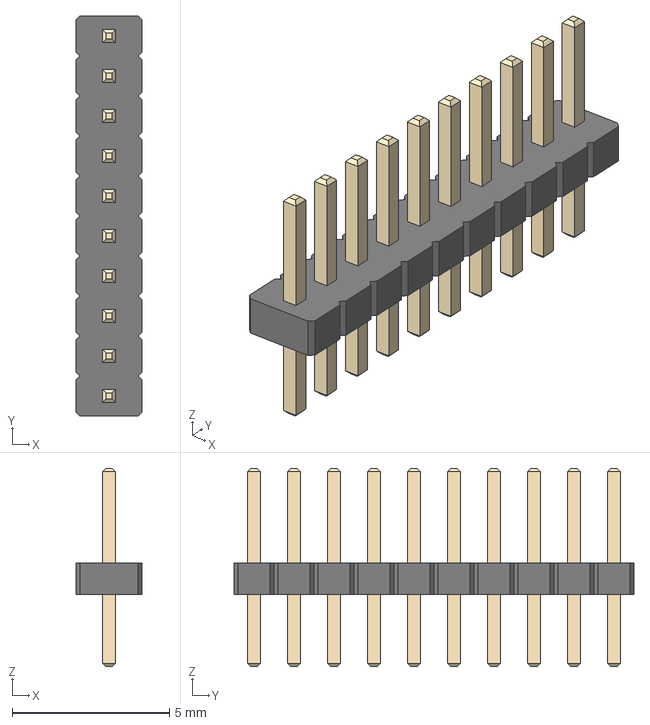
[picture p112: CAD file, 2025-03-11]
3dmodel/connector/PinHeader_1x10_P1.27mm_Vertical.step
2.10 x 12.7 x 6.30 mm
