Esmartdriver/esmart-hw-lib-pub/3dmodel/dfn/DFN600X500X80-9.step

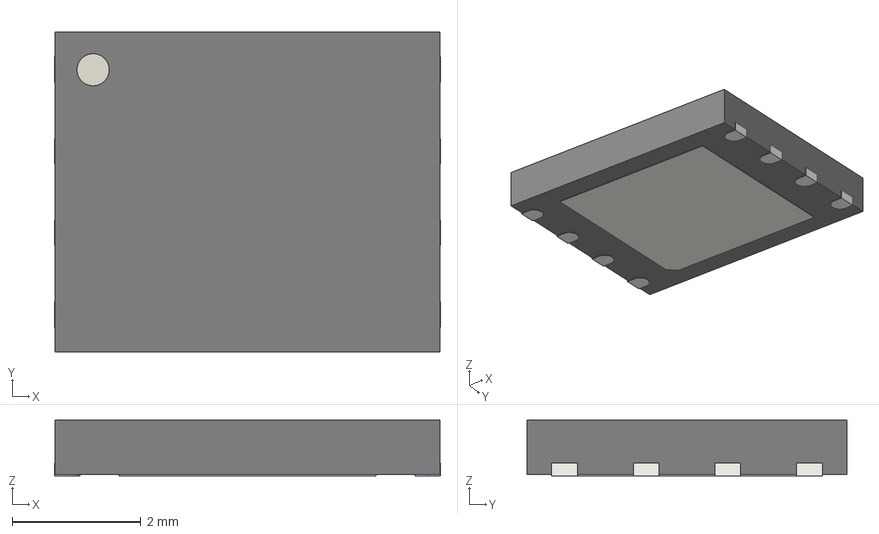
[picture p113: CAD file, 2025-03-11]
3dmodel/dfn/DFN600X500X80-9.step
6.00 x 4.98 x 0.87 mm
