Esmartdriver/esmart-hw-lib-pub/3dmodel/led/LED_5mm_ra3mm.step

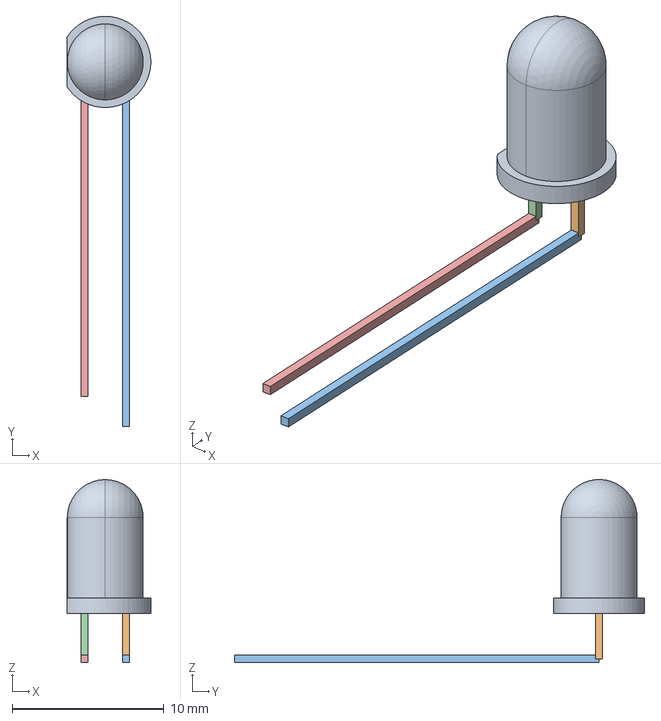
[picture p114: CAD file, 2025-03-11]
3dmodel/led/LED_5mm_ra3mm.step
5.49 x 27.0 x 12.0 mm
