Esmartdriver/esmart-hw-lib-pub/3dmodel/mechanical/CABLE_HDMI_micro.step

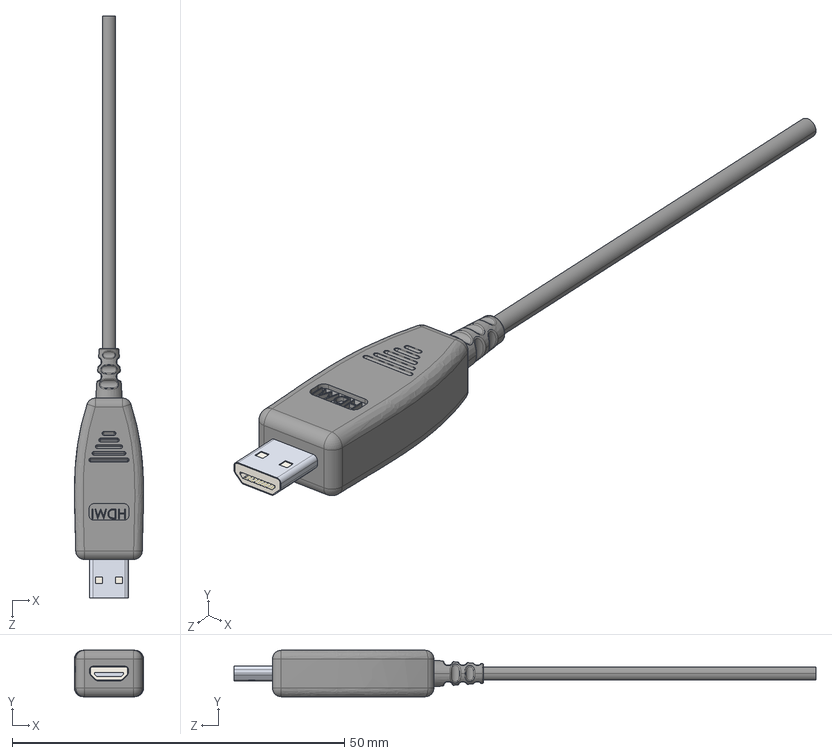
[picture p115: CAD file, 2025-03-11]
3dmodel/mechanical/CABLE_HDMI_micro.step
10.4 x 7.00 x 87.6 mm
HDMI_D_D‚faut
HDMI_Plastic_Part
Cable_DＧaut
