Esmartdriver/esmart-hw-lib-pub/3dmodel/other/ER-TFT1.14-1.step

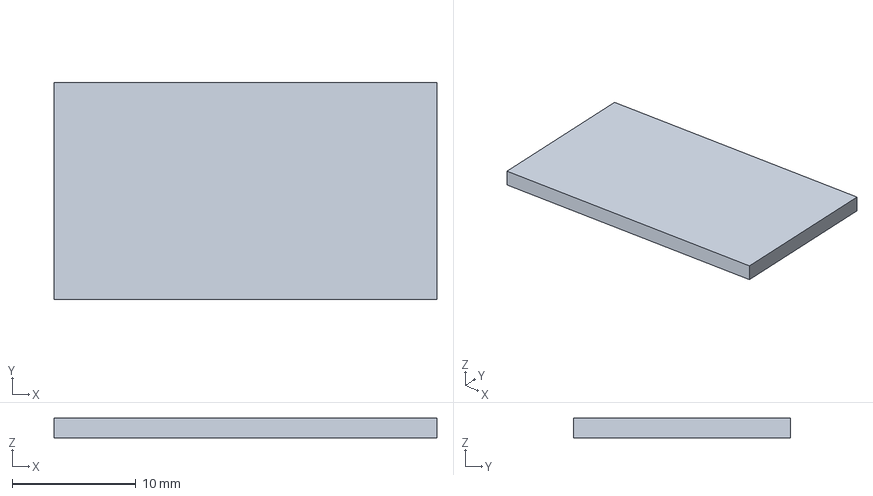
[picture p116: CAD file, 2025-03-11]
3dmodel/other/ER-TFT1.14-1.step
31.0 x 17.6 x 1.60 mm
