Esmartdriver/esmart-hw-lib-pub/3dmodel/passive/CAPAE630X580.step

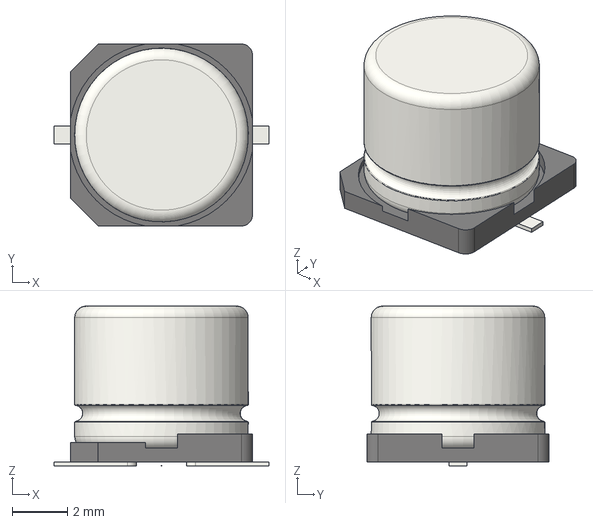
[picture p117: CAD file, 2025-03-11]
3dmodel/passive/CAPAE630X580.step
7.80 x 6.60 x 5.80 mm
