Esmartdriver/esmart-hw-lib-pub/3dmodel/qfn/QFN40P1200X1200-101.step

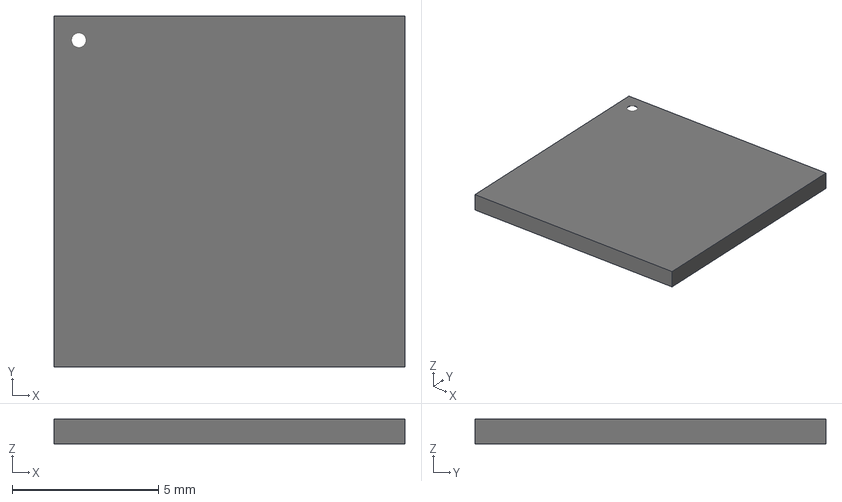
[picture p118: CAD file, 2025-03-11]
3dmodel/qfn/QFN40P1200X1200-101.step
12.0 x 12.0 x 0.85 mm
