Esmartdriver/esmart-hw-lib-pub/3dmodel/sod/SOD-123FL.step

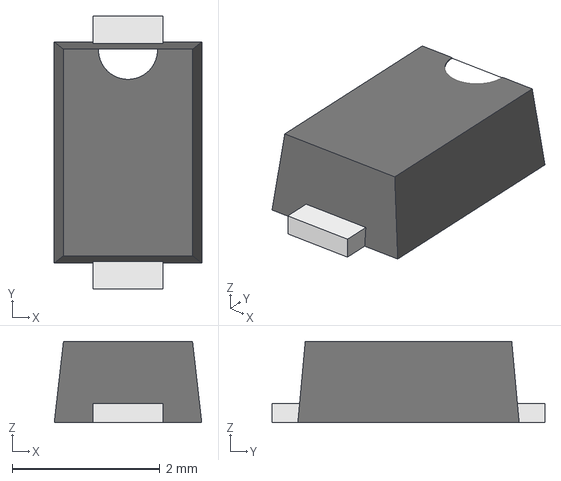
[picture p119: CAD file, 2025-03-11]
3dmodel/sod/SOD-123FL.step
2.00 x 3.70 x 1.10 mm
