Esmartdriver/esmart-hw-lib-pub/3dmodel/soic/SOIC127P1030X250-20.step

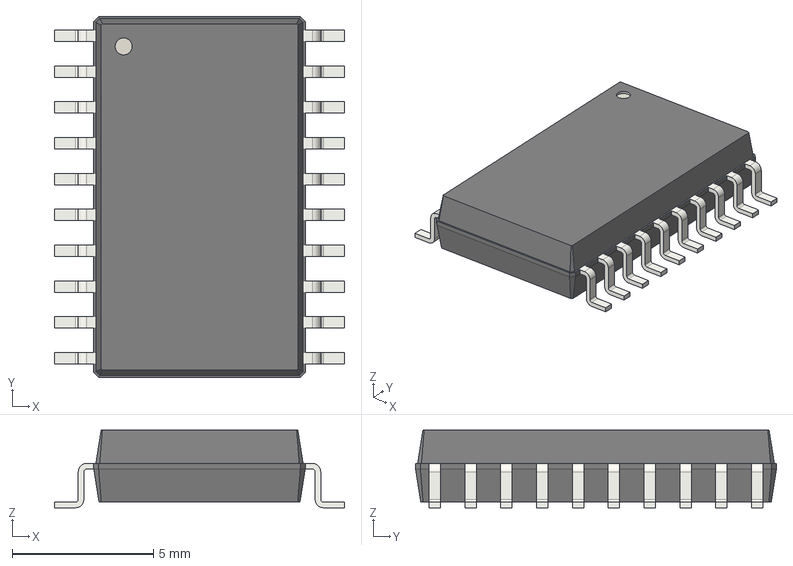
[picture p120: CAD file, 2025-03-11]
3dmodel/soic/SOIC127P1030X250-20.step
10.3 x 12.8 x 2.75 mm
