Esmartdriver/esmart-hw-lib-pub/3dmodel/som/esp-wroom-32.step

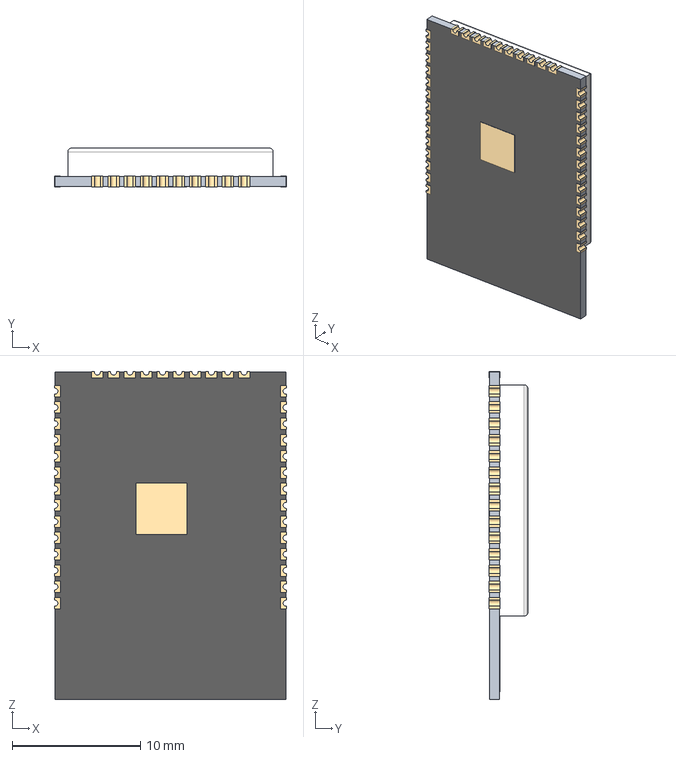
[picture p121: CAD file, 2025-03-11]
3dmodel/som/esp-wroom-32.step
18.1 x 3.04 x 25.5 mm
