Esmartdriver/esmart-hw-lib-pub/3dmodel/sop/SOP50P640X970-38.step

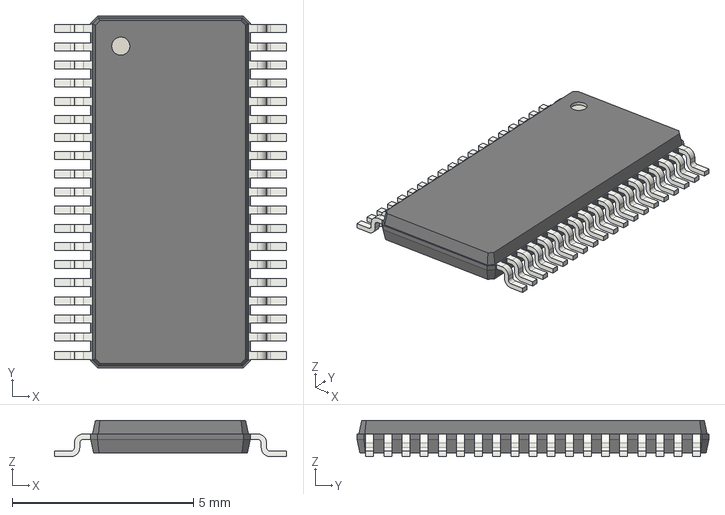
[picture p122: CAD file, 2025-03-11]
3dmodel/sop/SOP50P640X970-38.step
6.40 x 9.70 x 1 mm
