Esmartdriver/esmart-hw-lib-pub/3dmodel/sot/SOT65P280X100-8.step

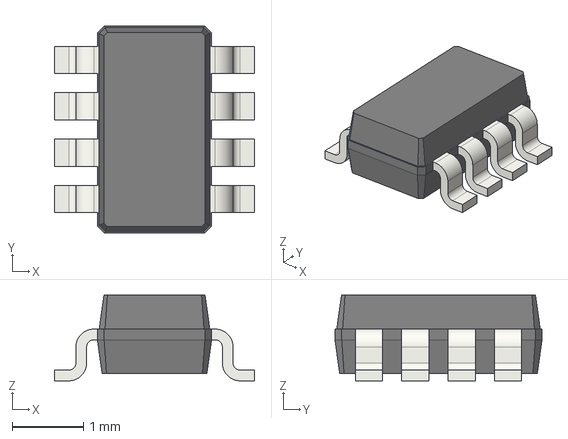
[picture p123: CAD file, 2025-03-11]
3dmodel/sot/SOT65P280X100-8.step
2.80 x 2.90 x 1.20 mm
