Esmartdriver/esmart-hw-lib-pub/3dmodel/to/TO-252-2.step

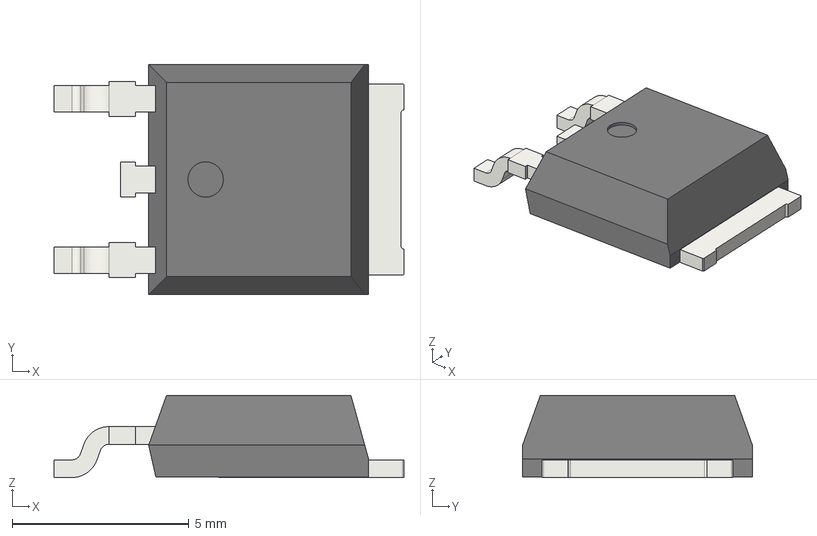
[picture p124: CAD file, 2025-03-11]
3dmodel/to/TO-252-2.step
9.90 x 6.50 x 2.32 mm
