Esmartdriver/esmart-hw-lib-pub/3dmodel/bga/BGA192N40P16X16_700X700X83.step

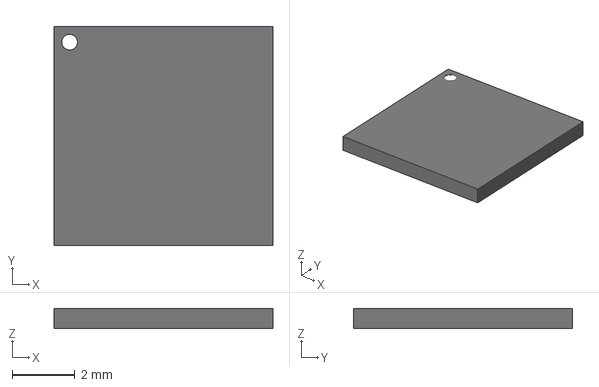
[picture p125: CAD file, 2025-03-11]
3dmodel/bga/BGA192N40P16X16_700X700X83.step
7.00 x 7.00 x 0.65 mm
