Esmartdriver/esmart-hw-lib-pub/3dmodel/connector/Amphenol_57102-F10-03LF.step

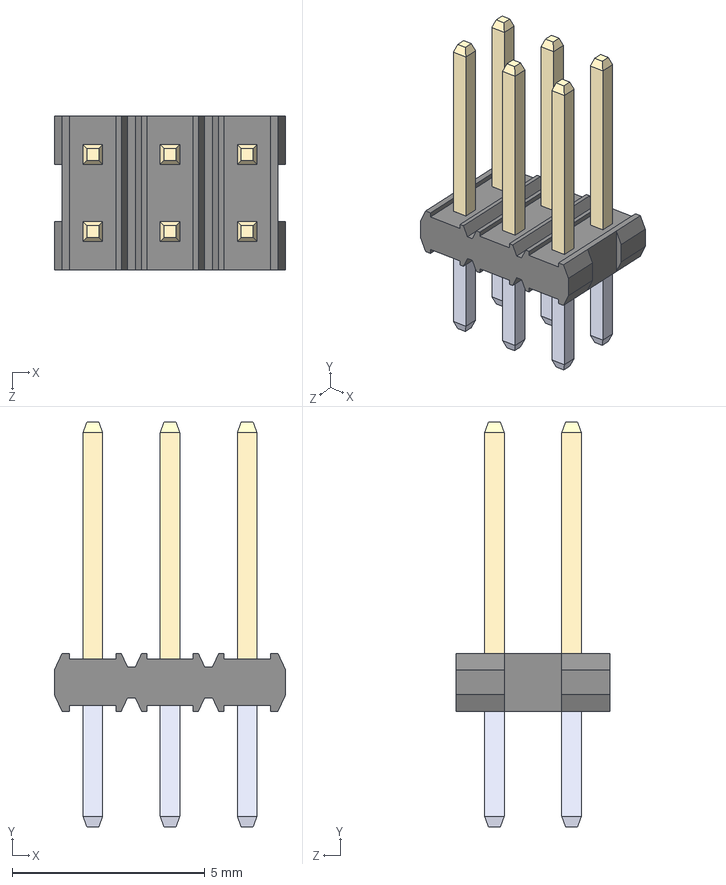
[picture p126: CAD file, 2025-03-11]
3dmodel/connector/Amphenol_57102-F10-03LF.step
6.00 x 10.5 x 4.00 mm
