Esmartdriver/esmart-hw-lib-pub/3dmodel/dfn/DFN300X200X90-9.step

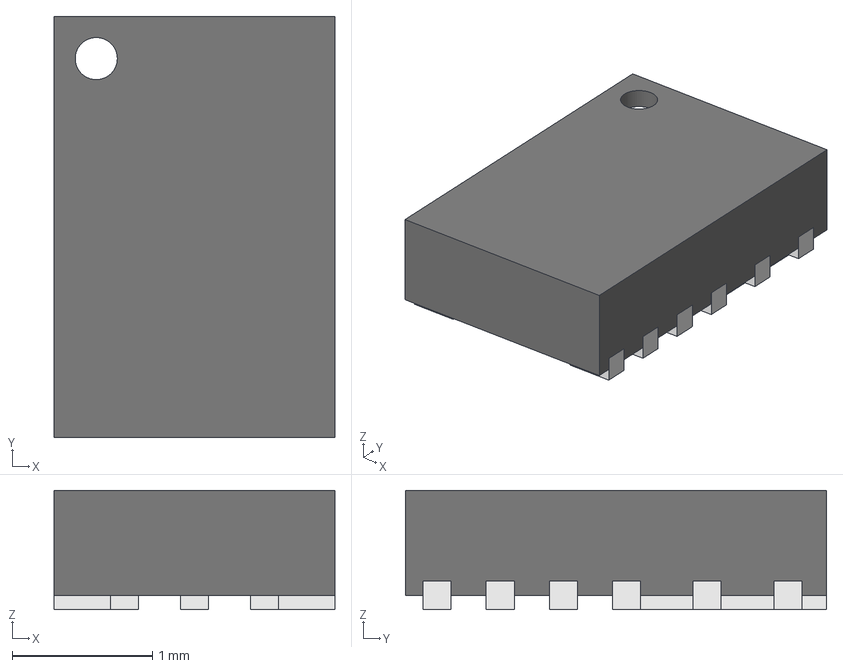
[picture p127: CAD file, 2025-03-11]
3dmodel/dfn/DFN300X200X90-9.step
2.00 x 3.00 x 0.85 mm
