Esmartdriver/esmart-hw-lib-pub/3dmodel/led/LTST-E263CEGBK.step

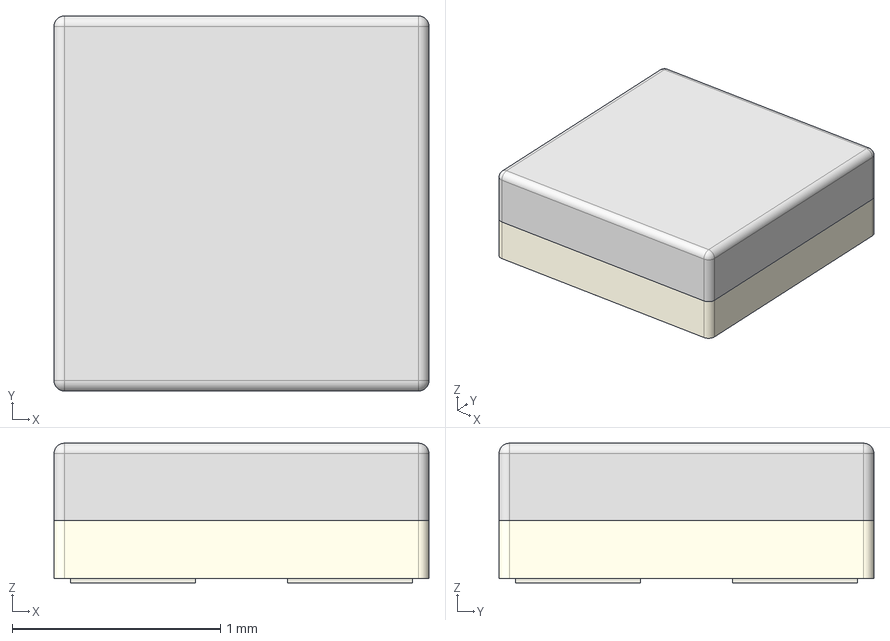
[picture p128: CAD file, 2025-03-11]
3dmodel/led/LTST-E263CEGBK.step
1.80 x 1.80 x 0.67 mm
