Esmartdriver/esmart-hw-lib-pub/3dmodel/mechanical/TP_0.75mm.step

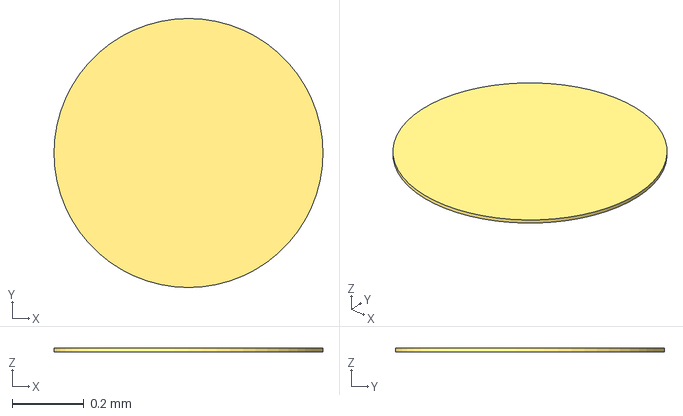
[picture p129: CAD file, 2025-03-11]
3dmodel/mechanical/TP_0.75mm.step
0.75 x 0.75 x 0.01 mm
