Esmartdriver/esmart-hw-lib-pub/3dmodel/other/Microchip_MIC28514.step

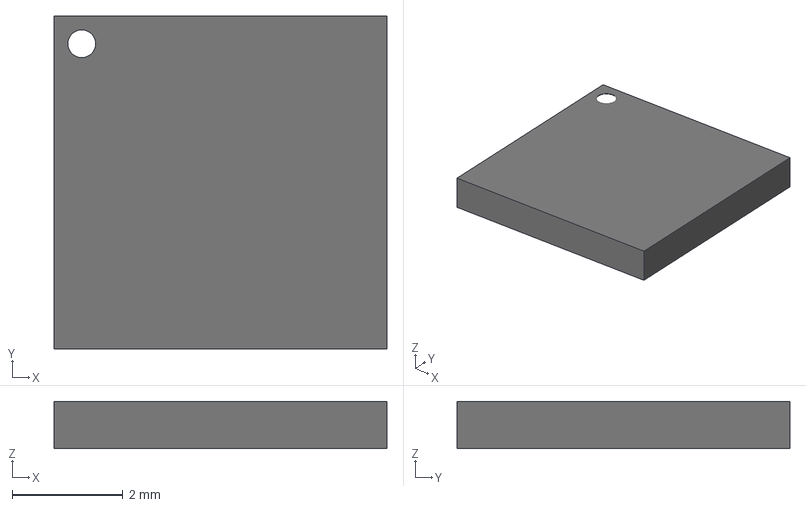
[picture p130: CAD file, 2025-03-11]
3dmodel/other/Microchip_MIC28514.step
6.00 x 6.00 x 0.85 mm
