Esmartdriver/esmart-hw-lib-pub/3dmodel/passive/Bourns_SRP1270.stp

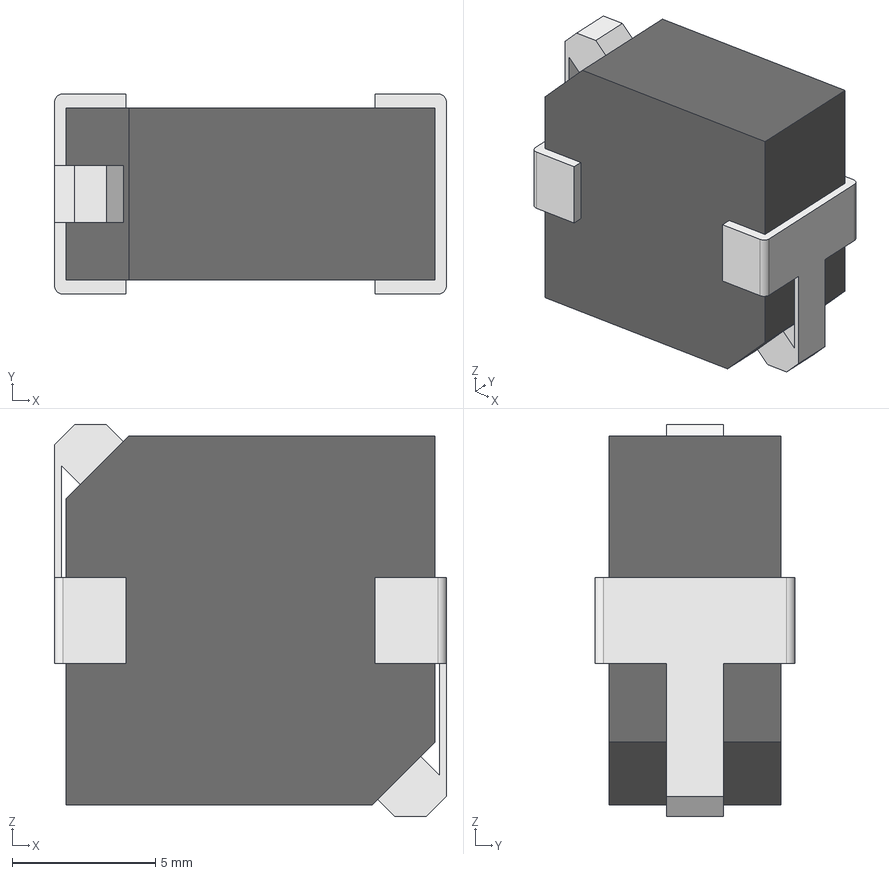
[picture p131: CAD file, 2025-03-11]
3dmodel/passive/Bourns_SRP1270.stp
13.7 x 7.00 x 13.7 mm
