Esmartdriver/esmart-hw-lib-pub/3dmodel/sod/SOD-123.step

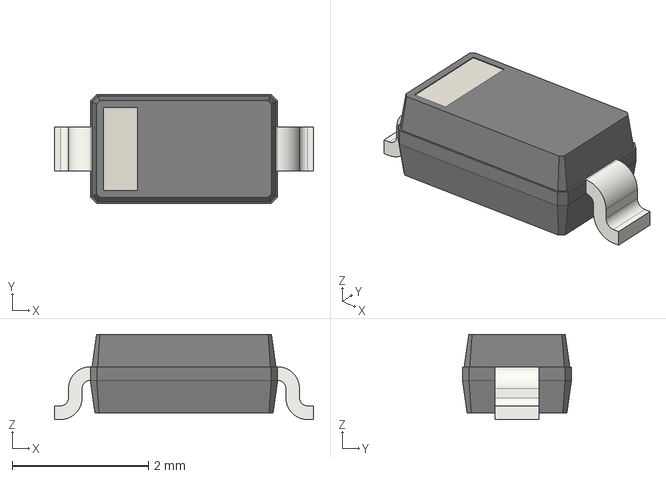
[picture p132: CAD file, 2025-03-11]
3dmodel/sod/SOD-123.step
3.80 x 1.60 x 1.25 mm
