Esmartdriver/esmart-hw-lib-pub/3dmodel/som/ublox_CAM.step

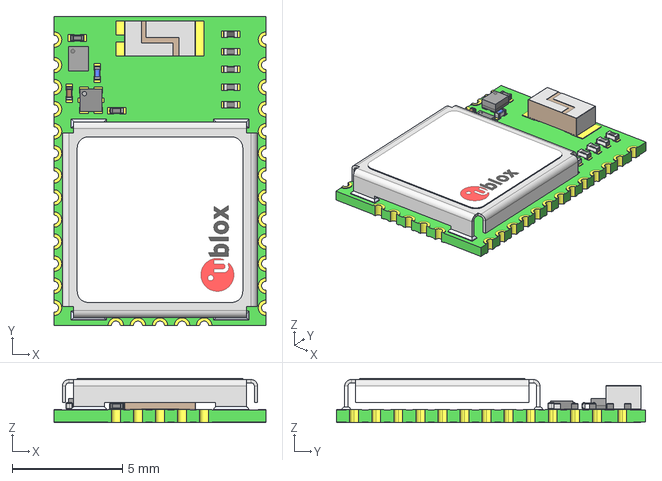
[picture p133: CAD file, 2025-03-11]
3dmodel/som/ublox_CAM.step
9.60 x 14.0 x 2.00 mm
