Esmartdriver/esmart-hw-lib-pub/3dmodel/sop/SOP65P640X500-14.step

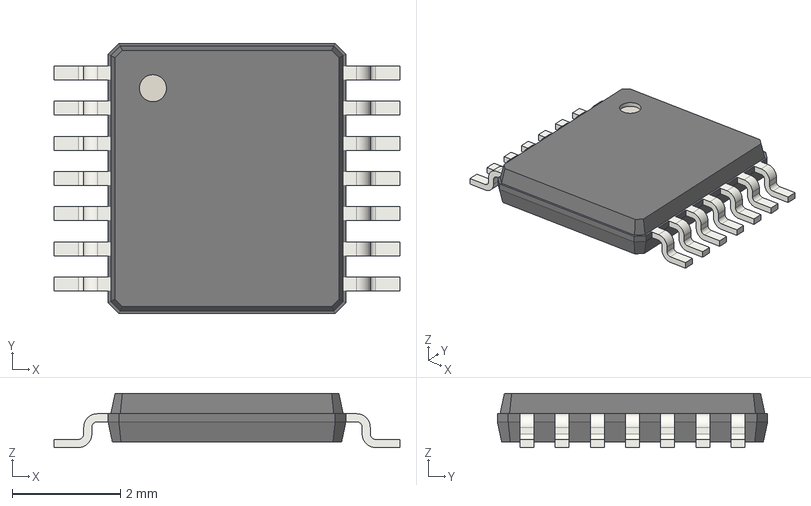
[picture p134: CAD file, 2025-03-11]
3dmodel/sop/SOP65P640X500-14.step
6.40 x 5.00 x 1 mm
