Esmartdriver/esmart-hw-lib-pub/3dmodel/sot/SOT50P160X80-5.step

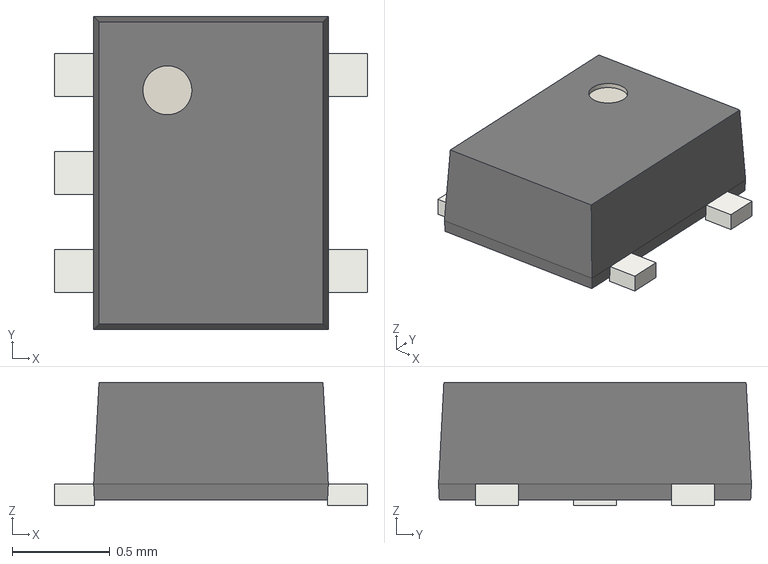
[picture p135: CAD file, 2025-03-11]
3dmodel/sot/SOT50P160X80-5.step
1.60 x 1.60 x 0.63 mm
