Esmartdriver/esmart-hw-lib-pub/3dmodel/to/TO-220-3_horz_tabup.step

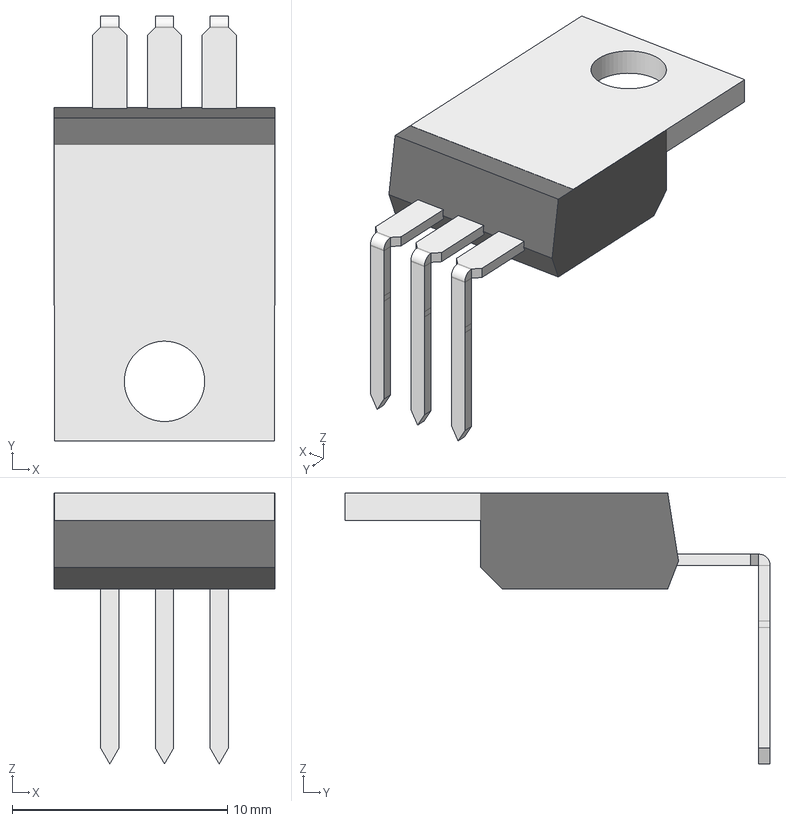
[picture p136: CAD file, 2025-03-11]
3dmodel/to/TO-220-3_horz_tabup.step
10.2 x 19.7 x 12.6 mm
