Esmartdriver/esmart-hw-lib-pub/3dmodel/bga/BGA201N65P15X15_1000X1000X600.step

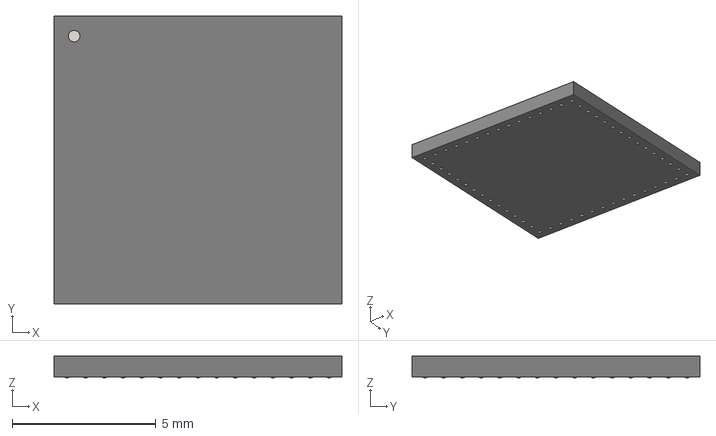
[picture p137: CAD file, 2025-03-11]
3dmodel/bga/BGA201N65P15X15_1000X1000X600.step
10.0 x 10.0 x 0.758 mm
