Esmartdriver/esmart-hw-lib-pub/3dmodel/connector/Molex_5019516010.stp

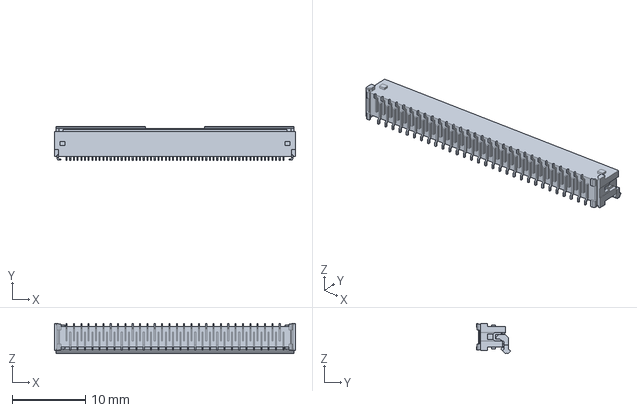
[picture p138: CAD file, 2025-03-11]
3dmodel/connector/Molex_5019516010.stp
32.8 x 4.60 x 4.13 mm
