Esmartdriver/esmart-hw-lib-pub/3dmodel/dfn/DFN120X120X50-3.step

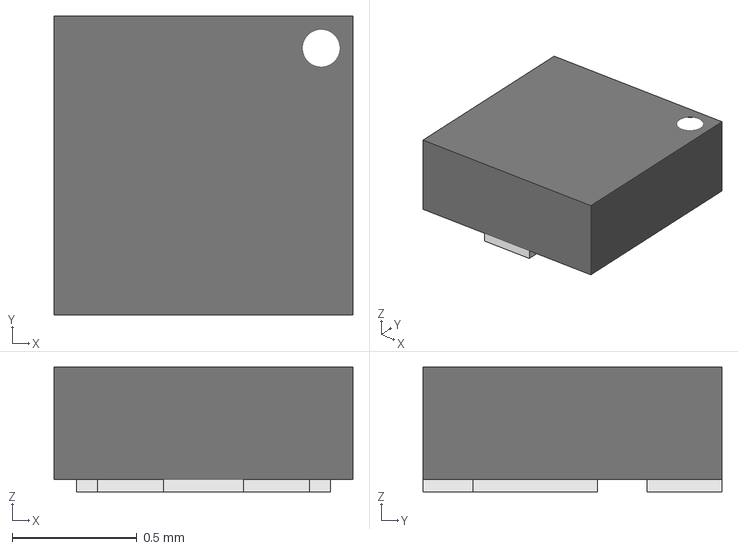
[picture p139: CAD file, 2025-03-11]
3dmodel/dfn/DFN120X120X50-3.step
1.20 x 1.20 x 0.5 mm
