Esmartdriver/esmart-hw-lib-pub/3dmodel/led/Inolux_IN-PI42TASPRPGPB.step

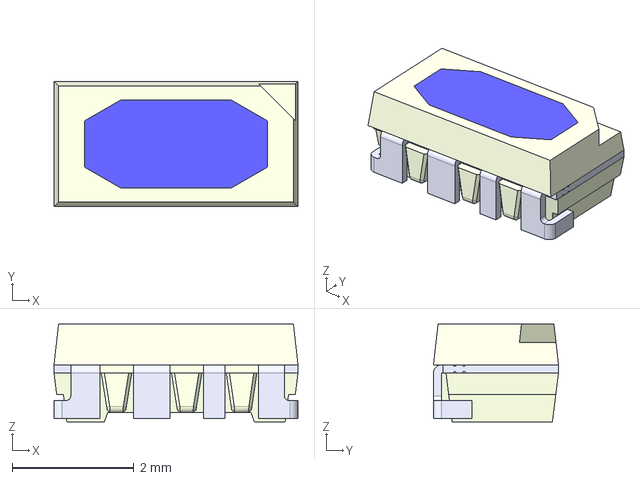
[picture p140: CAD file, 2025-03-11]
3dmodel/led/Inolux_IN-PI42TASPRPGPB.step
4.00 x 2.05 x 1.60 mm
