Esmartdriver/esmart-hw-lib-pub/(list of files, cad)

Other CAD files:
3dmodel/led/LED_1608m_Orange.step
3dmodel/qfp/QFP80P700X700X120-32.step
3dmodel/led/LED_REEgreen_1005.step
3dmodel/led/LED_1608m_Red.step
3dmodel/so/PowerPAK_SO-8-Dual.step
3dmodel/connector/CalTest_CT3149-4.STEP
3dmodel/led/LED_REEyellow_1005.step
3dmodel/qfn/QFN50P300X300-17.step
3dmodel/bga/BGA112N80P11X11_1000X1000X130.step
3dmodel/bga/BGA125N50P13X13_700X700X87.step
3dmodel/bga/BGA144N80P12X12_1000X1000X60.step
3dmodel/bga/BGA153N50P14X14_1300X1150.step
3dmodel/bga/BGA216N80P15X15_1300X1300X110.step
3dmodel/bga/BGA256N127P16X16_2100X2100X308.step
3dmodel/bga/BGA256N80P16X16_1300X1300X104.step
3dmodel/bga/BGA4N50P2X2_96X96X60.step
3dmodel/bga/BGA64N65P8X8_600X600X120.step
3dmodel/bga/BGA64N80P8X8_700X700X140.step
3dmodel/bga/BGA6N50P2X3_150X150X68.step
3dmodel/bga/BGA98N13X13_700X700X97.step
3dmodel/bga/BGA_phytec_somdsc_imx8mp.step
3dmodel/connector/10132797-025100LF.stp
3dmodel/connector/10132798-021100LF.stp
3dmodel/connector/20021121-00010XXLFc.stp
3dmodel/connector/3M_37208-62A3-004PL.stp
3dmodel/connector/AMASS_XT60-F.step
3dmodel/connector/AMASS_XT60-M.step
3dmodel/connector/AMASS_XT60PW-F.STEP
3dmodel/connector/AMASS_XT60PW-M.STEP
3dmodel/connector/APP_1335G1.STEP
3dmodel/connector/APP_PP1545-BLACK.step
3dmodel/connector/APP_PP1545-BLUE.step
3dmodel/connector/APP_PP1545-BROWN.step
3dmodel/connector/APP_PP1545-GREEN.step
3dmodel/connector/APP_PP1545-GREY.step
3dmodel/connector/APP_PP1545-ORANGE.step
3dmodel/connector/APP_PP1545-PINK.step
3dmodel/connector/APP_PP1545-PURPLE.step
3dmodel/connector/APP_PP1545-RED.step
3dmodel/connector/APP_PP1545-WHITE.step
3dmodel/connector/APP_PP1545-YELLOW.step
3dmodel/connector/APP_PP45-BLACK-PCB.step
3dmodel/connector/APP_PP45-BLUE-PCB.step
3dmodel/connector/APP_PP45-GREEN-PCB.step
3dmodel/connector/APP_PP45-ORANGE-PCB.step
3dmodel/connector/APP_PP45-RED-PCB.step
3dmodel/connector/APP_PP45-YELLOW-PCB.step
3dmodel/connector/APP_PP75-BLACK.step
3dmodel/connector/APP_PP75-BLUE.step
3dmodel/connector/APP_PP75-GREEN.step
3dmodel/connector/APP_PP75-ORANGE.step
3dmodel/connector/APP_PP75-RED.step
3dmodel/connector/APP_PP75-WHITE.step
3dmodel/connector/APP_PP75-YELLOW.step
3dmodel/connector/AmphenolRF_FA1-NZRP-PCB-8_Fakra.stp
3dmodel/connector/Amphenol_112116.stp
3dmodel/connector/Amphenol_112404.stp
3dmodel/connector/Amphenol_31-5329-52RFX.stp
3dmodel/connector/Amphenol_87520-0010BLFc.stp
3dmodel/connector/Amphenol_SFW15R-1STE1LF.step
3dmodel/connector/Amphenol_UE27AC54100.step
3dmodel/connector/CNCTech_3210-10-003-12-00.step
3dmodel/connector/CNCTech_3220-10-0100-00.step
3dmodel/connector/CNCTech_3220-10-0200-00.step
3dmodel/connector/CNCTech_3220-20-0100-00.step
3dmodel/connector/CNCTech_3221-10-0300-00.step
3dmodel/connector/CNCTech_3221-20-0300-00.step
3dmodel/connector/CNCTech_3230-10-0103-00.step
3dmodel/connector/CNCTech_3230-20-0103-00.step
3dmodel/connector/CUI_PJ-037B.step
3dmodel/connector/CUI_PJ-051AH.step
3dmodel/connector/CUI_PJ-063BH.step
3dmodel/connector/CUI_PJ-069B-SMT-TR.step
3dmodel/connector/CUI_PJ-102AH.step
3dmodel/connector/CUI_PJ-202BH.step
3dmodel/connector/CUI_UP2-AH-1-TH.step
3dmodel/connector/CalTest_CT3149-0.STEP
3dmodel/connector/CalTest_CT3149-1.STEP
3dmodel/connector/CalTest_CT3149-2.STEP
3dmodel/connector/CalTest_CT3149-5.STEP
3dmodel/connector/CalTest_CT3149-6.STEP
3dmodel/connector/CalTest_CT3149-7.STEP
3dmodel/connector/CalTest_CT3149-9.STEP
3dmodel/connector/CalTest_CT3151SP-Black.step
3dmodel/connector/CalTest_CT3151SP-Blue.step
3dmodel/connector/CalTest_CT3151SP-Green.step
3dmodel/connector/CalTest_CT3151SP-Red.step
3dmodel/connector/CalTest_CT3151SP-White.step
3dmodel/connector/CalTest_CT3151SP-Yellow.step
3dmodel/connector/CalTest_CT3151V1-0.step
3dmodel/connector/DF40C-30DS.stp
3dmodel/connector/DF40C-40DP.stp
3dmodel/connector/DF40HC(4.0)-40DS.stp
3dmodel/connector/FCI_10118242-001RLF.STP
3dmodel/connector/FCI_62684-502100alf.stp
3dmodel/connector/GCT_USB4110-GF-A.stp
3dmodel/connector/GCT_USB4120-03-C.stp
3dmodel/connector/GCgamepad.step
3dmodel/connector/GFC_USB4085-GF-A.STEP
3dmodel/connector/Harwin_m20-8890645.stp
3dmodel/connector/Hirose_DF52-4S-0.8H.stp
3dmodel/connector/Hirose_DF52-6P-0.8C.stp
3dmodel/connector/Hirose_DF52-6S-0.8H.stp
3dmodel/connector/Hirose_HIF6A-20PA-1.27DS.stp
3dmodel/connector/JAE_K3D-DX07B024JJ1.STEP
3dmodel/connector/JST_BM04B-SRSS-TB.STEP
3dmodel/connector/JST_BM05B-SRSS-TB.STEP
3dmodel/connector/JST_BM06B-SRSS-TB.STEP
3dmodel/connector/JST_BM08B-SRSS-TB.STEP
3dmodel/connector/JST_BM12B-SRSS-TB.STEP
3dmodel/connector/JST_S4B-EH.STEP
3dmodel/connector/JST_S6B-ZR-SM4A-TF.STEP
3dmodel/connector/JST_SHR-04V-S-B.STEP
3dmodel/connector/JST_SHR-05V-S-B.STEP
3dmodel/connector/JST_SHR-06V-S-B.STEP
3dmodel/connector/JST_SHR-08V-S-B.STEP
3dmodel/connector/JST_SHR-12V-S-B.STEP
3dmodel/connector/JST_SM04B-SRSS-TB.STEP
3dmodel/connector/JST_SM06B-SRSS-TB.STEP
3dmodel/connector/JST_SM08B-SRSS-TB.STEP
3dmodel/connector/JST_SM12B-SRSS-TB.STEP
3dmodel/connector/JST_ZHR-6.STEP
3dmodel/connector/Kycon_KMMX-AB10-SMT1SB30TR_A.STEP
3dmodel/connector/Kycon_KUSBVX-AS2N.step
3dmodel/connector/LEDSTR_CONNECTOR_FEMALE.step
3dmodel/connector/METZ_SR99S01VBNN00.step
3dmodel/connector/METZ_SR99S01VBNN01.step
3dmodel/connector/METZ_SR99S01VBNN02.step
3dmodel/connector/METZ_SR99S01VBNN03.step
3dmodel/connector/METZ_SR99S01VBNN05.step
3dmodel/connector/Molex_022122081.step
3dmodel/connector/Molex_026481032.stp
3dmodel/connector/Molex_039301040.stp
3dmodel/connector/Molex_0428788410.stp
3dmodel/connector/Molex_0470531000.stp
3dmodel/connector/Molex_1040310811.stp
3dmodel/connector/Molex_1042240820.stp
3dmodel/connector/Molex_1053081204.stp
3dmodel/connector/Molex_1053101204.stp
3dmodel/connector/Molex_1053141204.stp
3dmodel/connector/Molex_1718570003.stp
3dmodel/connector/Molex_1724470204.stp
3dmodel/connector/Molex_2171790001.stp
3dmodel/connector/Molex_353120260.stp
3dmodel/connector/Molex_395000003.stp
3dmodel/connector/Molex_395021003.stp
3dmodel/connector/Molex_484050003.stp
3dmodel/connector/Molex_484080003.stp
3dmodel/connector/Molex_5019513000.stp
3dmodel/connector/Molex_541324062.step
3dmodel/connector/Molex_678008025.stp
3dmodel/connector/Molex_705530004.stp
3dmodel/connector/Molex_731000133.stp
3dmodel/connector/Molex_731375003.stp
3dmodel/connector/Molex_733910070.stp
3dmodel/connector/Molex_734036510_Fakra.step
3dmodel/connector/Molex_75783-001.stp
3dmodel/connector/Molex_788000001.stp
3dmodel/connector/Molex_874380243.stp
3dmodel/connector/Molex_874390200.stp
3dmodel/connector/N64gamepad.step
3dmodel/connector/NGFF_M2_CONN4P2_A.stp
3dmodel/connector/NGFF_M2_CONN4P2_B.stp
3dmodel/connector/NGFF_M2_CONN4P2_E.stp
3dmodel/connector/NGFF_M2_CONN4P2_M.stp
3dmodel/connector/PanelMounted-HexBaseBNC.STEP
3dmodel/connector/PinHeader_1x01_P1.27mm_Vertical.step
3dmodel/connector/PinHeader_1x01_P2.54mm_Vertical.step
3dmodel/connector/PinHeader_1x02_P1.27mm_Vertical.step
3dmodel/connector/PinHeader_1x02_P2.00mm_Vertical.step
3dmodel/connector/PinHeader_1x02_P2.54mm_Vertical.step
3dmodel/connector/PinHeader_1x03_P1.27mm_Vertical.step
3dmodel/connector/PinHeader_1x03_P2.54mm_Horizontal.step
3dmodel/connector/PinHeader_1x03_P2.54mm_Vertical.step
3dmodel/connector/PinHeader_1x04_P1.27mm_Vertical.step
3dmodel/connector/PinHeader_1x04_P2.54mm_Horizontal.step
3dmodel/connector/PinHeader_1x04_P2.54mm_Vertical.step
3dmodel/connector/PinHeader_1x05_P1.27mm_Vertical.step
3dmodel/connector/PinHeader_1x05_P2.54mm_Vertical.step
3dmodel/connector/PinHeader_1x06_P1.27mm_Vertical.step
3dmodel/connector/PinHeader_1x06_P2.54mm_Vertical.step
3dmodel/connector/PinHeader_1x07_P1.27mm_Vertical.step
3dmodel/connector/PinHeader_1x07_P2.54mm_Vertical.step
3dmodel/connector/PinHeader_1x08_P1.27mm_Vertical.step
3dmodel/connector/PinHeader_1x08_P2.54mm_Horizontal.step
3dmodel/connector/PinHeader_1x08_P2.54mm_Vertical.step
3dmodel/connector/PinHeader_1x09_P1.27mm_Vertical.step
3dmodel/connector/PinHeader_1x10_P2.54mm_Vertical.step
3dmodel/connector/PinHeader_1x11_P1.27mm_Vertical.step
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
