Esmartdriver/esmart-hw-lib-pub/(notices)

Notices in the files:
3dmodel/connector/PinHeader_1x09_P2.54mm_Vertical.step:
Copyright (C) 2017, kicad StepUp
This work is licensed under the [Creative Commons CC-BY-SA 4.0 License](https://creativecommons.org/licenses/by-sa/4.0/legalcode),
with the following exception:
To the extent that the creation of electronic designs that use 'Licensed Material' can be considered to be 'Adapted Material',
You are free to use the library data in your own projects without the obligation to share your project files under this or any other license agreement.
3dmodel/diode/Diode_SMA.step:
This program is free software: you can redistribute it and/or modify
it under the terms of the GNU General Public License as published by
the Free Software Foundation, either version 3 of the License, or
any later version.
itself might be covered by the GNU General Public License.
3dmodel/passive/RESC1608.step:
Copyright (C) 2018, kicad StepUp
3dmodel/dip/DIP127P762X508-8.step:
Copyright (C) 2017, your name
3dmodel/sod/SOD-923.step:
Copyright (C) 2019, kicad StepUp
3dmodel/to/TO-252-2.step:
Copyright (C) 2017, Ray Benitez
3dmodel/to/TO-252-3.step:
Copyright (C) 2023, Ray Benitez
This work is licensed under the
[Creative Commons CC-BY-SA 4.0 License](https://creativecommons.org/licenses/by-sa/4.0/legalcode),
project files under this or any other license agreement. However, if you wish to distribute
